olivertiller/KERS-bil/Konseptutvikling_D3.tex

% Delinnlevering D3: Konseptutvikling for lekebilen
% Henter innholdet direkte fra Sections/Concept_development.tex, slik at teksten holdes lik rapporten
\documentclass{article}

% Samme dokumentinnstillinger som rapporten
\usepackage{packages}

\begin{document}

% Enkel tittel i stedet for full tittelside
\begin{center}
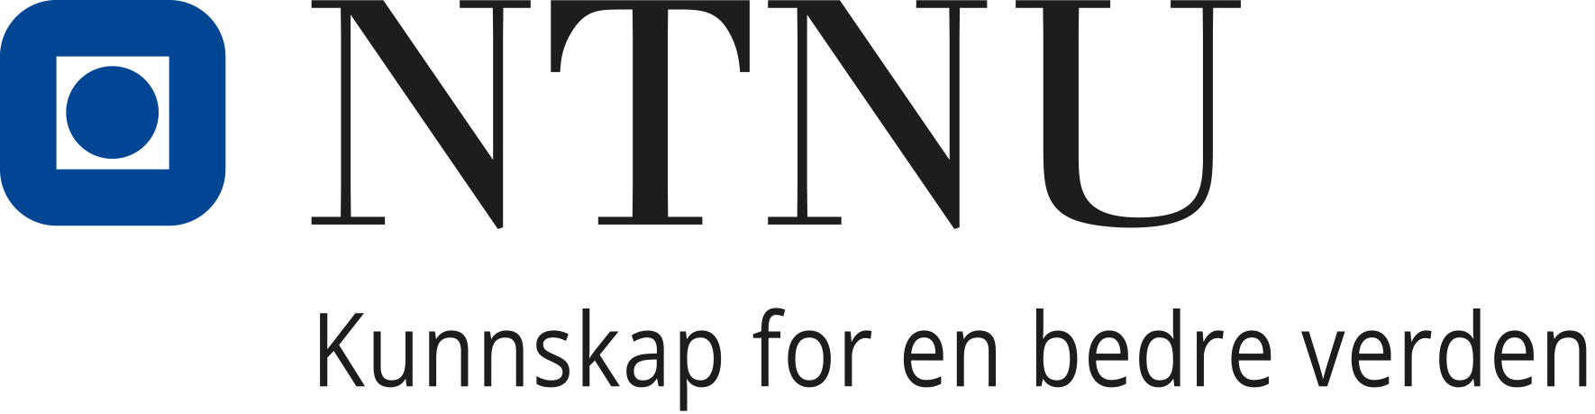
[picture p1: Images/NTNU_logo.png]
\\[0.5cm]
\textsc{\large Semesteroppgave MAST1101 -- høsten 2026}\\[0.3cm]
\HRule \\[0.3cm]
{\LARGE \bfseries Svinghjulsdrevet lekebil}\\[0.2cm]
{\Large D3: Konseptutvikling}\\[0.1cm]
\HRule \\[0.5cm]
{\large Oliver Kvaløy Tiller}\\[0.2cm]
{\large \today}
\end{center}
\vspace{0.3cm}

\import{./Sections/}{Concept_development}

\end{document}
