olivertiller/KERS-bil/Rapport/main.tex

% Author - Jon Arnt Kårstad, NTNU IMT
\documentclass{article}

% Importing document settings from our file "packages.sty"
\usepackage{packages}

% Beginning of document
\begin{document}

% Inserting title page
\hypersetup{pageanchor=false}
\import{./}{title}

% Defining front matter settings (Norsk: innstillinger for forord m.m.)
\frontmatter
\hypersetup{pageanchor=true}

% Forord og sammendrag
\import{./Sections/}{Preface}
\newpage
\import{./Sections/}{Summary}
\newpage

% Inserting table of contents
\tableofcontents

% Inserting list of figures & list of tables
\listoffigures
\listoftables

% Defining main matter settings (Norsk: innstillinger for hoveddelen av teksten)
\mainmatter

% Rapportens hoveddeler, etter IMRaD
% Introduksjon
\import{./Sections/}{Introduction}
\import{./Sections/}{Theory}

% Metode: produktutvikling, konsepter, utvikling av valgt konsept og testmetode
\import{./Sections/}{Product_requirements}
\import{./Sections/}{Product_development}
\import{./Sections/}{Project_planning}
\import{./Sections/}{Concept_development}
\import{./Sections/}{Concept_evaluation}
\import{./Sections/}{Detailed_design}
\import{./Sections/}{Prototyping}
\import{./Sections/}{Experimental_method}

% Resultater
\import{./Sections/}{Results}

% Diskusjon og konklusjon
\import{./Sections/}{Discussion}
\import{./Sections/}{Future_work}
\import{./Sections/}{Conclusion}
\import{./Sections/}{AI_use}

% Printing bibliography
\newpage
\printbibliography[heading = bibintoc, title = Referanser]    % 'bibintoc' inserts our bibliography into the table of contents

% Inserting appendix with separate settings
\addappendix
\import{./Appendices/}{Project_appendices}

% End of document
\end{document}
