olivertiller/KERS-bil/Rapport/title.tex

% Inspired by title template from ShareLaTeX Learn; Gubert Farnsworth & John Doe
% Edited by Jon Arnt Kårstad, NTNU IMT

\begin{titlepage}
\vbox{ }
\vbox{ }
\begin{center}
% Upper part of the page
\\[1cm]
\textsc{\LARGE Norges teknisk-naturvitenskapelige universitet}\\[1.5cm]
\textsc{\Large Semesteroppgave MAST1101 -- høsten 2026}\\[0.5cm]
\vbox{ }

% Title
\HRule \\[0.4cm]
{ \huge \bfseries Svinghjulsdrevet lekebil}\\[0.4cm]
\HRule \\[1.5cm]

% Author
\large
\emph{Forfatter:}\\
Oliver Kvaløy Tiller
\vfill

% Bottom of the page
{\large Høsten 2026}
\end{center}
\end{titlepage}
