olivertiller/KERS-bil/Rapport/Sections/AI_use.tex

\newpage
\section{Bruk av kunstig intelligens}
\label{sec:ki}
Claude (Anthropic) er brukt som programmeringsassistent i Claude Code. Verktøyet er brukt til:
\begin{itemize}
    \item Det enkle simuleringsskriptet for kjøringen og behandlingen av måledataene fra utsnurringen.
    \item Programmet for ESP32-en som logger Hall-sensoren, og skriptene som leser dataene over USB.
    \item Hjelp med oppsettet for generativ design og drivverket i Fusion.
    \item Generering av figurer, blant annet plottene av måledataene, prosessfiguren og kraftskissen.
    \item Finne skrivefeil, lage forbedrede tekstformuleringer og omstrukturering av rapportens disposisjon.
\end{itemize}
