olivertiller/KERS-bil/Rapport/Sections/Summary.tex

\section*{Sammendrag}
\addcontentsline{toc}{section}{Sammendrag}
Rapporten beskriver utviklingen av en lekebil som drives av et utdelt stålsvinghjul på Ø60 × 6 mm, og som skal kjøre lengst mulig etter ett opptrekk med 20 cm snor. Problemstillingen er om bilen, utviklet gjennom iterative prototyper innenfor rammene i oppgaven, kan kjøre minst \SI{5}{m} i snitt over ti kjøringer, med under \SI{15}{\percent} spredning og et sideavvik under \SI{10}{\percent} av lengden.

Tre konsepter ble vurdert i en vektet matrise: direkte drift, en trinnløs reim på kjegler og ett fast tannhjulstrinn. Tannhjulstrinnet ble valgt, med 17 : 73 ($i = 4{,}29$), Ø68-hjul og tre Ø6-aksler i 626-lagre. Den ferdige bilen veier \SI{270}{g}. Rammen er laget med generativ design i Fusion og 3D-printet i ett stykke. Lagersetet, festet av nav på aksel, snortrommelen og hjulene ble utviklet i små iterasjoner med prøvebiter. En enkel simulering ble brukt til å sammenligne alternativer, og en ESP32 med Hall-sensor ble brukt som hjelpeverktøy for å måle turtallet til svinghjulet.

Opptrekk med snor ga rundt \SI{2700}{o/min}, uavhengig av trommeldiameteren, og lagrene på svinghjulsakselen ga en åttendedel av det opprinnelige tapet etter at tetningene og fettet var fjernet og lagrene var kjørt inn.

I den første kjøretesten kjørte bilen \SI[separate-uncertainty=true]{5,5 \pm 1,4}{m} i fem forsøk og dro til venstre i fire av dem. En papirtest viste at den printede rammen er vridd, slik at høyre drivhjul bærer mesteparten av lasten og tar mest av drivkraften. Etter at lagersetet for høyre drivhjul ble filt for å jevne ut lasten, kjørte bilen \SI[separate-uncertainty=true]{8,8 \pm 1,8}{m} i ti forsøk, med \SI{21}{\percent} spredning, og alle ti var vellykkede. Målene for distanse og pålitelighet er dermed nådd. Bilen dro fortsatt til venstre, med et sideavvik på \SI{24}{\percent} av lengden, og verken spredningen eller sideavviket oppfyller målene. De neste tiltakene er en foraksel som kan vippe, eller tre hjul, og et jevnere opptrekk.

\begin{center}
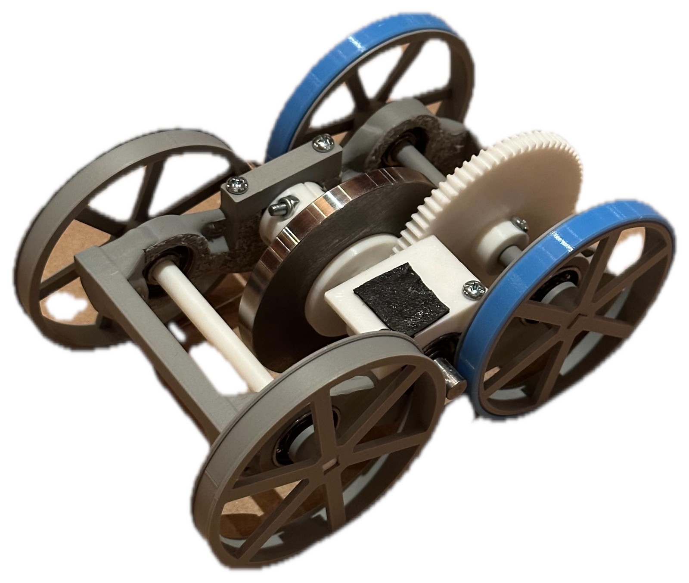
[picture p2: Rapport/Images/Foto/Ferdig/bil_sammendrag.jpg]
    
    \captionof*{figure}{Den ferdige bilen.}
\end{center}
