olivertiller/KERS-bil/Rapport/Sections/Prototyping.tex

\subsection{Prototyping og produksjon}
\label{sec:prototyping}
De fysiske delene er lagersetet, festet mellom nav og aksel, snortrommelen og drivhjulene. De er utviklet etter metoden i seksjon~\ref{sec:iterativ-prototyping}, og alle bygger på drivverket fra seksjon~\ref{sec:dv-serien}. Figur~\ref{fig:prototype} viser prototypen slik den er brukt i utsnurringstestene, med den generative rammen fra seksjon~\ref{sec:gd-ramme}, svinghjul, tannhjulspar og måleoppsett.

\begin{figure}[H]
    \centering
    \begin{subfigure}[b]{0.56\textwidth}
        \centering
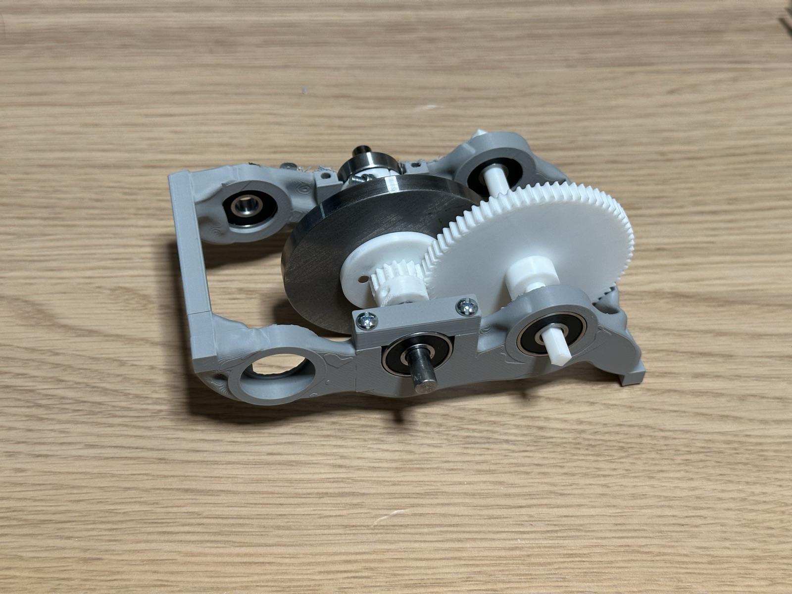
[picture p3: Rapport/Images/Foto/prototype_skraatt.jpg]
        
        \caption{Skrått forfra}
    \end{subfigure}
    \hspace{1.5em}
    \begin{subfigure}[b]{0.315\textwidth}
        \centering
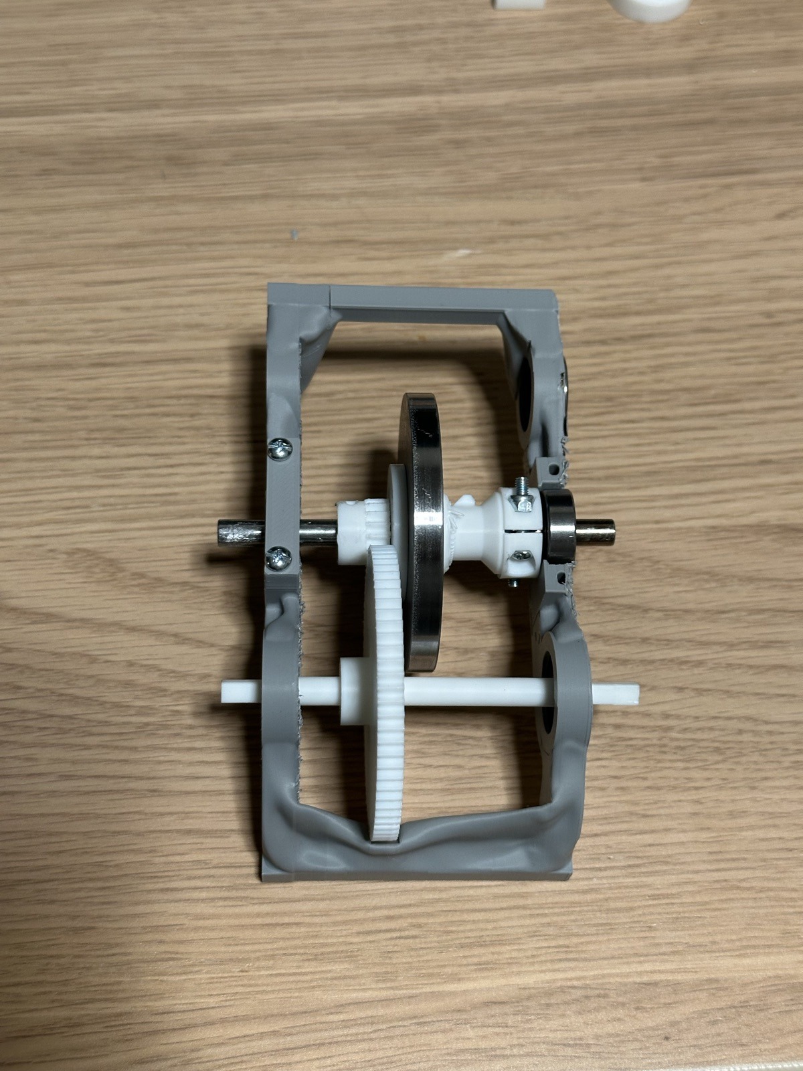
[picture p4: Rapport/Images/Foto/prototype_ovenfra.jpg]
        
        \caption{Ovenfra}
    \end{subfigure}
    \caption[Prototypen i den 3D-printede rammen]{Prototypen med svinghjul, pinjong og tannhjul i den 3D-printede rammen.}
    \label{fig:prototype}
\end{figure}

\subsubsection{Lagersete}
\label{sec:ls-serien}
De seks 626-lagrene har ytterdiameter \SI{19}{mm} og sitter i rammen. Setet må holde lageret fast uten å klemme det så hardt at det går tungt. Siden 3D-printede hull krymper litt, kan ikke nominelle mål fra CAD brukes direkte. Det ble derfor printet fem prøveringer fra Ø18,9 til Ø19,3 mm i trinn på \SI{0,1}{mm}, merket med ett til fem hakk og printet i samme retning som rammen (figur~\ref{fig:lager-proevering}).

% TODO: Bilde av alle prøvebitene
Ø19,0 gikk stramt inn, mens Ø19,1 var passe romslig og ble valgt i rammen (seksjon~\ref{sec:gd-ramme}).

\begin{figure}[H]
    \centering
    
    \caption[Prøvering for lagersetet]{626-lager i en av prøveringene for lagersetet.}
    \label{fig:lager-proevering}
\end{figure}

\begin{comment}
\begin{table}[H]
    \centering
    \caption{Målt diameter på lagerseter i prøvebiten}
    \label{tab:ls0-toleranse}
    \small
    \renewcommand{\arraystretch}{1.3}
    \begin{tabular}{|c|c|c|l|}
        \hline
        \textbf{Tegnet [mm]} & \textbf{Målt [mm]} & \textbf{Avvik [mm]} & \textbf{Pasning med lager} \\
        \hline
        18,8 & & & \\
        \hline
        18,9 & & & \\
        \hline
        19,0 & & & \\
        \hline
        19,1 & & & \\
        \hline
        19,2 & & & \\
        \hline
        19,3 & & & \\
        \hline
        19,4 & & & \\
        \hline
    \end{tabular}
\end{table}

\begin{versjonstabell}{lagersetet}{tab:ls1}
    \hovedtest
    Lageret sitter fast og går lett (R8) & \\
    \tilleggstester
    Lageret kan tas ut og settes inn igjen (R7) & \\
    Akslene er parallelle etter montering & \\
\end{versjonstabell}
\end{comment}

\subsubsection{Feste av nav på aksel}
\label{sec:nv-serien}
Pinjongen, tannhjulet, trommelen og hjulene festes til Ø6-akslene. Delene kan ikke ha D-hull, fordi de må tres forbi de runde lagersetene på akselen.

\begin{description}
    \item[Klemnav.] Brukes på trommelen og pinjongen (figur~\ref{fig:klemnav}). Navet er Ø20 med Ø6,2-hull og to slisser på \SI{1}{mm}. To M3 × 12-skruer går på tvers av slissene og strammes mot muttere i sekskantlommer. Skruene er plassert 180° fra hverandre for å holde navet i balanse. Navet kan løsnes og skyves langs akselen, noe som gjør det mulig å justere delene sideveis (R7).
    \item[Firkantnav.] Brukes på hjulene. Hjulakslene er 3D-printet med Ø6 og har en firkant på 4 × 4 × \SI{10}{mm} i hver ende. Diagonalen er \SI{5,66}{mm}, mindre enn Ø6. Hjulet tres på firkanten og kan ikke slure.
\end{description}

Firkanthullet ble bestemt med en prøvebit på samme måte som lagersetet, med fire hull fra \SI{4,0}{mm} til \SI{4,3}{mm} i trinn på \SI{0,1}{mm}, merket med én til fire streker. Hullet på \SI{4,3}{mm} ga best pasning på den printede akselenden og er brukt i hjulene. Hullene har små fristikk i hjørnene for at firkanten på akselen skal gå helt inn.

\begin{figure}[H]
    \centering
    \begin{subfigure}[b]{0.42\textwidth}
        \centering
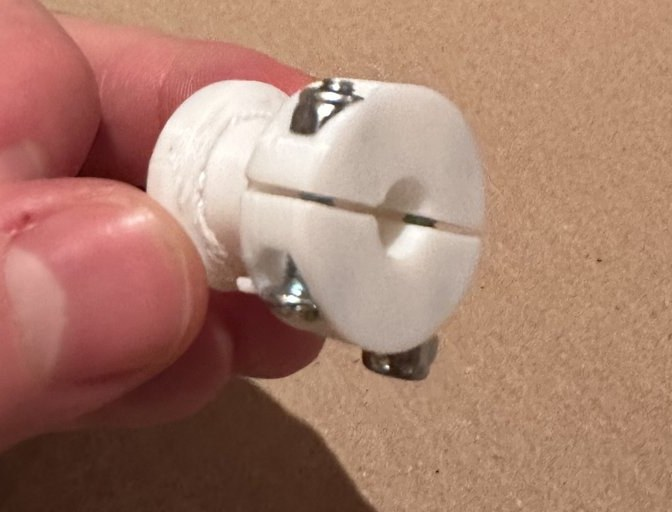
[picture p5: Rapport/Images/Foto/Ferdig/klemnav.jpg]
        
        \caption{Klemnav på snortrommelen}
        \label{fig:klemnav}
    \end{subfigure}
    \hspace{1.5em}
    \begin{subfigure}[b]{0.3\textwidth}
        \centering
        
        \caption{Prøvebit for firkanthullet}
        \label{fig:firkanttest}
    \end{subfigure}
    \caption[Klemnav og prøvebiten for firkanthullet]{(a) Klemnavet med to slisser og to M3-skruer på tvers. (b) Prøvebiten for firkanthullet. Strekene viser størrelsen, fra én strek for \SI{4,0}{mm} til fire for \SI{4,3}{mm}.}
    \label{fig:nav}
\end{figure}

\begin{comment}
\begin{versjonstabell}{firkantnavet}{tab:nv2}
    \hovedtest
    Hjulet slurer ikke på akselen (R6) & \\
    \tilleggstester
    Kan demonteres og monteres flere ganger (R7) & \\
\end{versjonstabell}
\end{comment}

\subsubsection{Snortrommel}
\label{sec:tr-serien}
Svinghjulet spinnes opp med \SI{20}{cm} snor rundt en trommel på svinghjulsakselen. Ved \SI{4000}{o/min} har svinghjulet energien $E = \frac{1}{2} I \omega^2 \approx \SI{5,3}{J}$. Over \SI{20}{cm} snor tilsvarer det en snittkraft på $E/L \approx \SI{26}{N}$, uavhengig av trommelens diameter. Trommelradien $r_t$ bestemmer derimot hvor fort snora må trekkes, siden $v = \omega r_t$. En mindre trommel gir høyere turtall ved samme trekkhastighet, men kraften som trengs underveis øker. Hypotesen er at én trommeldiameter gir høyest turtall for et opptrekk for hånd.

Det er tegnet tre tromler med kjerne Ø12, Ø14 og Ø18, ellers like. Maskintegningen av Ø12-trommelen står i vedlegg~\ref{app:tegninger} (figur~\ref{fig:snortrommel}). Snora festes med en løkke på en liten krok midt i kjernen som peker mot rotasjonsretningen under opptrekket (detalj E), slik at kroken holder løkka på plass så lenge snora strammes. Både undersiden av kroken og innsiden av den ytre flensen har 45° helning for at trommelen skal kunne printes uten support. Den indre flensen har en utsparing som gir plass til sveisekransen mellom svinghjulet og akselen. Trommelen festes med klemnavet fra seksjon~\ref{sec:nv-serien} og veier \SI{3,7}{g}.

For å se om en mindre trommel gir høyere turtall, ble det også laget en trommel med Ø8-kjerne, den minste boringen tillater. Den har et V-formet spor, siden snora legger seg i flere lag, og en skrå tapp i stedet for kroken. Med samme trekkhastighet skulle Ø8 gitt 1,5 ganger turtallet med Ø12.

Hovedtesten er turtallet etter opptrekk, målt med måleoppsettet i seksjon~\ref{sec:ml-serien}, med minst fem opptrekk per trommel. Snitt og standardavvik viser både turtall (R3) og repeterbarhet (R4). Tilleggstester er at snora løsner av seg selv fra trommelen ved enden av opptrekket, og at den ikke sklir av trommelen. Resultatene står i seksjon~\ref{sec:res-opptrekk}.

\begin{figure}[H]
    \centering
    \begin{subfigure}[b]{0.32\textwidth}
        \centering
        
        \caption{Klemnavet med de to M3-skruene}
    \end{subfigure}
    \hfill
    \begin{subfigure}[b]{0.32\textwidth}
        \centering
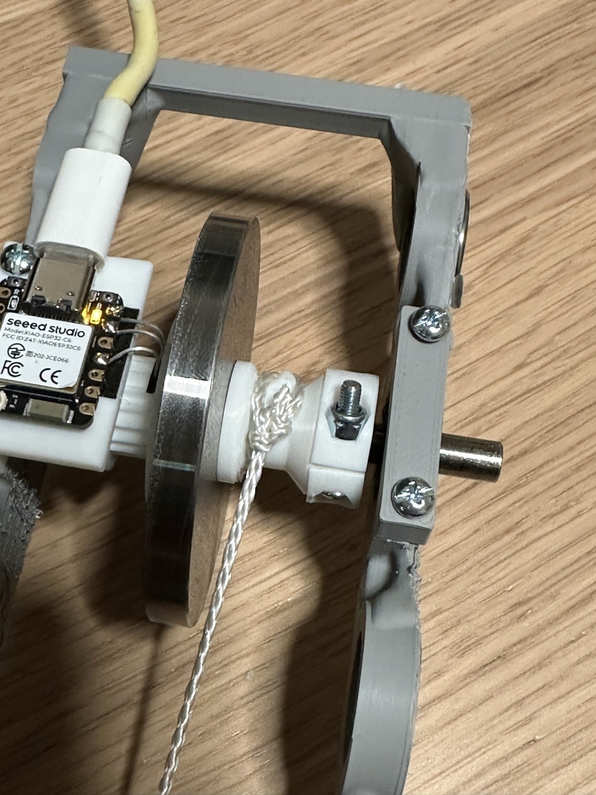
[picture p6: Rapport/Images/Foto/trommel_snor.jpg]
        
        \caption{Snora viklet på trommelen}
    \end{subfigure}
    \hfill
    \begin{subfigure}[b]{0.32\textwidth}
        \centering
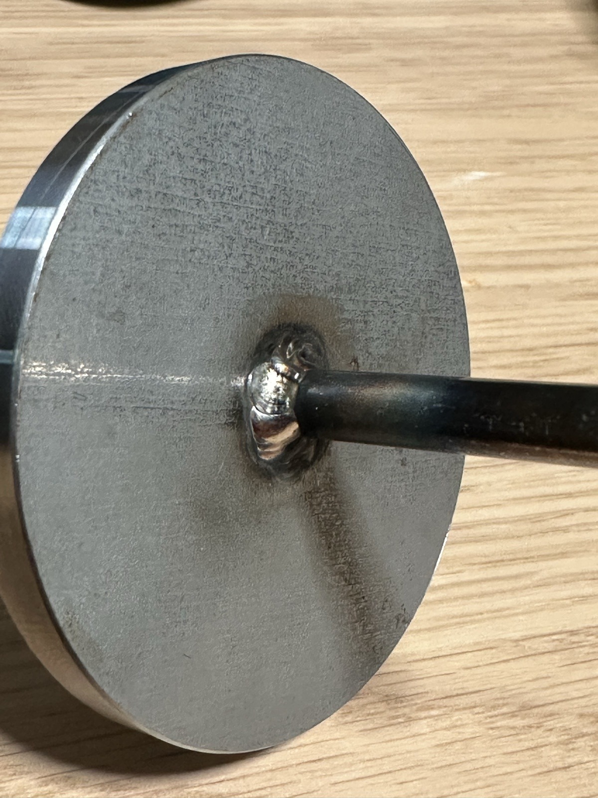
[picture p7: Rapport/Images/Foto/svinghjul_sveis.jpg]
        
        \caption{Sveisekransen mellom svinghjul og aksel}
    \end{subfigure}
    \caption[Ø12-trommelen på svinghjulsakselen]{Ø12-trommelen montert på svinghjulsakselen. Senkningen i den indre flensen gir plass til sveisekransen.}
    \label{fig:tr1-foto}
\end{figure}

\subsubsection{Drivhjul og dekk}
\label{sec:dh-serien}
Drivhjulene har ytre diameter \SI{68}{mm}, fastlagt i drivverket. Når bilen settes ned med svinghjulet i gang, slurer hjulene til farten passer med svinghjulet. Dekket bør derfor ha nok grep til at hjulene får tak raskt og bilen går rett, og samtidig lav rullemotstand.

Alle hjulene har samme nav. Maskintegningen av hjulet med TPU-dekk står i vedlegg~\ref{app:tegninger} (figur~\ref{fig:hjul}). Navet har firkanthullet fra seksjon~\ref{sec:nv-serien} og en krage med diameter \SI{7,8}{mm} på innsiden. Kragen ligger an mot innerringen i lageret, aldri mot ytterringen, og holder akselen på plass sideveis. Seks eiker i en \SI{2}{mm} skive på utsiden holder massen og treghetsmomentet nede, og hjulet printes liggende med utsiden ned.
\begin{description}
    \item[PLA-hjul uten dekk.] Hjul printet i ett stykke i PLA, med ytre diameter \SI{68}{mm}. Veier \SI{9,4}{g}.
    \item[TPU-dekk.] En PLA-felg med sete på Ø65 og skuldre på begge sider, og et \SI{1,5}{mm} tykt dekk printet i TPU. Dekket har \SI{0,6}{mm} mindre indre diameter enn setet og strekkes over felgen. Ferdig diameter er \SI{68}{mm}, og felg og dekk veier til sammen \SI{8,8}{g} (figur~\ref{fig:felg-foto}c).
\end{description}
PLA-hjulet uten dekk ble prøvd først, men hadde for lite grep mot gulvet. Ved nedsettingen spant drivhjulene lenge, og det meste av energien i svinghjulet gikk tapt til sluring før bilen fikk fart. Derfor brukes TPU-dekket på alle hjulene.

Treghetsmomentet for fire hjul er $\SI{2,9e-5}{kg.m^2}$ med Ø68-dekk og $\SI{2,6e-5}{kg.m^2}$ med Ø66-dekk, regnet fra CAD-geometrien. Det tilsvarer omtrent halvparten av svinghjulets treghetsmoment, men siden hjulene roterer $i$ ganger saktere, utgjør de en liten del av bilens effektive masse.

\begin{figure}[H]
    \centering
    \begin{subfigure}[b]{0.27\textwidth}
        \centering
        
        \caption{Felgen, utsiden}
    \end{subfigure}
    \hfill
    \begin{subfigure}[b]{0.27\textwidth}
        \centering
        
        \caption{Felgen, innsiden med navet og kragen}
    \end{subfigure}
    \hfill
    \begin{subfigure}[b]{0.38\textwidth}
        \centering
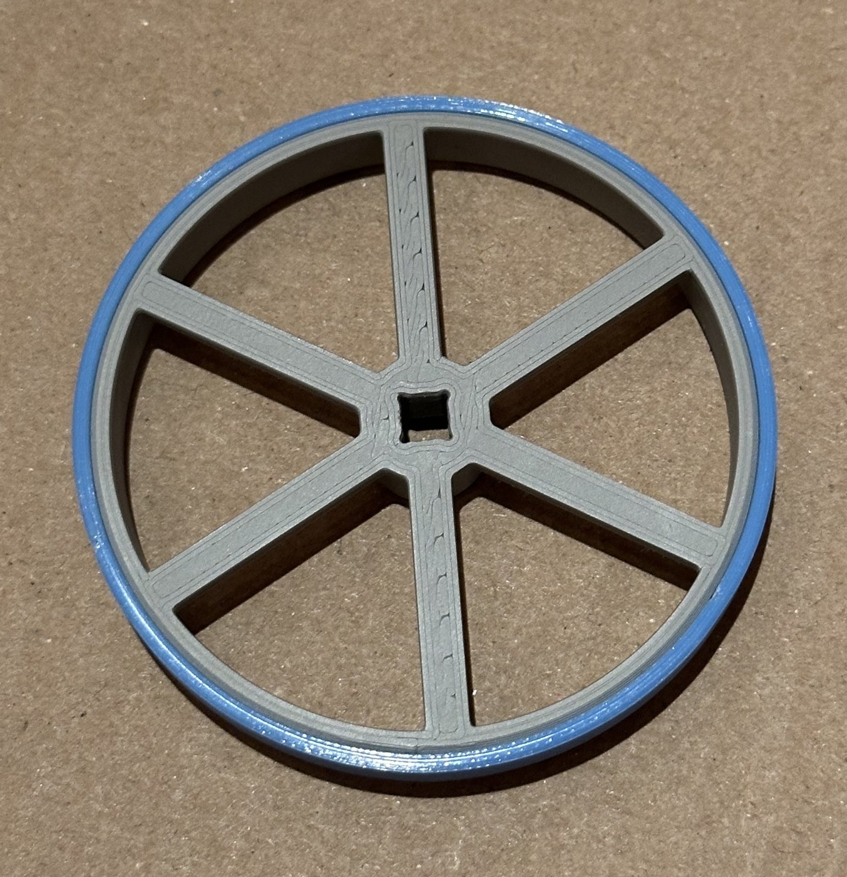
[picture p8: Rapport/Images/Foto/Ferdig/hjul_tpu.jpg]
        
        \caption{Med TPU-dekk}
    \end{subfigure}
    \caption[Printet hjul]{Printet hjul. (a) og (b) felgen uten dekk, (c) ferdig hjul med TPU-dekket strukket over felgen.}
    \label{fig:felg-foto}
\end{figure}

\begin{comment}
\begin{versjonstabell}{det bare hjulet}{tab:dh1}
    \hovedtest
    Kjøredistanse, snitt og standardavvik av 10 kjøringer (R3, R4) & \\
    \tilleggstester
    Sideavvik (R5) & \\
    Dekket sitter gjennom testserien & \\
    Slur ved nedsetting & \\
\end{versjonstabell}

% Samlet evaluering som tabell~\ref{tab:dv-samlet}, én tabell per serie når testene er gjort
\end{comment}

\subsubsection{Ferdig bil}
\label{sec:ferdig-bil}
Figur~\ref{fig:ferdig-bil} viser bilen slik den ble kjøretestet. Rammen er printet i PLA i ett stykke, og hjulene, tannhjulene, trommelen og hjulakslene er printet. Svinghjulet og akselen er de utdelte delene. Den ferdige bilen veier \SI{270}{g}.

\begin{figure}[H]
    \centering
    \begin{subfigure}[b]{0.52\textwidth}
        \centering
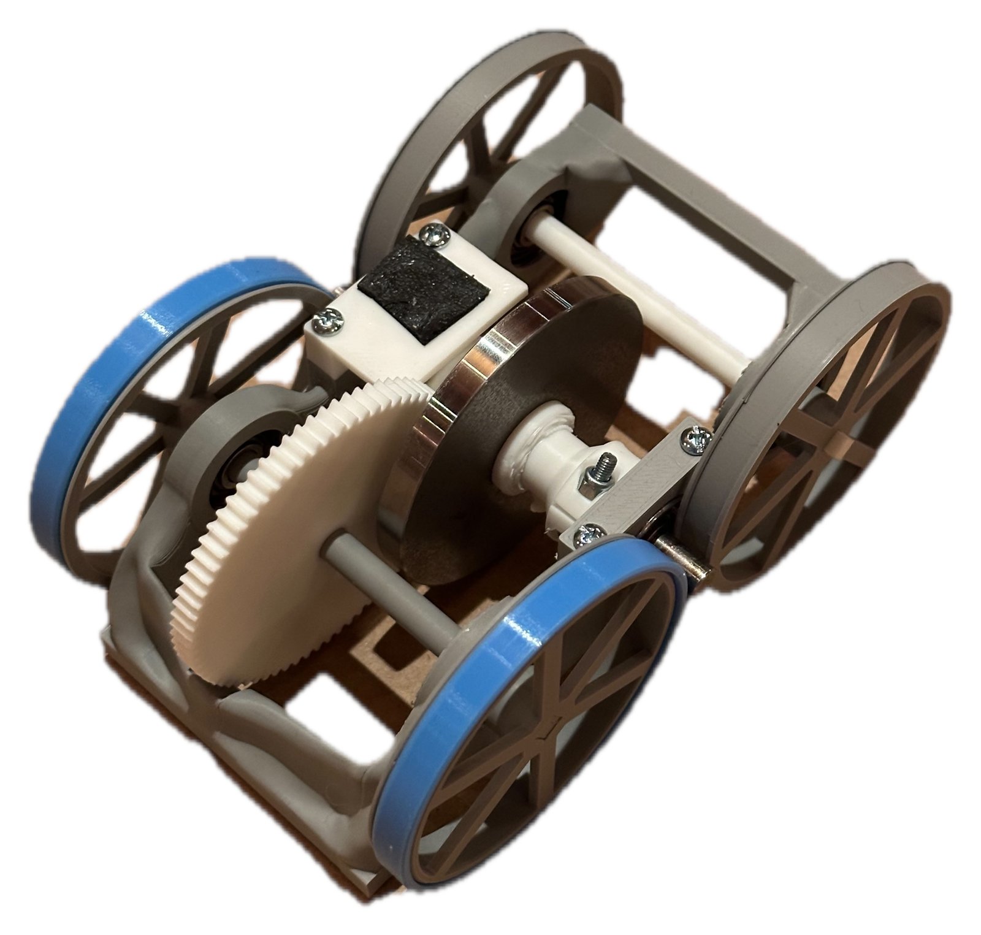
[picture p9: Rapport/Images/Foto/Ferdig/bil_skraatt.jpg]
        
        \caption{Skrått bakfra.}
    \end{subfigure}
    \hfill
    \begin{subfigure}[b]{0.4\textwidth}
        \centering
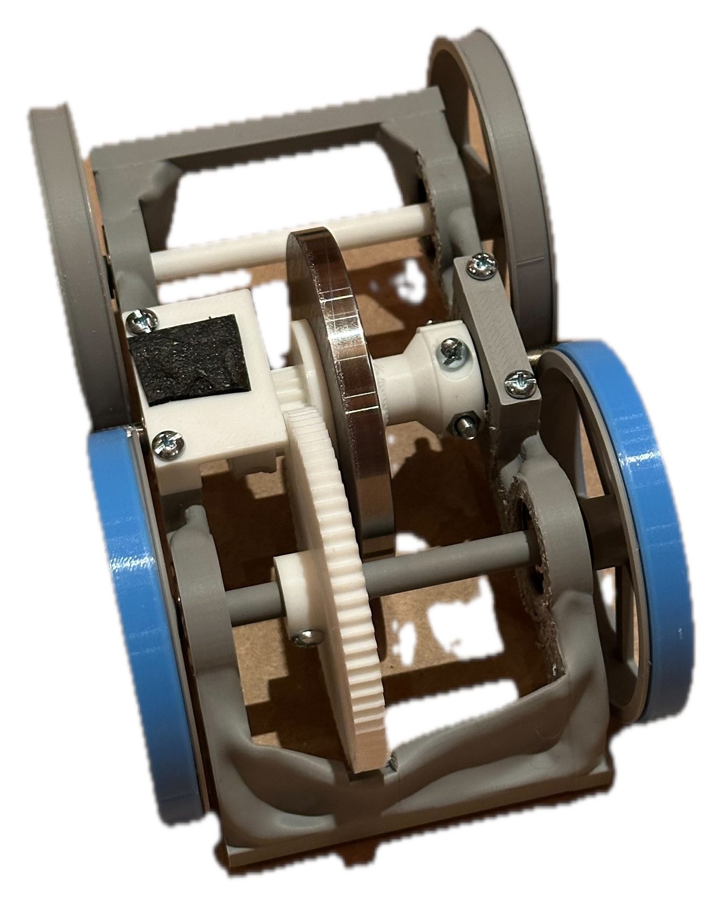
[picture p10: Rapport/Images/Foto/Ferdig/bil_ovenfra.jpg]
        
        \caption{Ovenfra}
    \end{subfigure}
    \caption[Den ferdige bilen]{Den ferdige bilen med generativ ramme, tannhjulspar 17\,:\,73 og Ø68-hjul med TPU-dekk.}
    \label{fig:ferdig-bil}
\end{figure}

Siden svinghjulet er sveiset fast på akselen, tres alle delene på svinghjulsakselen inn fra endene og monteres som én enhet (figur~\ref{fig:svinghjulsaksel}). Enheten senkes ned i U-setene i rammen, og lagerlokkene skrus over.

\begin{figure}[H]
    \centering
    \begin{subfigure}[b]{0.45\textwidth}
        \centering
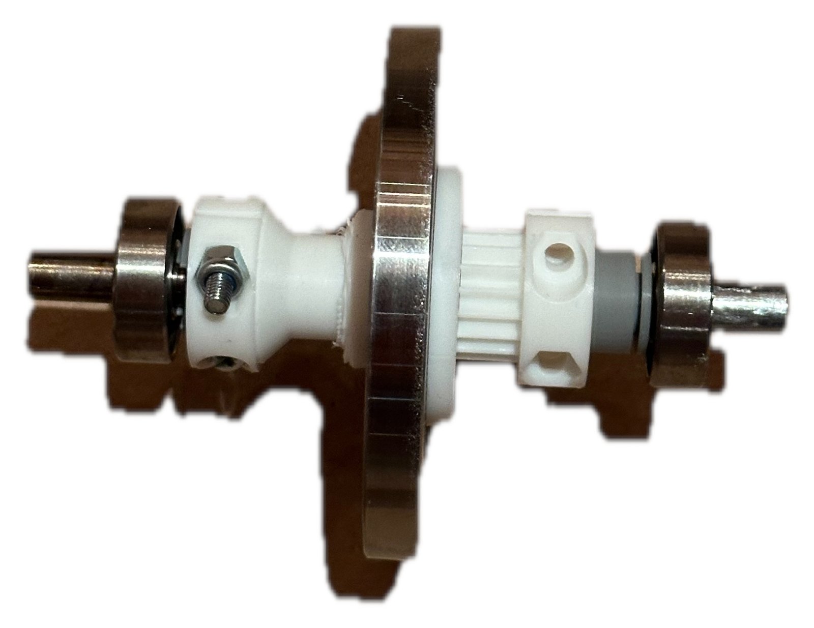
[picture p11: Rapport/Images/Foto/Ferdig/svinghjulsaksel.jpg]
        
        \caption{Montert}
    \end{subfigure}
    \hfill
    \begin{subfigure}[b]{0.45\textwidth}
        \centering
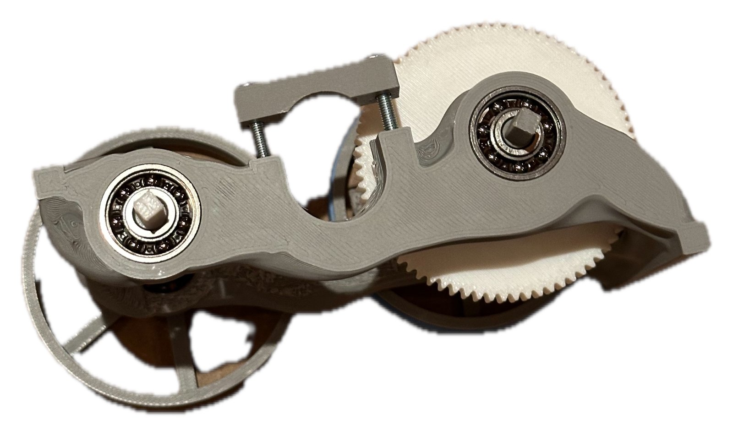
[picture p12: Rapport/Images/Foto/Ferdig/u_sete.jpg]
        
        \caption{Rammen fra siden, med lagrene i lagerhuset og U-setet}
    \end{subfigure}

    \vspace{0.6em}
    \begin{subfigure}[b]{\textwidth}
        \centering
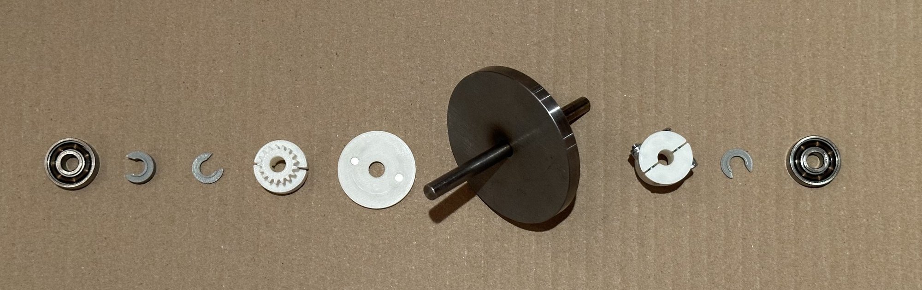
[picture p13: Rapport/Images/Foto/Ferdig/svinghjulsaksel_demontert.jpg]
        
        \caption{Demontert. Fra venstre: lager, avstandshylser, pinjong, magnetskive, svinghjulet med akselen, snortrommel, avstandshylse og lager.}
    \end{subfigure}
    \caption[Svinghjulsakselen]{Svinghjulsakselen.}
    \label{fig:svinghjulsaksel}
\end{figure}

\subsection{Problemløsning}
\label{sec:problemlosning}
Under testingen av den første prototypen dukket det opp tre problemer som krevde endringer:

\paragraph{Trommelen løsnet.} Klemnavet på trommelen sklei på akselen under den første serien. Det ble løst ved å kontrollere mutterne og stramme skruene jevnt (seksjon~\ref{sec:nv-serien}).

\paragraph{Svinghjulsakselen glir sideveis.} Med tannhjulet frakoblet varierte tapet mye fra opptrekk til opptrekk, og hvert opptrekk holdt et jevnt nivå hele veien ned. Det tydet på at noe gnisset med ulik kraft fra gang til gang. Akselen hadde for mye klaring sideveis, og avhengig av hvilken vei snora trakk, kom trommelen eller pinjongen borti noe. Tiltaket er to C-formede avstandshylser som klikkes på akselen uten at den tas ut av lagrene (figur~\ref{fig:svinghjulsaksel}c). En krage ligger an mot innerringen i lageret, som følger akselen rundt og dermed ikke gir ekstra friksjon. Lengden velges i trinn på \SI{0,5}{mm}, slik at akselen får 0,1 til \SI{0,3}{mm} klaring.

\paragraph{Tap i lagrene.} Utsnurringen viste at lagrene på svinghjulsakselen bremset svinghjulet merkbart. De opprinnelige 626 2RS-lagrene har kontakttetninger og fett. Derfor ble tre varianter til prøvd: de samme lagrene med tetningene tatt ut, fettet vasket ut og en tynn olje, de samme lagrene uten olje, og åpne SKF Explorer 626. Målingene står i seksjon~\ref{sec:res-tapsledd}.
