olivertiller/KERS-bil/Appendices/Project_appendices.tex

\subsection{Kravgrunnlag og prosjektlogg}
% Sett inn gjeldende oppgavegrunnlag og relevante avklaringer.
\subsection{Arbeidstegninger og deleliste}
\subsection{Testprotokoll og rådata}
\subsection{Bilder og dokumentasjon av prototypeversjoner}
