olivertiller/KERS-bil/Rapport/Images/Drivverk/drivverk_versjoner.pdf

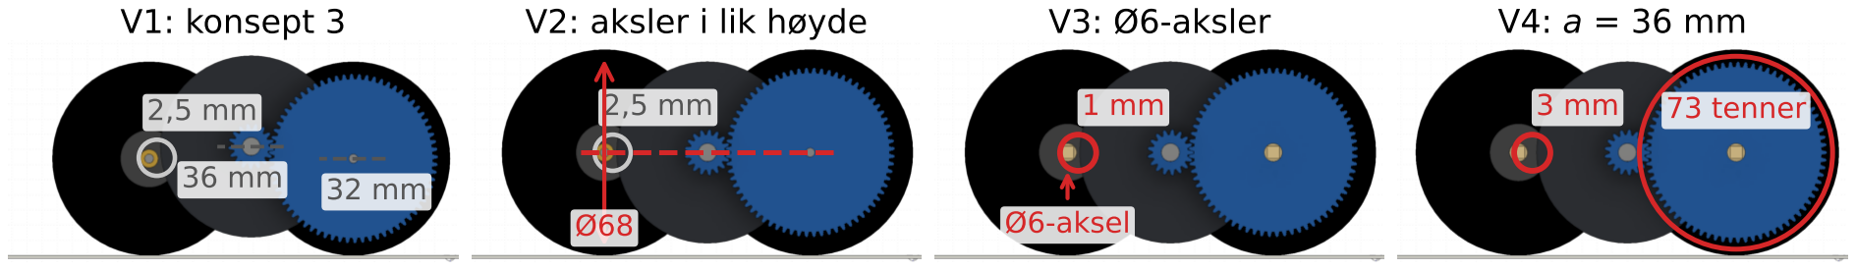
[picture p14: page 1]

2,5 mm
36 mm 32 mm

V1: konsept 3

2,5 mm

Ø68

V2: aksler i lik høyde

1 mm

Ø6-aksel

V3: Ø6-aksler

3 mm 73 tenner

V4: a = 36 mm
