olivertiller/KERS-bil/Rapport/Sections/Conclusion.tex

\section{Konklusjon}
\label{sec:konklusjon}
Problemstillingen var om bilen kan kjøre minst \SI{5}{m} i snitt over ti kjøringer, med under \SI{15}{\percent} spredning og et sideavvik under \SI{10}{\percent} av lengden. Etter den andre kjøretesten, med ti kjøringer, er målene for distanse og pålitelighet nådd, men ikke målene for spredning og sideavvik. Resultatmålene vurderes slik (tabell~\ref{tab:kravstatus}):
\begin{enumerate}
    \item \textbf{Funksjon og pålitelighet (R2, R6).} Bilen kjørte av seg selv og stoppet uten å treffe noe i alle ti forsøkene i den andre kjøretesten. Målet er nådd.
    \item \textbf{Kjøredistanse (R3).} Bilen kjørte \SI{8,8}{m} i snitt over ti kjøringer, og alle var over \SI{5}{m}. Målet er nådd.
    \item \textbf{Repeterbarhet (R4).} Spredningen var \SI{21}{\percent}, over grensen på \SI{15}{\percent}. Målet er ikke nådd.
    \item \textbf{Retningsstabilitet (R5).} Bilen dro til venstre i alle ti forsøkene, og sideavviket var i snitt \SI{24}{\percent} av lengden. Målet er ikke nådd.
    \item \textbf{Rammer og produksjon (R1, R7, R8).} Bilen bruker det utdelte svinghjulet og akselen, trekkes opp med 20 cm snor og holder seg innenfor $140 \times 85 \times 70$ mm. Alle delene er laget med 3D-printer og utstyret på verkstedet, og navene kan løsnes slik at drivverket kan demonteres og justeres. Målet er nådd.
\end{enumerate}

Sideavviket skyldes trolig at den printede rammen er litt vridd, slik at høyre drivhjul tar mest av drivkraften. Da lagersetet for høyre drivhjul ble filt for å jevne ut lasten, ble buene omtrent dobbelt så slake, men bilen dro fortsatt til venstre. For å nå R5 trengs trolig en foraksel som kan vippe, eller tre hjul. Spredningen kan forklares av at turtallet etter opptrekk for hånd varierer, og kan bare reduseres med et jevnere opptrekk.

For distansen betyr opptrekket og tapene mest. Opptrekk med snor ga rundt \SI{2700}{o/min} uavhengig av trommeldiameteren, omtrent en firedel av energien går tapt til sluring ved nedsetting, og lagrene på svinghjulsakselen ga en åttendedel av det opprinnelige tapet etter at tetningene og fettet var fjernet og lagrene var kjørt inn.

Iterasjonene med prøvebiter fungerte godt for delene som må passe sammen, men den vridde rammen ble først oppdaget da hele bilen ble kjørt. Bilen bør derfor prøves som helhet så tidlig som mulig.
