olivertiller/KERS-bil/Rapport/Sections/Discussion.tex

\section{Diskusjon og videre arbeid}
\label{sec:diskusjon}
\subsection{Diskusjon}
Diskusjonen følger problemstillingen: først kjøredistansen, deretter spredningen og sideavviket. Til slutt vurderes feilkildene og arbeidsprosessen.

\subsubsection{Kjøredistanse}
\label{sec:disk-lager}
\label{sec:disk-tapsledd}
\label{sec:disk-trommel}
Bilen kjørte \SI{8,8}{m} i snitt i den andre kjøretesten, og R3 er oppfylt. Opptrekket ga rundt \SI{2700}{o/min} mot antatt \SI{4000}{o/min}, altså under halvparten av den antatte energien. Ø8-trommelen ga omtrent samme turtall som Ø12 (seksjon~\ref{sec:res-opptrekk}), så det er kraften hånda gir over de \SI{20}{cm}, som begrenser opptrekket. Hypotesen i seksjon~\ref{sec:tr-serien} får dermed ikke støtte.

Av energien går \SI{24}{\percent} tapt til sluring ved nedsetting (likning~\eqref{eq:sluretap}), og mer hvis hjulene har for lite grep. Høyere utveksling gir mindre sluretap, men lengre kjøretid og mer tap i lagrene. Lagrene på svinghjulsakselen ga en åttendedel av det opprinnelige tapet etter at tetningene og fettet var fjernet og lagrene var kjørt inn, like lite som åpne SKF-lagre (seksjon~\ref{sec:res-tapsledd}).

At distansen økte med \SI{61}{\percent} fra den første til den andre kjøretesten, har trolig to årsaker. Lasten på drivhjulene ble jevnere, og i den første kjøretesten spant høyre drivhjul ved nedsettingen. I tillegg ble lagrene på svinghjulsakselen kjørt inn i de samme dagene, fra rundt 0,7 til \SI{0,2}{mN.m}.

\subsubsection{Spredning}
\label{sec:disk-spredning}
Spredningen var \SI{25}{\percent} og \SI{21}{\percent} i de to kjøretestene. Turtallet etter opptrekk varierte med omtrent \SI{11}{\percent}, som alene gir rundt \SI{20}{\percent} spredning i energi. Spredningen kan derfor forklares av opptrekket, og R4 kan trolig ikke nås uten et jevnere opptrekk.

\subsubsection{Sideavvik}
\label{sec:disk-kjoretest}
\label{sec:disk-kjoretest2}
R5 er ikke oppfylt, og sideavviket er det største problemet bilen har nå. Bilen svinger bare når svinghjulet driver den, så årsaken må ha med drivkraften å gjøre. Papirtesten viser at den printede rammen er litt vridd, slik at høyre drivhjul bærer mer last enn venstre. Drivhjulene sitter fast på samme aksel, og da tar hjulet med mest last mest av drivkraften og svinger bilen mot venstre (figur~\ref{fig:kraftskisse}).

\begin{figure}[H]
    \centering
    \begin{tikzpicture}[
        hjul/.style = {draw, rounded corners = 1.5pt, minimum width = 0.36cm, minimum height = 1.15cm, inner sep = 0pt},
        tung/.style = {hjul, fill = black!65},
        lett/.style = {hjul, fill = black!10},
        kraft/.style = {-latex', line width = 1.2pt, BrickRed},
    ]
        % ramme og aksler
        \draw[thick] (-1.27, -1.1) -- (1.27, -1.1);
        \draw[thick] (-1.27, 1.1) -- (1.27, 1.1);
        \draw[rounded corners = 3pt, fill = NavyBlue!8] (-0.95, -1.55) rectangle (0.95, 1.55);
        \node[font = \footnotesize, align = center] at (0, 0.95) {foran};
        \node[font = \footnotesize, align = center] at (0, -0.95) {drivaksel};
        % hjul
        \node[lett] (vb) at (-1.45, -1.1) {};
        \node[tung] (hb) at (1.45, -1.1) {};
        \node[tung] (vf) at (-1.45, 1.1) {};
        \node[lett] (hf) at (1.45, 1.1) {};
        % drivkrefter
        \draw[kraft] (2.0, -1.65) -- (2.0, 0.15) node[right, black] {$F_h$};
        \draw[kraft] (-2.0, -1.65) -- (-2.0, -1.0) node[left, black] {$F_v$};
        % moment og bane
        \draw[-latex', thick] (-50:0.5) arc (-50:230:0.5);
        \node at (0, 0) {$M$};
        \draw[dashed, -latex', thick] (0, 1.75) .. controls (0, 2.6) and (-0.3, 3.0) .. (-1.0, 3.4);
        % tegnforklaring
        \node[tung, minimum height = 0.3cm, minimum width = 0.3cm] at (3.4, 1.3) {};
        \node[right, font = \footnotesize] at (3.6, 1.3) {mest last};
        \node[lett, minimum height = 0.3cm, minimum width = 0.3cm] at (3.4, 0.8) {};
        \node[right, font = \footnotesize] at (3.6, 0.8) {minst last};
    \end{tikzpicture}
    \caption[Skjev hjullast og sideavvik]{Bilen sett ovenfra. Diagonalen høyre bak og venstre foran bærer det meste av vekten. Høyre drivhjul tar da mest av drivkraften, og forskjellen mellom $F_h$ og $F_v$ gir et moment $M$ som svinger bilen mot venstre.}
    \label{fig:kraftskisse}
\end{figure}

Filingen av lagersetet gjorde buene omtrent dobbelt så slake, men bilen dro fortsatt til venstre i alle ti forsøkene. For å nå R5 ved \SI{8,8}{m} må svingradiusen være over \SI{44}{m}, og det klarte bare forsøk 6. Den sikreste løsningen er en foraksel som kan vippe om midten, eller en trehjuling (seksjon~\ref{sec:videre-trehjul}), slik at alle hjulene får last uansett hvor vridd rammen er.

\subsubsection{Feilkilder}
\label{sec:disk-feilkilder}
\begin{description}
    \item[Opptrekket.] Svinghjulet trekkes opp for hånd, og turtallet ble ikke målt under kjøretestene. Energien bilen startet med, er derfor ukjent.
    \item[Antall forsøk.] Den første kjøretesten hadde fem forsøk, mens R3 krever ti, og i forsøk 2 traff bilen et bord.
    \item[To endringer samtidig.] Mellom kjøretestene ble både lagersetet filt og trommelen byttet, og lagrene ble kjørt inn. Bidragene kan ikke skilles fra hverandre.
    \item[Måling.] Lengden er målt som rett linje, som er kortere enn veien bilen kjørte i krappe buer. Bilen settes ned for hånd, og en liten feil i startretningen går rett inn i sideavviket.
    \item[Papirtesten.] Testen sammenligner lasten på hjulene, men tallfester den ikke.
\end{description}

\subsubsection{Arbeidsprosessen}
\label{sec:disk-prosess}
Iterasjonene med prøvebiter fungerte godt for delene som må passe sammen, men den vridde rammen kunne ikke oppdages i delprøvene. Svinghjulet ble først mottatt 2.~november 2026, og bilen kunne ikke kjøres før det var på plass. Den første kjøretesten kom derfor bare ni dager før innlevering. Erfaringen er at bilen må prøves som helhet så tidlig som mulig.

\begin{comment}
\subsubsection{Vurdering opp mot problemstilling og produktkrav}
\subsubsection{Betydningen av konsept- og designvalg}
\subsubsection{Testenes pålitelighet og begrensninger}
\subsubsection{Produktutviklingsprosess og forbedringsmuligheter}
% Skill mellom observasjoner, tolkninger og hypoteser som krever videre undersøkelser.
\end{comment}
