olivertiller/KERS-bil/Rapport/Sections/Introduction.tex

\section{Introduksjon}
\label{sec:introduksjon}
\subsection{Bakgrunn}
I semesteroppgaven i MAST1101 skal det utvikles og bygges en mekanisk lekebil med svinghjul som energilager. Målet er at bilen skal kjøre lengst mulig etter ett opptrekk med snor, og arbeidet omfatter produktutvikling, 3D-modellering, produksjon og testing av en fysisk prototype.

\subsection{Problemstilling}
\begin{quote}
Kan en svinghjulsdrevet lekebil, utviklet gjennom iterative prototyper innenfor rammene i oppgaven, kjøre minst \SI{5}{m} i snitt over ti kjøringer, med under \SI{15}{\percent} spredning og et sideavvik under \SI{10}{\percent} av kjørt lengde?
\end{quote}

\subsection{Målsetninger}
Problemstillingen er delt i fem resultatmål. Kravene i parentes er de samme som i kravspesifikasjonen (seksjon~\ref{sec:produktkrav}), og konklusjonen svarer på målene i samme rekkefølge. Den første kjøretesten ble brukt som referansemåling, og grensene for distanse, spredning og sideavvik ble satt etter den. Den andre kjøretesten avgjør om målene er nådd.
\begin{enumerate}
    \item \textbf{Funksjon og pålitelighet (R2, R6).} Bilen kjører av seg selv etter opptrekk i minst 9 av 10 forsøk.
    \item \textbf{Kjøredistanse (R3).} Gjennomsnittlig lengde er minst \SI{5}{m} over ti kjøringer.
    \item \textbf{Repeterbarhet (R4).} Standardavviket er under \SI{15}{\percent} av snittet.
    \item \textbf{Retningsstabilitet (R5).} Sideavviket er under \SI{10}{\percent} av lengden i snitt.
    \item \textbf{Rammer og produksjon (R1, R7, R8).} Bilen holder seg innenfor rammene i oppgaven, kan lages med utstyret som er tilgjengelig, og kan demonteres og justeres.
\end{enumerate}

\begin{comment}
\subsection{Effektmål}
% Beskriv hva prosjektet skal oppnå utover selve prototypen, for eksempel læringsutbytte innen produktutvikling og et grunnlag for det videre arbeidet våren 2027.
\end{comment}

\subsection{Begrensninger}
Dette semesteret omfatter utvikling av bilen, herunder konseptutvikling og konseptvalg, CAD-modellering, produksjon, montering og grunnleggende eksperimentell testing.

Detaljert dynamisk og kinematisk modellering, validering av modellen og modellbasert optimalisering av drivverket avgrenses til MAST2007 våren 2027, der den samme bilen brukes videre. En enkel numerisk simulering brukes likevel i høst, men bare som et verktøy for å sammenligne alternativer i iterasjonene (seksjon~\ref{sec:simulering-verktoy}). Høstens tester skal evaluere funksjon og ytelse og gi et sammenligningsgrunnlag for videre arbeid.
