olivertiller/KERS-bil/Rapport/Sections/Product_requirements.tex

\section{Produktutviklingsprosessen}
\label{sec:pu-prosess}
Figur~\ref{fig:pu-prosess} viser gangen i prosjektet, fra krav og konsepter til prototype og to kjøretester. Dette kapittelet tar for seg kravene til bilen, metoden for iterativ prototyping og prosjektplanen.

\begin{figure}[H]
    \centering
    \begin{tikzpicture}[
        steg/.style = {draw = NavyBlue, fill = NavyBlue!10, rounded corners = 2pt, align = center,
                       text width = 2.3cm, minimum height = 1.35cm, font = \footnotesize},
        test/.style = {steg, draw = BrickRed, fill = BrickRed!10},
        pil/.style  = {-latex', thick},
    ]
        \node[steg] (krav)  at (0, 0)     {Produktkrav\\(\ref{sec:produktkrav})};
        \node[steg] (kons)  at (3.05, 0)  {Tre konsepter og konseptvalg\\(\ref{sec:konseptutvikling})};
        \node[steg] (dv)    at (6.1, 0)   {Drivverk i CAD\\(\ref{sec:dv-serien})};
        \node[steg] (ramme) at (9.15, 0)  {Ramme med generativ design\\(\ref{sec:gd-ramme})};
        \node[steg] (deler) at (12.2, 0)  {Deler og prøvebiter\\(\ref{sec:prototyping})};
        \node[test] (maal)  at (0, -2.3)    {Opptrekk og tap\\(\ref{sec:res-opptrekk}, \ref{sec:res-tapsledd})};
        \node[test] (kt1)   at (3.05, -2.3) {Første kjøretest\\(\ref{sec:res-kjoretest})};
        \node[test] (tiltak) at (6.1, -2.3) {Papirtest og filing av lagersete\\(\ref{sec:res-kjoretest}, \ref{sec:res-kjoretest2})};
        \node[test] (kt2)   at (9.15, -2.3) {Andre kjøretest\\(\ref{sec:res-kjoretest2})};
        \node[test] (status) at (12.2, -2.3) {Status for kravene\\(\ref{sec:res-kravstatus})};
        \draw[pil] (krav) -- (kons);
        \draw[pil] (kons) -- (dv);
        \draw[pil] (dv) -- (ramme);
        \draw[pil] (ramme) -- (deler);
        \draw[pil] (deler.south) -- ++(0, -0.45) -| (maal.north);
        \draw[pil] (maal) -- (kt1);
        \draw[pil] (kt1) -- (tiltak);
        \draw[pil] (tiltak) -- (kt2);
        \draw[pil] (kt2) -- (status);
    \end{tikzpicture}
    \caption[Gangen i prosjektet]{Gangen i prosjektet, med seksjonen der hvert steg er beskrevet. Utviklingen er blå og testingen rød.}
    \label{fig:pu-prosess}
\end{figure}

\subsection{Produktkrav}
\label{sec:produktkrav}
Kravspesifikasjonen skiller mellom rammene i oppgavebeskrivelsen (R1), som er obligatoriske, og egne mål for ytelse og konstruksjon (R2--R8). Akseptgrensene for R3--R6 ble satt etter den første kjøretesten, som ble brukt som referansemåling (seksjon~\ref{sec:res-kjoretest}).

\begin{description}
    \item[R1: Oppgitte rammer.] Ytre mål skal ikke overstige $140 \times 85 \times 70$ mm. Det utdelte stålsvinghjulet (Ø60 × 6 mm) og den utdelte akselen (Ø6 × 65 mm) skal brukes, og bilen trekkes opp med 20 cm tråd. Kontrolleres ved måling.
    \item[R2: Funksjon.] Bilen skal kjøre selvstendig etter opptrekk.
    \item[R3: Hovedmål.] Størst mulig gjennomsnittlig kjøredistanse ved standardisert opptrekk, og minst \SI{5}{m}. Vurderes med minst 10 kjøringer.
    \item[R4: Repeterbarhet.] Standardavviket for kjøredistansen er under \SI{15}{\percent} av snittet.
    \item[R5: Retningsstabilitet.] Sideavviket er i snitt under \SI{10}{\percent} av lengden, målt etter prosedyren i seksjon~\ref{sec:metode-kjoretest}.
    \item[R6: Pålitelighet.] Minst 9 av 10 opptrekk gir en vellykket kjøring, det vil si at bilen kjører av seg selv etter nedsettingen og stopper uten å treffe noe.
    \item[R7: Justerbarhet.] Drivverket bør kunne demonteres og justeres, og utveksling og hjul bør kunne endres uten fullstendig redesign.
    \item[R8: Produksjon.] Bilen skal kunne fremstilles med tilgjengelige produksjonsmetoder.
\end{description}
