olivertiller/KERS-bil/Rapport/Sections/Detailed_design.tex

\section{Utvikling av valgt konsept}
\label{sec:utvikling}
Konsept 3 er utviklet videre i tre steg. Først ble drivverket lagt opp i CAD. Deretter ble rammen laget rundt drivverket med generativ design, og til slutt ble de fysiske delene tilpasset med prøvebiter og satt sammen til en ferdig bil.

\begin{comment}
\subsection{Generelt om designet}
% Beskriv systemoppsettet og vis sammenstillingsmodellen fra CAD.

\subsection{3D-modelleringsprosessen}
% Beskriv modelleringsarbeidet, dimensjoneringskriteriene og kontrollene som brukes.

\subsection{Komponentene}
\subsubsection{Chassis, hjul, akslinger og lager}
\subsubsection{Svinghjul, transmisjon og opptrekksmekanisme}
\subsubsection{Materialvalg, toleranser og klaringer}
% Produksjonstegninger og deleliste legges i vedlegg. Henvis til dem her og vurder monterbarheten.
\end{comment}

\subsection{Iterasjoner av drivverket}
\label{sec:dv-serien}
Før noe ble produsert, ble drivverket justert i CAD i fire versjoner. I hver versjon ble det kontrollert at svinghjulet går klar av akslene med minst \SI{3}{mm} og av underlaget, og at bilen holder seg innenfor \SI{140}{mm} (R1). Den enkle simuleringen fra seksjon~\ref{sec:simulering-verktoy} ble brukt for å se at endringene ikke kostet kjøredistanse. Versjonene er vist i figur~\ref{fig:dv-versjoner} og oppsummert i tabell~\ref{tab:dv-samlet}.

\begin{figure}[H]
    \centering
    
    \caption[Versjonene av drivverket i CAD]{Versjonene av drivverket i CAD, sett fra tannhjulssiden med de nærmeste hjulene og lagrene skjult. Sirkelen viser klaringen mellom svinghjulet og forakselen. Rødt markerer det som er endret fra forrige versjon.}
    \label{fig:dv-versjoner}
\end{figure}

Utgangspunktet i versjon 1 var konsept 3, med en pinjong med 17 tenner og et tannhjul med 68 tenner (modul 0,8), som gir akseavstanden $a = 0{,}8 \cdot (17 + 68)/2 = \SI{34}{mm}$. Drivhjulene var Ø64, og hjulakslene var Ø3 sveisetråd. Svinghjulsakselen lå \SI{36}{mm} over underlaget og hjulakslene \SI{32}{mm}, slik at de tre akslene ikke lå på linje.

I versjon 2 ble alle akslene lagt \SI{34}{mm} over underlaget. Da ligger alle lagersetene på én linje i rammen, og drivhjulene ble Ø68. % Sjekk: var dette grunnen til at akslene ble lagt i samme høyde?
Større hjul med samme utveksling gjør bilen litt raskere ved samme turtall på svinghjulet, men den simulerte distansen ble nesten den samme, \SI{9,2}{m} mot \SI{9,3}{m}. Klaringen mellom svinghjulet og hjulakselen var \SI{2,5}{mm}, litt under målet. Et større problem var at Ø3-akslene trengte en hylse for å passe i 626-lagrene, som har \SI{6}{mm} innvendig diameter.

Derfor ble alle hjulakslene byttet til 3D-printet Ø6 i versjon 3, slik at lagrene kan sitte rett på akselen. Med den tykkere akselen og uendret akseavstand ble klaringen til svinghjulet bare $34 - 30 - 3 = \SI{1}{mm}$, og versjonen ble forkastet.

For å få \SI{3}{mm} klaring med Ø6-aksler må akseavstanden være $30 + 3 + 3 = \SI{36}{mm}$. Versjon 4 har derfor 73 tenner på tannhjulet med samme pinjong, siden $0{,}8 \cdot (17 + 73)/2 = \SI{36}{mm}$, og utvekslingen blir $i = 73/17 \approx 4{,}29$. Forholdet $r_h/i$, som bestemmer hvor fort bilen kjører ved et gitt turtall, blir \SI{7,9}{mm}, nesten som \SI{8,0}{mm} i utgangspunktet, og den simulerte distansen ble \SI{9,4}{m}, litt lengre enn i versjon 1 og 2. Akslene ligger 34, 70 og \SI{106}{mm} fra bakkant, og med Ø68-hjul blir bilen nøyaktig \SI{140}{mm} lang. Resten av bilen er bygd rundt denne versjonen.

\begin{table}[H]
    \centering
    \caption[Versjonene av drivverket]{Versjonene av drivverket. Vurderingen gjelder klaringen mellom svinghjul og aksel, som var hovedkravet.}
    \label{tab:dv-samlet}
    \small
    \renewcommand{\arraystretch}{1.2}
    \begin{tabular}{|l|c|c|c|c|}
        \hline
        & \textbf{Versjon 1} & \textbf{Versjon 2} & \textbf{Versjon 3} & \textbf{Versjon 4} \\
        \hline
        Endring & Konsept 3 & Aksler i lik høyde & Ø6-aksler & $a = \SI{36}{mm}$ \\
        Utveksling & 17\,:\,68 & 17\,:\,68 & 17\,:\,68 & 17\,:\,73 \\
        Hjuldiameter [mm] & 64 & 68 & 68 & 68 \\
        Hjulaksler & Ø3 sveisetråd & Ø3 sveisetråd & Ø6 printet & Ø6 printet \\
        Klaring svinghjul--aksel [mm] & 2,5 & 2,5 & 1 & 3 \\
        Bakkeklaring svinghjul [mm] & 6 & 4 & 4 & 4 \\
        Lengde [mm] & 132 & 136 & 136 & 140 \\
        Simulert distanse [m] & 9,3 & 9,2 & -- & 9,4 \\
        \hline
        Vurdering & Delvis vellykket & Delvis vellykket & Mislykket & Vellykket \\
        \hline
    \end{tabular}
\end{table}

\subsection{Generativ design av rammen}
\label{sec:gd-ramme}
Rammen bærer de seks lagrene, må holde de tre akslene parallelle og skal tåle at bilen holdes i hånda mens snora trekkes. I stedet for sideplatene fra konseptene, eller en laserkuttet MDF-kropp der hver vegg måtte limes av to lag, er rammen laget med generativ design i Fusion og 3D-printet i PLA i ett stykke. Ved generativ design angir man geometri som må være med, områder uten materiale, laster og mål, og programmet genererer former som oppfyller dette \parencite{autodesk_gd}.

\subsubsection{Oppsett av studien}
Oppsettet er styrt av målene fra drivverket og oppdateres dersom drivverket endres (figur~\ref{fig:fusion-oppsett}). Geometri som skal bevares, er fire lukkede lagerhus for bak- og forakselen, to U-seter for svinghjulslagrene og en tverrbjelke foran og bak. Som hindringer er det lagt inn frirom for alle roterende deler, snorbanen og tilkomst for montering og skrutrekker, innenfor yttergrensen på $140 \times 85 \times 70$ mm (R1). Svinghjulet er sveiset fast på akselen og kan ikke tres inn i lukkede lagerhus. Det senkes derfor ned ovenfra, og to lagerlokk skrus over U-setene.

\begin{figure}[H]
    \centering
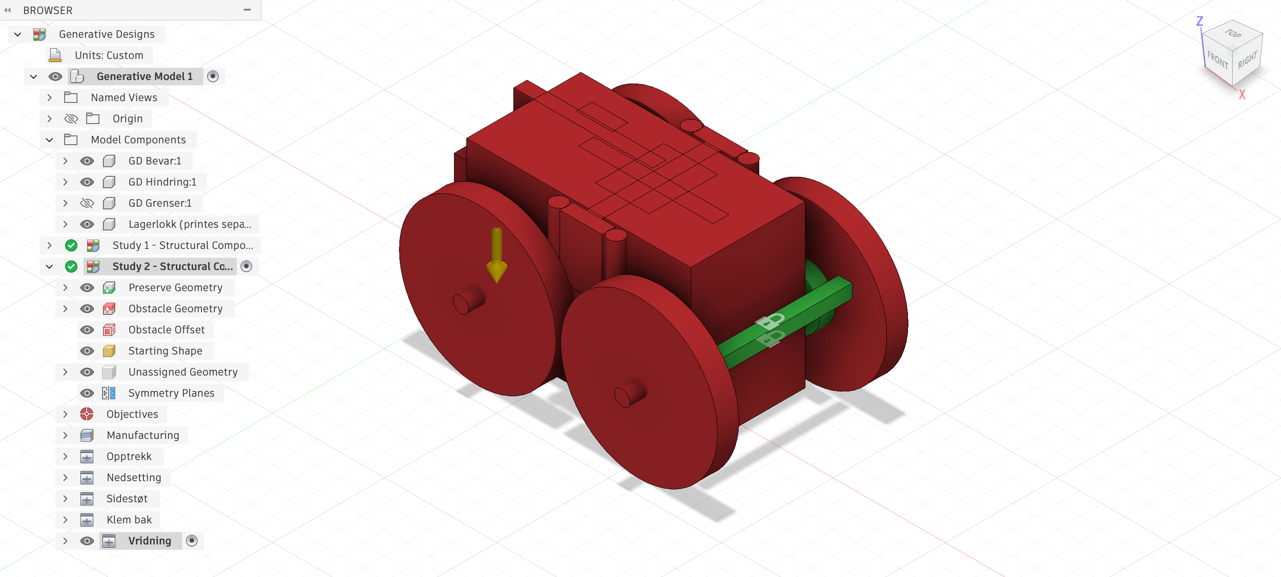
[picture p15: Rapport/Images/Ramme/fusion_oppsett.png]
    
    \caption[Oppsettet for generativ design i Fusion]{Oppsettet i Fusion, med hindringer i rødt og bevart geometri i grønt. Til venstre står de fem lasttilfellene i den andre studien. Den gule pila er en av lastene i lasttilfellet for vridning.}
    \label{fig:fusion-oppsett}
\end{figure}

Lasttilfellene står i tabell~\ref{tab:gd-lasttilfeller}. Snorkraften er satt til \SI{50}{N}, nesten dobbelt så mye som snittkraften på \SI{26}{N} i et opptrekk til \SI{4000}{o/min} (seksjon~\ref{sec:tr-serien}). De andre kreftene er anslått. Målet er størst mulig stivhet med massemål \SI{40}{g} og sikkerhetsfaktor 2. Studien regner med ABS, fordi Fusion ikke har PLA for generativ design, og kjøres for additiv produksjon med rammen liggende på siden, største overheng 45° og minste godstykkelse \SI{2}{mm}.

\begin{table}[H]
    \centering
    \caption[Lasttilfellene i studien]{Lasttilfellene i studien. Den første studien har bare tilfelle 1--3.}
    \label{tab:gd-lasttilfeller}
    \small
    \renewcommand{\arraystretch}{1.2}
    \begin{tabular}{|l|p{4.6cm}|p{5.4cm}|}
        \hline
        \textbf{Lasttilfelle} & \textbf{Innspenning} & \textbf{Last} \\
        \hline
        1. Opptrekk & Fremre tverrbjelke fast & \SI{25}{N} bakover i hvert U-sete \\
        2. Nedsetting & Lagerhusene låst, fremre fri sideveis & \SI{10}{N} nedover i hvert U-sete \\
        3. Sidestøt & Som tilfelle 2 & \SI{10}{N} sideveis på fremre tverrbjelke \\
        4. Klem bak & Fremre tverrbjelke fast & \SI{20}{N} innover på hvert bakre lagerhus \\
        5. Vridning & Fremre tverrbjelke fast & \SI{10}{N} opp og \SI{10}{N} ned på de bakre lagerhusene \\
        \hline
    \end{tabular}
\end{table}

\subsubsection{To studier}
Den første studien hadde bare lasttilfelle 1--3 og ga en åpen U-form der den bakre tverrbjelken bare hang i et tynt stag (figur~\ref{fig:gd-utfall}a). Årsaken var at begge de bakre lagerhusene var låst i tilfelle 2 og 3, noe som virker som en uendelig stiv bjelke mellom dem. En åpen U-ramme gir etter når bilen holdes under opptrekk, og lagrene bak kan vris i forhold til hverandre. I den andre studien ble derfor også tilfelle 4 og 5 lagt til, med bare den fremre tverrbjelken låst, slik at rammen selv må ta opp klem og vridning bak. Det ga en lukket ramme (figur~\ref{fig:gd-utfall}b og tabell~\ref{tab:gd}).

\begin{figure}[H]
    \centering
    \begin{subfigure}[b]{0.42\textwidth}
        \centering
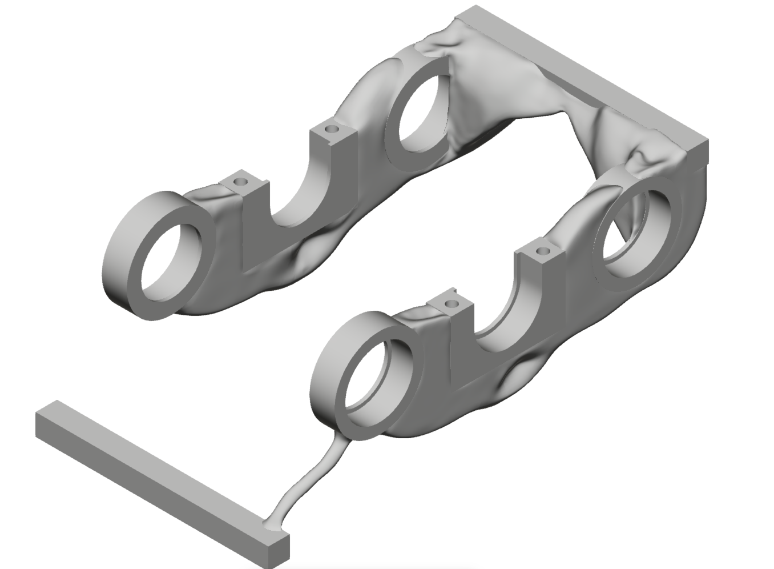
[picture p16: Rapport/Images/Ramme/fusion_gd1.png]
        
        \caption{Første studie: åpen U}
    \end{subfigure}
    \hfill
    \begin{subfigure}[b]{0.48\textwidth}
        \centering
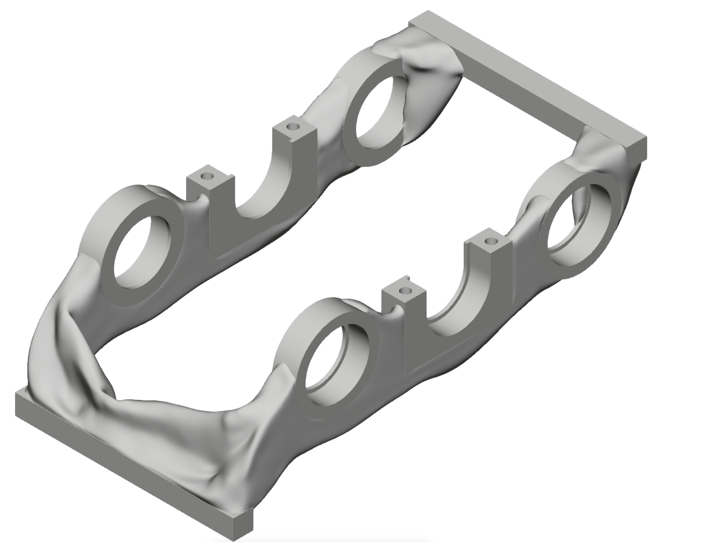
[picture p17: Rapport/Images/Ramme/fusion_gd2_utfall2.png]
        
        \caption{Andre studie: lukket ramme (valgt)}
    \end{subfigure}
    \caption[Resultater fra de to studiene]{Resultater fra de to studiene. Med lasttilfelle 4 og 5 er den bakre tverrbjelken bygd inn i sidene.}
    \label{fig:gd-utfall}
\end{figure}

\begin{table}[H]
    \centering
    \caption[Evaluering av de to studiene]{Evaluering av de to studiene. Masse, spenning og forskyvning er regnet i massiv ABS av Fusion.}
    \label{tab:gd}
    \small
    \renewcommand{\arraystretch}{1.2}
    \begin{tabular}{|l|c|c|}
        \hline
        \textbf{Test} & \textbf{Første studie} & \textbf{Andre studie} \\
        \hline
        Hovedtest: lukket ramme rundt drivverket & Mislykket, åpen U & Vellykket \\
        \hline
        Rammen bærer lastene bak selv & Mislykket & Vellykket \\
        Masse i ABS, massemål \SI{40}{g} & \SI{38,5}{g} & \SI{38,3}{g} \\
        Minste sikkerhetsfaktor, krav 2 & 19,5 & 9,3 \\
        Største forskyvning & \SI{0,44}{mm} & \SI{0,45}{mm} \\
        Innenfor $140 \times 85 \times 70$ mm (R1) & -- & $123{,}7 \times 65{,}5 \times 43{,}2$ mm \\
        Ingen kollisjon med drivverket & -- & Vellykket \\
        Svinghjulet kan tas ut uten å skille rammen (R7) & -- & Vellykket \\
        \hline
    \end{tabular}
\end{table}

Sikkerhetsfaktoren i den andre studien ligger langt over kravet. Formen styres derfor av stivheten og minste godstykkelse, ikke av styrken. Forskyvningene kan ikke sammenlignes direkte, fordi studiene har ulike lasttilfeller.

\subsubsection{Fra resultat til printet ramme}
Lagerboringene er utvidet fra Ø19,0 til Ø19,1 etter prøveringene (seksjon~\ref{sec:ls-serien}), og rammen er kontrollert mot drivverket med en kollisjonstest i Fusion. Den er printet liggende på siden med \SI{20}{\percent} fyll og veier \SI{23}{g}. Den trengte likevel support, trolig fordi overhengsbegrensningen bare gjelder materialet studien legger til, ikke den bevarte geometrien. Lagerlokkene festes med M3-skruer rett i PLA, fordi gjengeinnsatser ikke fikk plass. Figur~\ref{fig:ferdig-bil} viser rammen montert.

\begin{comment}

\subsubsection{Vurdering}
Kreftene er anslått, og studien regner med massiv ABS, mens rammen er printet i PLA med \SI{20}{\percent} fyll og er svakere mellom lagene. Sikkerhetsfaktoren gir god margin for styrken, men stivheten til den printede rammen er ikke målt. Erfaringen fra den første studien er at innspenningene betyr like mye som lastene: en innspenning som er stivere enn virkeligheten, fjerner materiale der det trengs. I en senere versjon bør også den bevarte geometrien formes for printing, så support unngås.
\end{comment}
