olivertiller/KERS-bil/Rapport/Sections/Preface.tex

\section*{Forord}
\addcontentsline{toc}{section}{Forord}
Denne rapporten er semesteroppgaven i MAST1101 Maskinteknikk 1 ved NTNU høsten 2026. Oppgaven var å utvikle en lekebil som drives av et svinghjul, og som skal kjøre lengst mulig etter ett opptrekk med snor. Jeg tok emnet dette semesteret, og har gjort arbeidet alene. Den samme bilen skal danne basis for videreutvikling i MAST2007, og den dynamiske analysen av bilen hører hjemme der.

Jeg vil takke fagansvarlig Anna Olsen, som lot meg ta emnet dette semesteret, og som har sparret med meg på e-post og i møte underveis. Jeg vil også takke Kristian Sandmo for den praktiske innsatsen. Han skar ut svinghjulsskiva, sveiste den på akselen og skaffet lagrene.

\vspace{1cm}
\noindent Oliver Kvaløy Tiller\\
November 2026
