olivertiller/KERS-bil/Rapport/Images/Kjoretest/maalegeometri.pdf

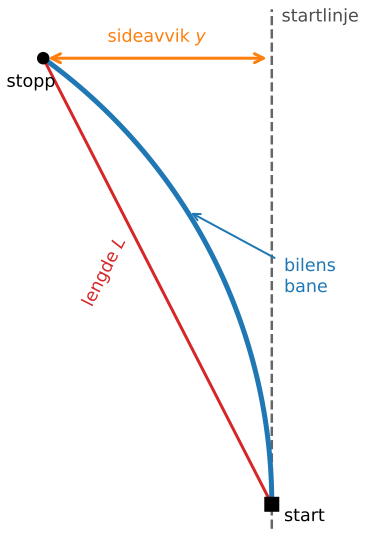
[picture p18: figure]
startlinje; bilens bane; lengde; sideavvik y; start; stopp
