olivertiller/KERS-bil/Rapport/Images/Maling/sim_maalte_tap.pdf

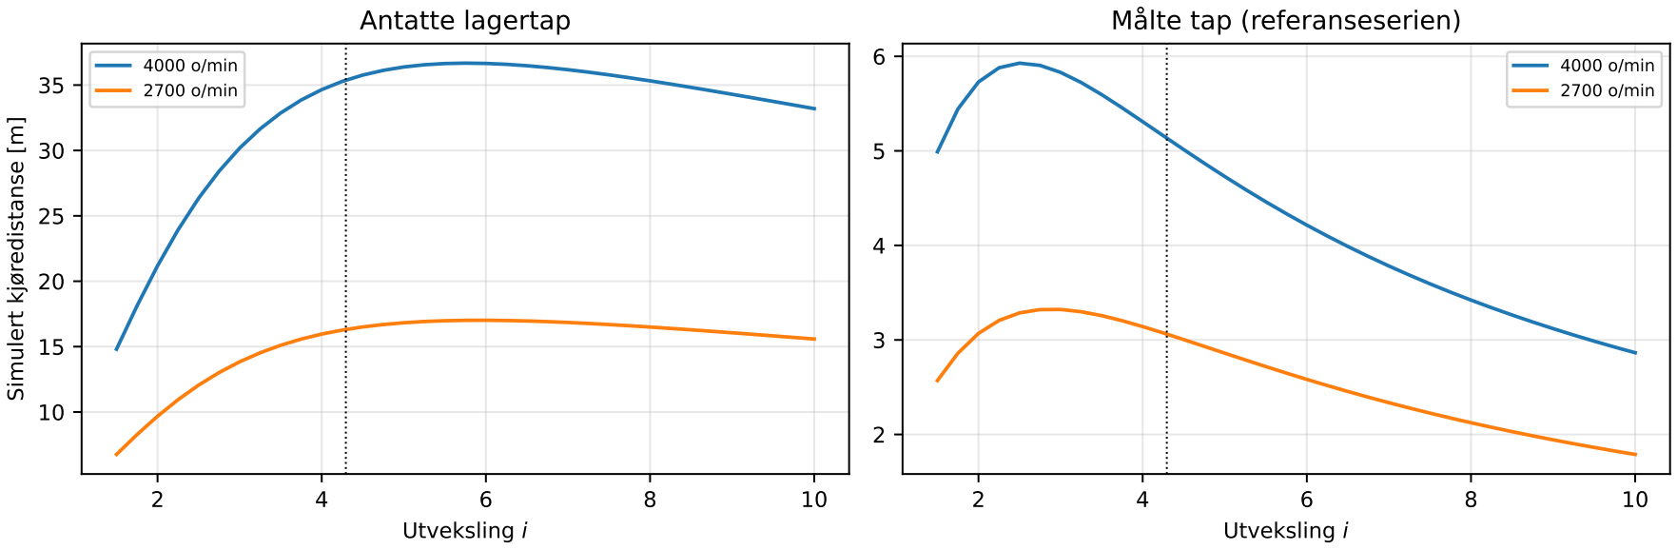
[picture p19: figure]
slin g; Simulert kjøredistanse [m]; Antatte lagertap; 4000 o/min; 2700 o/min; Målte tap (referanseserien); 4000 o/min 2700 o/min
