olivertiller/KERS-bil/Rapport/Gantt-diagram.xlsx

 | Uke 39 | Uke 40 | Uke 41 | Uke 42 | Uke 43 | Uke 44 | Uke 45 | Uke 46 | 16. November - Innlevering
Utrede og forstå teori bak KERS
Planlegge prosjektstyring og risikovurdering for gjennomføring av prosjektet
Konseptutvikling og innledende design
Testing
Iterering på konsept
Løpende rapportskriving
Sluttføring av rapport med konklusjoner fra testing
