olivertiller/KERS-bil/Sections/Future_work.tex

\subsection{Videre arbeid våren 2027}

\begin{comment}
\subsubsection{Foreløpig problemstilling}
\begin{quote}
Hvordan kan kjøredistansen til en svinghjulsdrevet lekebil forbedres gjennom dynamisk modellering, eksperimentell validering og iterative designendringer?
\end{quote}
\subsubsection{Beregningsgrunnlag og modellvalidering}
Vårarbeidet skal bygge på høstens prototype og testdata. Det planlegges dynamiske og kinematiske beregninger, modellering av energioverføring og tap og sammenligning mellom beregnet og målt oppførsel. Omfang og modellforutsetninger avklares ved oppstart av vårsemesteret.
\subsubsection{Iterasjon av prototypen}
Modell og forsøk brukes til å prioritere forbedringer av drivverk, hjul, lager og øvrig konstruksjon. Endringer testes mot høstens referanse med en sammenlignbar prosedyre.
\subsubsection{Grunnlag som overføres fra høsten}
CAD-filer, tegninger, deleliste, prototypeversjoner, rådata, testprosedyre og dokumenterte svakheter samles slik at videre arbeid kan etterprøve og bygge på høstens resultater.
\end{comment}
