olivertiller/KERS-bil/Sections/AI_use.tex

\section{Bruk av kunstig intelligens}
\label{sec:ki}
% Beskriv hvilke KI-verktøy som er brukt, til hva, og hvordan resultatene er kontrollert.
% Claude (Anthropic) er så langt brukt til: simuleringsskriptet Code/kers_sim.py, Arduino-koden
% for utsnurringstesten, konseptskissene (Code/konseptskisser.py), utkast til konseptbeskrivelsene
% og omstrukturering av rapportens disposisjon.
