olivertiller/KERS-bil/Bygg/Laserkutt/forhandsvisning_kropp_v1.png

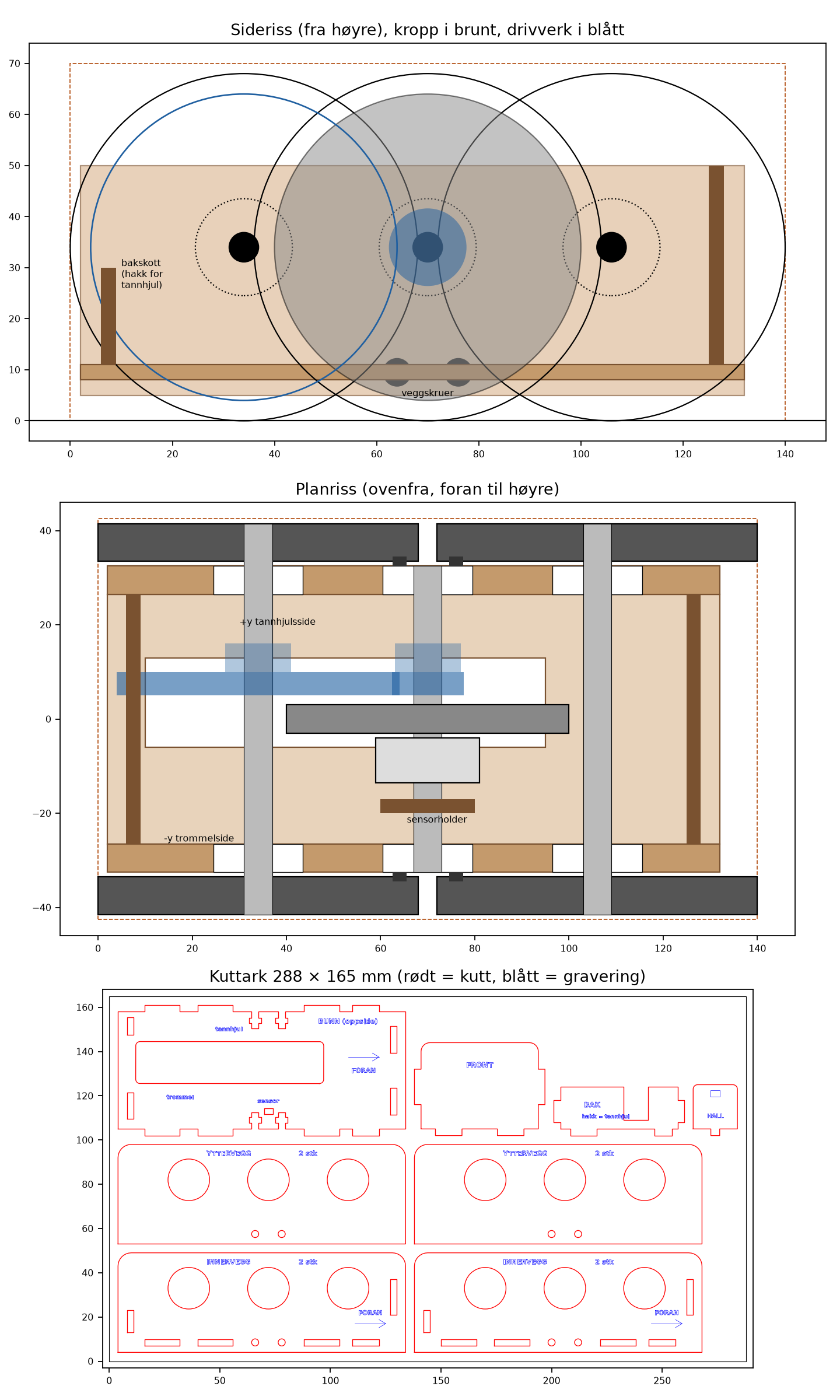
Bygg/Laserkutt/forhandsvisning_kropp_v1.png
