olivertiller/KERS-bil/Images/Foto/felg_innside.jpg

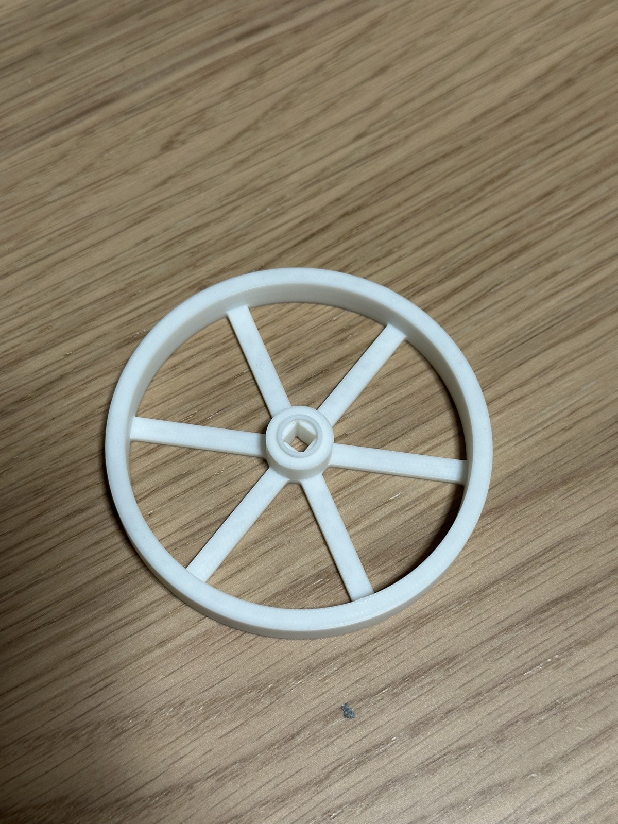
Images/Foto/felg_innside.jpg
