olivertiller/KERS-bil/Images/Foto/felg_utside.jpg

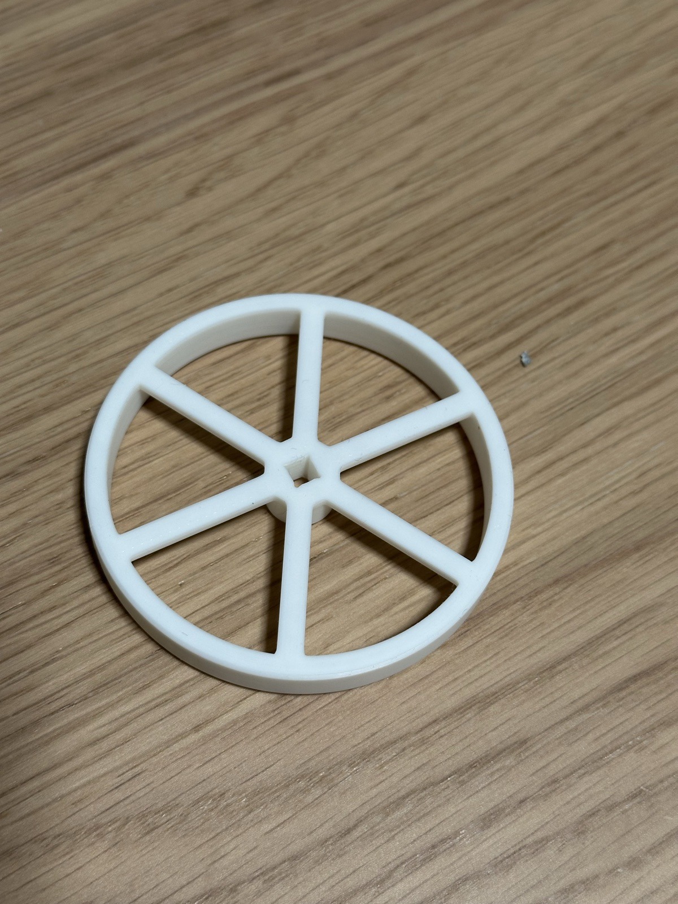
Images/Foto/felg_utside.jpg
