olivertiller/KERS-bil/Images/Foto/firkanttest.jpg

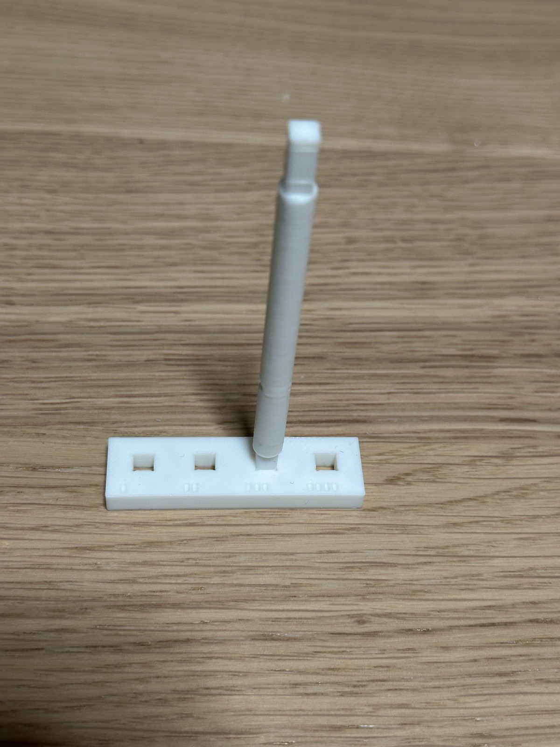
Images/Foto/firkanttest.jpg
