olivertiller/KERS-bil/Images/Foto/lager_proevering.jpg

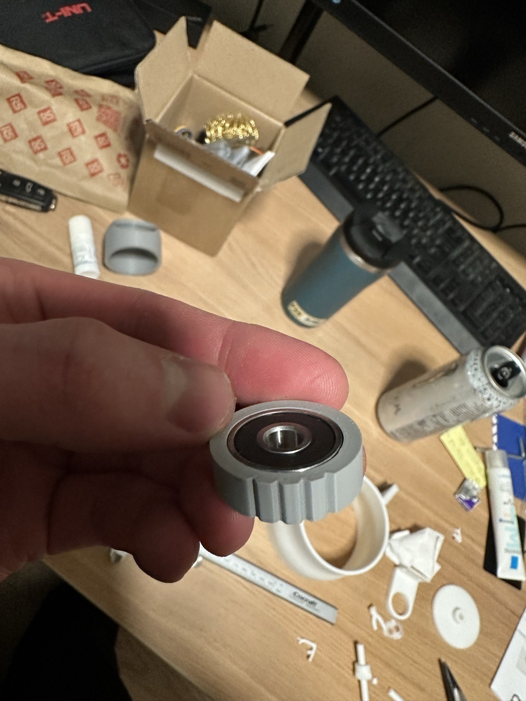
Images/Foto/lager_proevering.jpg
