olivertiller/KERS-bil/Images/Foto/magnetskive.jpg

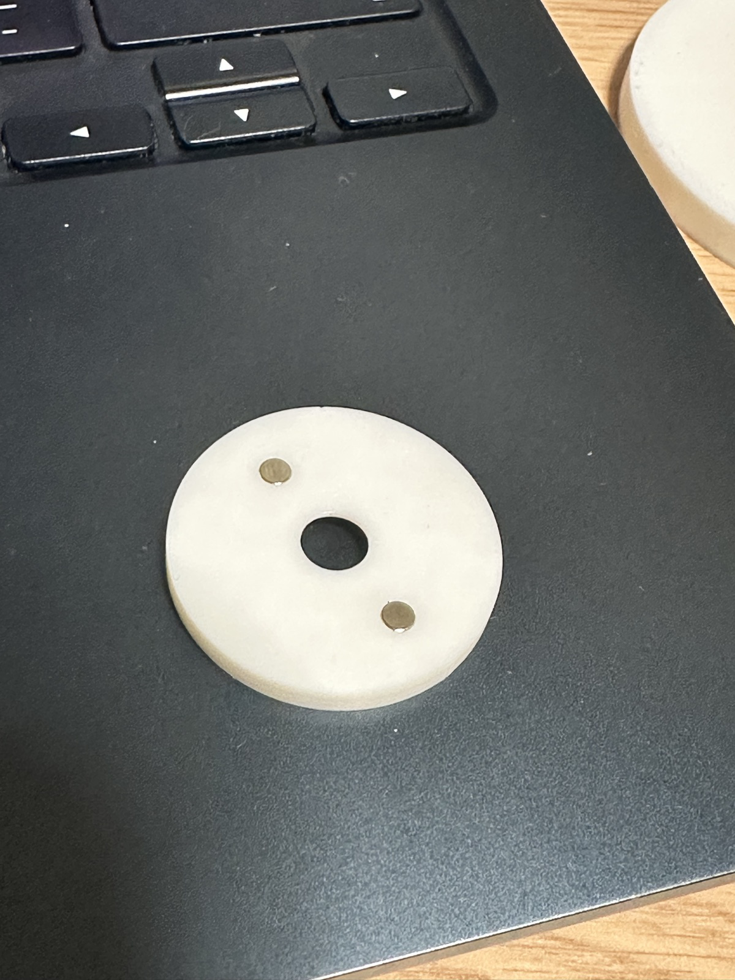
Images/Foto/magnetskive.jpg
