olivertiller/KERS-bil/Images/Foto/ml_oppsett.jpg

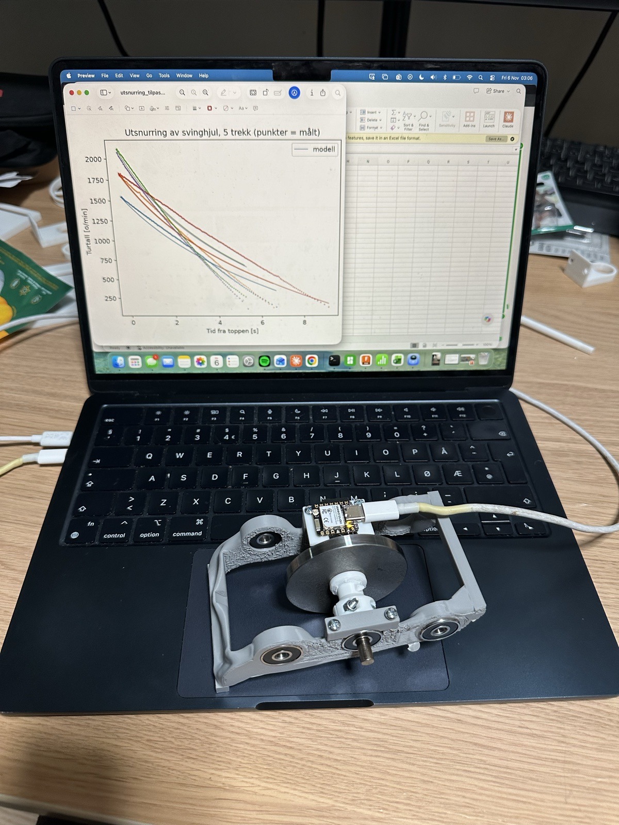
Images/Foto/ml_oppsett.jpg
