olivertiller/KERS-bil/Images/Foto/ml_sensor.jpg

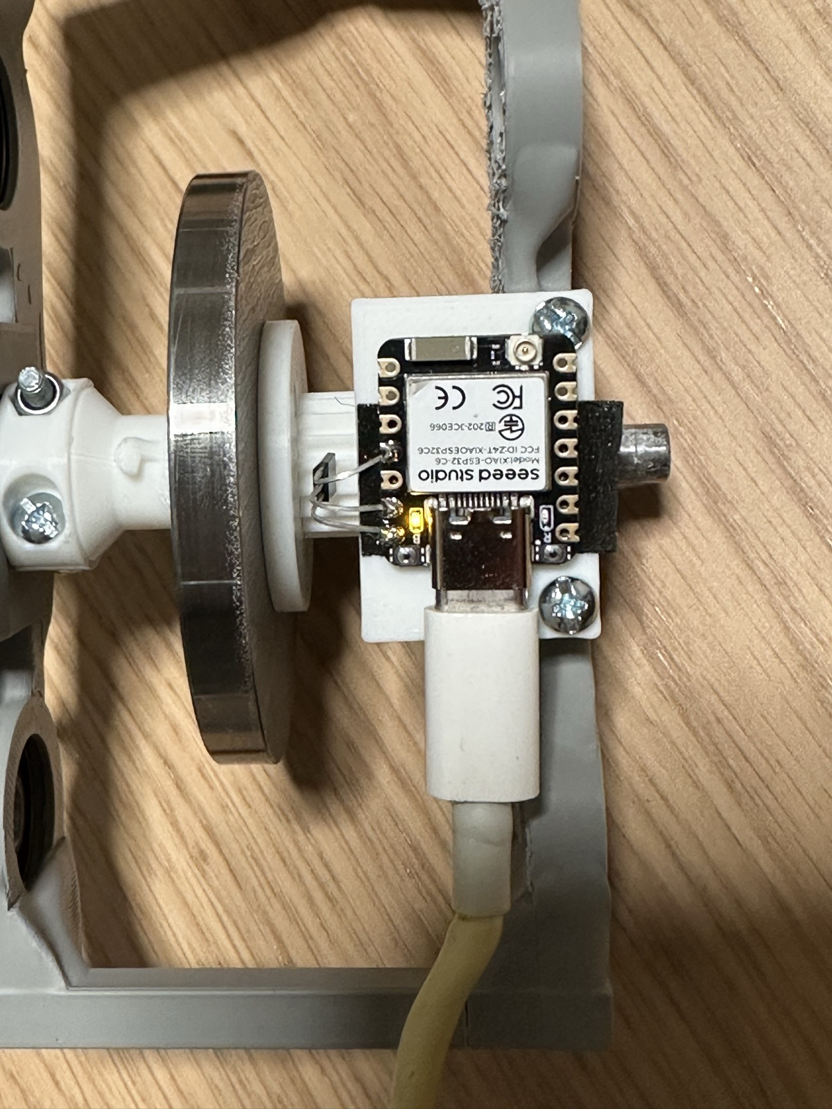
Images/Foto/ml_sensor.jpg
