olivertiller/KERS-bil/Images/Foto/trommel_klemnav.jpg

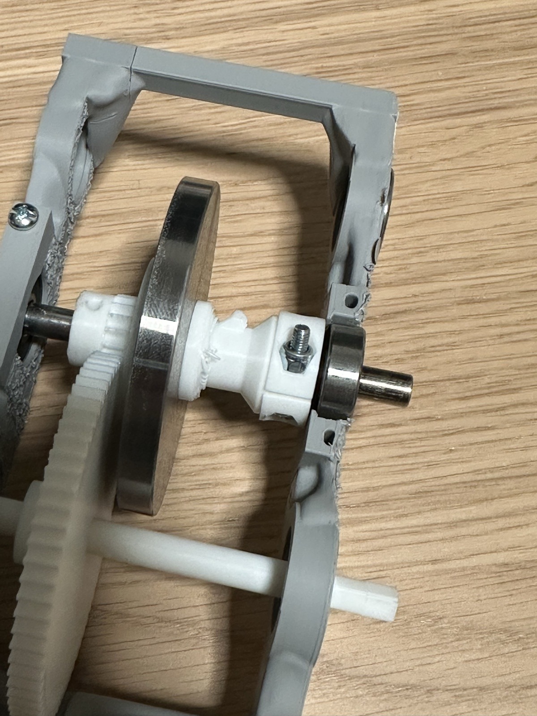
Images/Foto/trommel_klemnav.jpg
