olivertiller/KERS-bil/Images/Prototyper/drillhjul.png

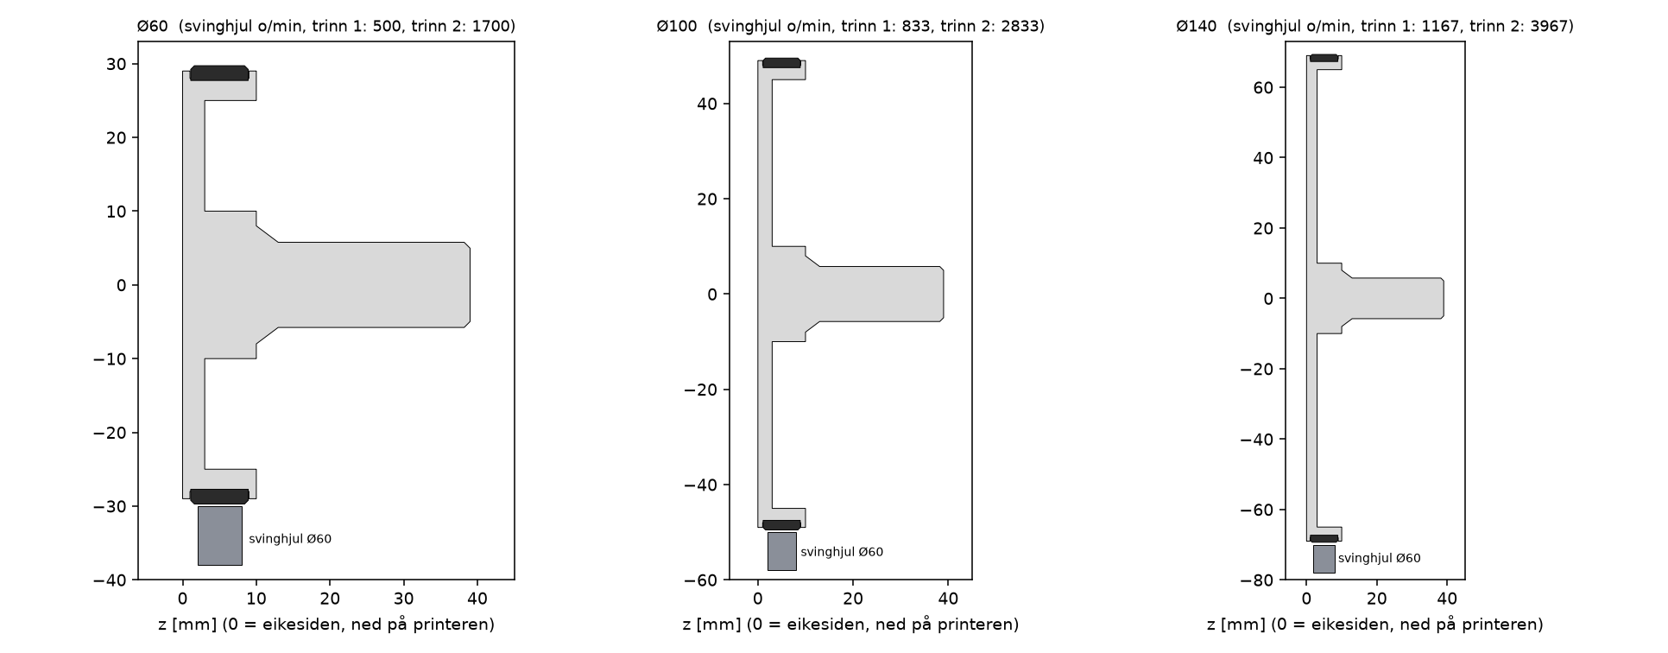
Images/Prototyper/drillhjul.png
