olivertiller/KERS-bil/Images/Prototyper/hjul.png

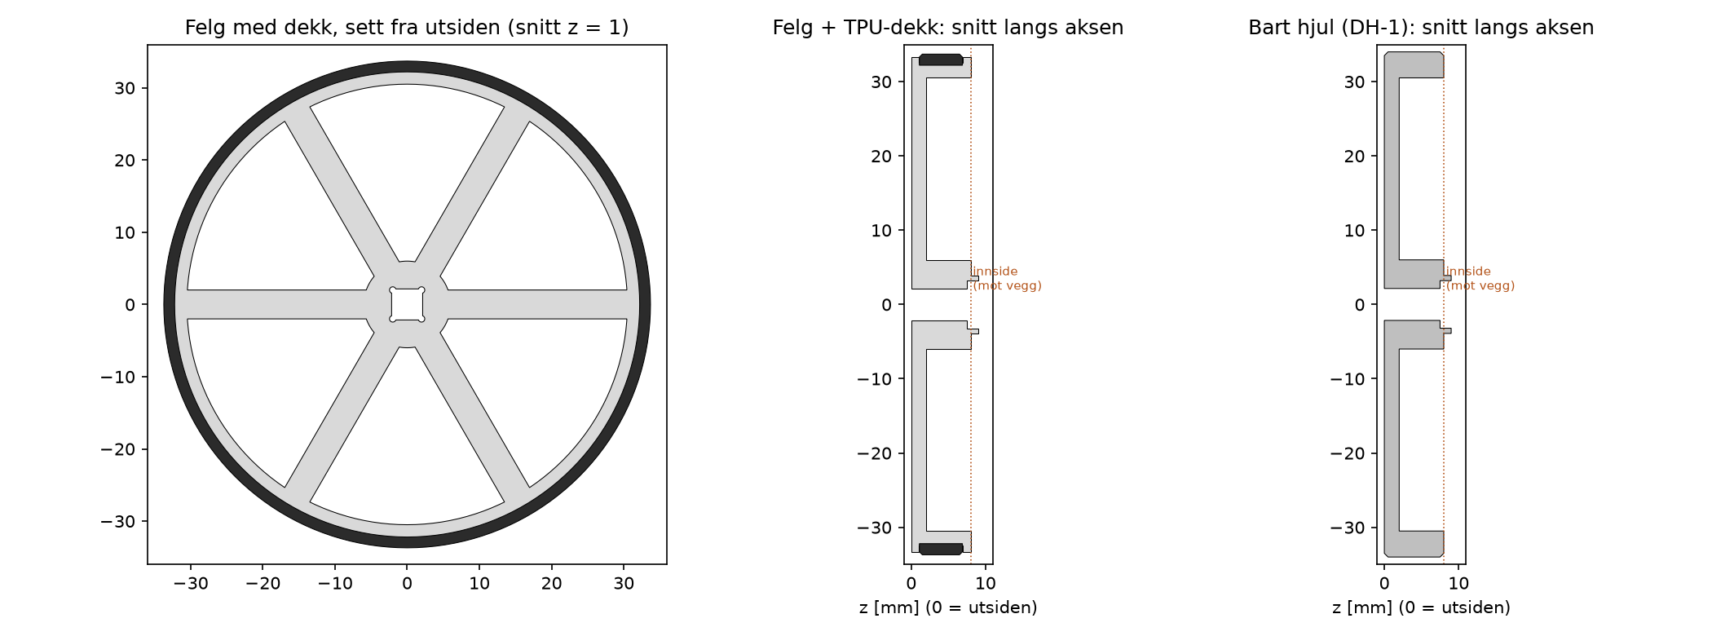
Images/Prototyper/hjul.png
