olivertiller/KERS-bil/Images/Prototyper/snortrommel.png

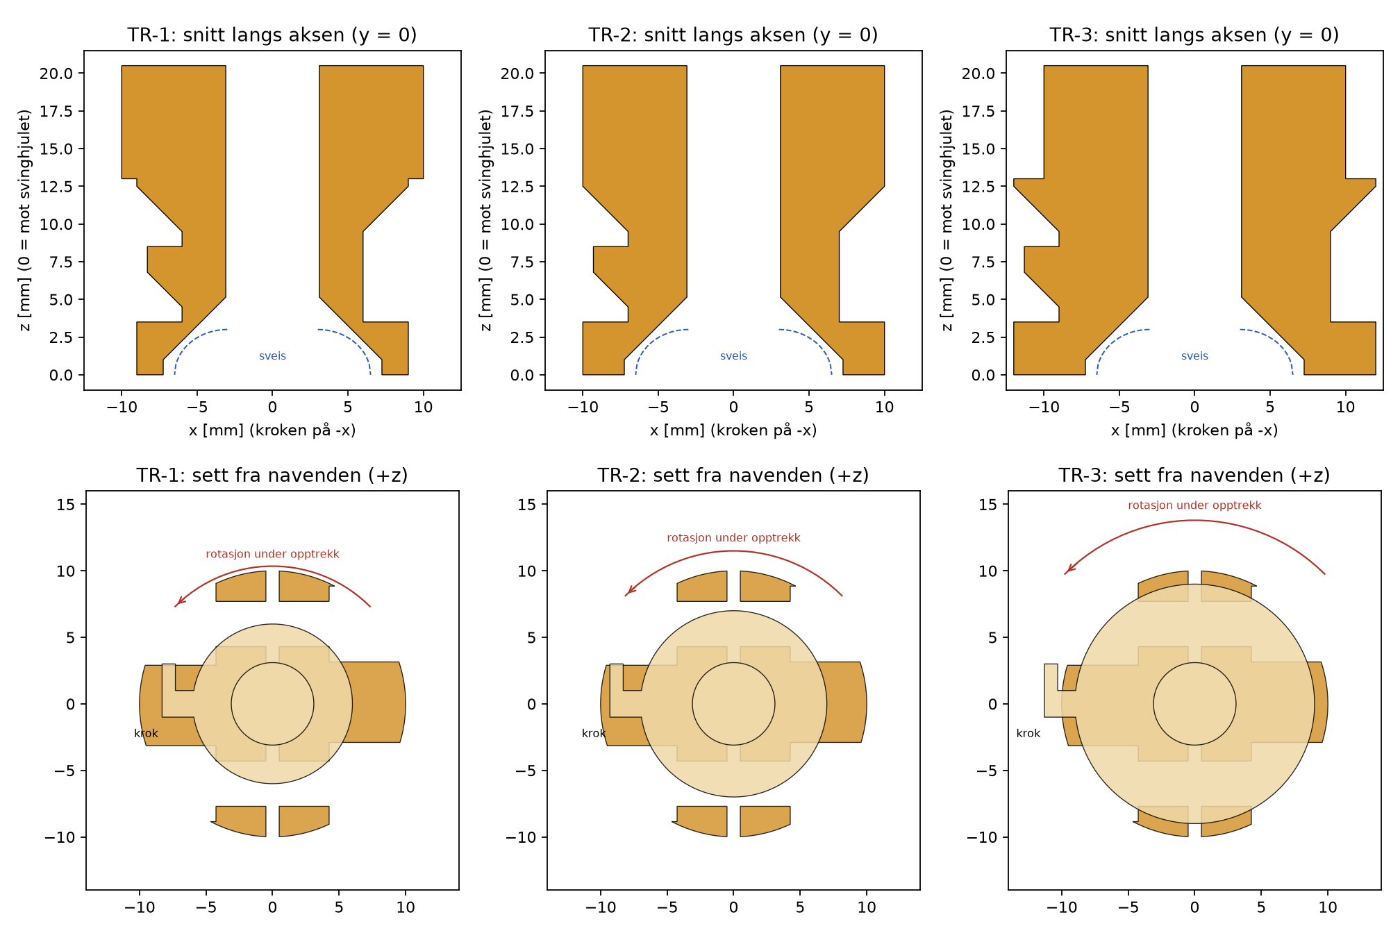
Images/Prototyper/snortrommel.png
