olivertiller/KERS-bil/Images/Ramme/gd_oppsett.png

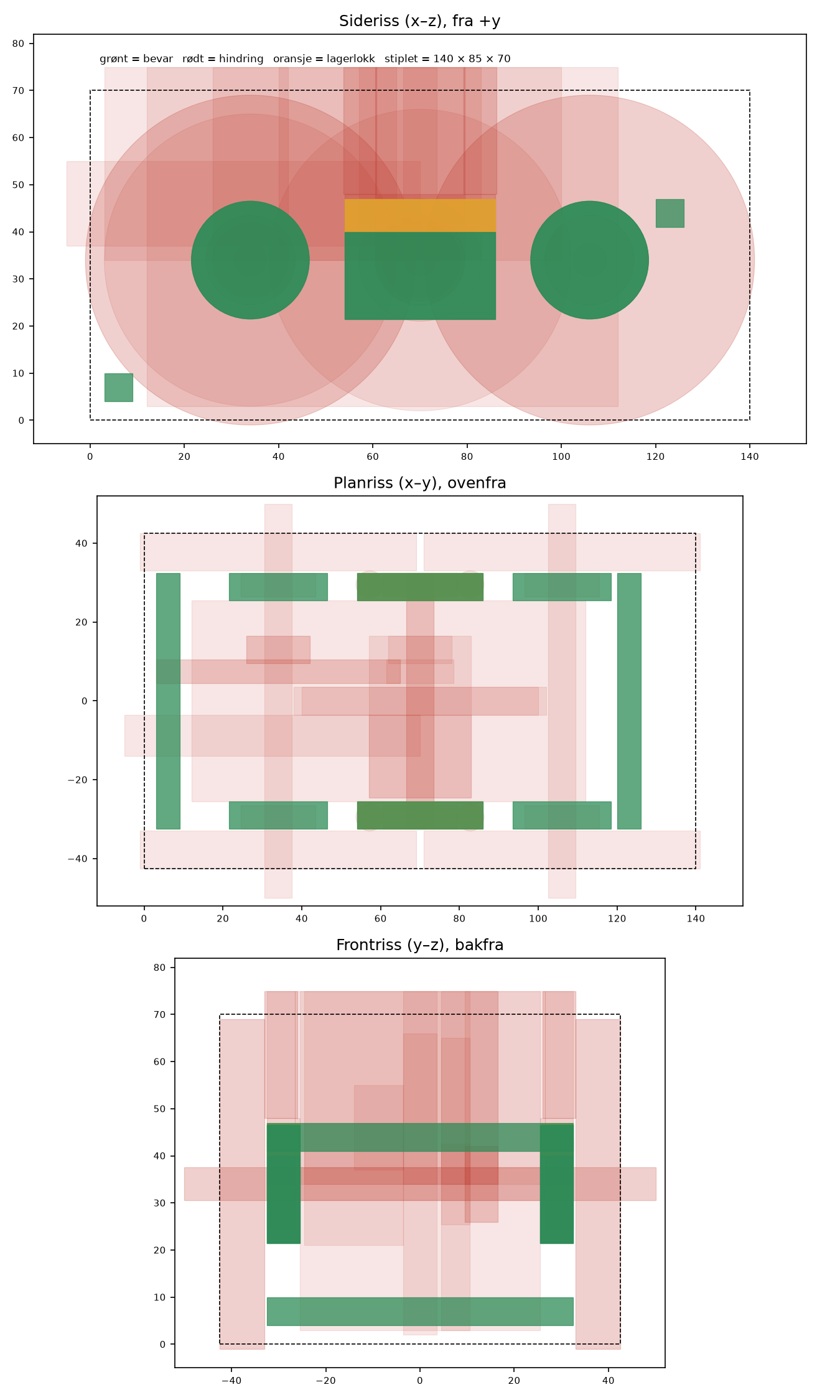
Images/Ramme/gd_oppsett.png
