olivertiller/KERS-bil/Images/Ramme/ramme_side.png

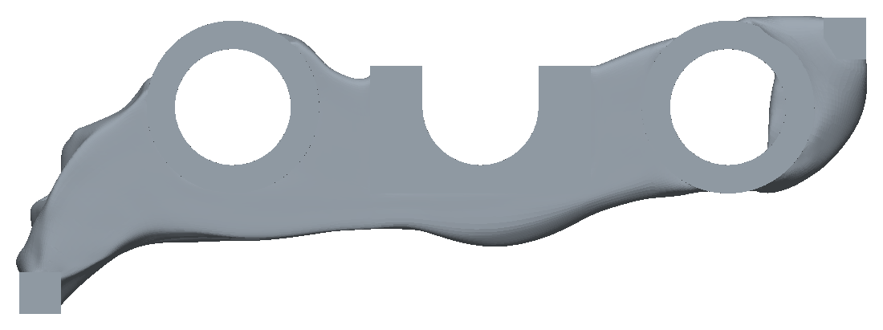
Images/Ramme/ramme_side.png
