olivertiller/KERS-bil/Images/Ramme/ramme_skraatt.png

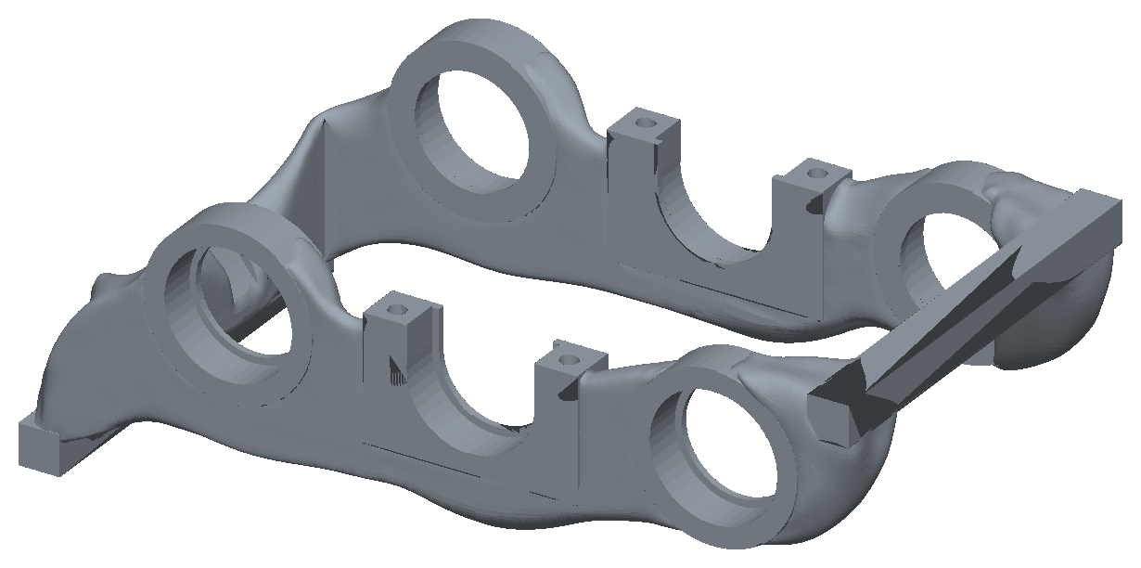
Images/Ramme/ramme_skraatt.png
