olivertiller/KERS-bil/Rapport/Images/Drivverk/drivverk_v1_side.png

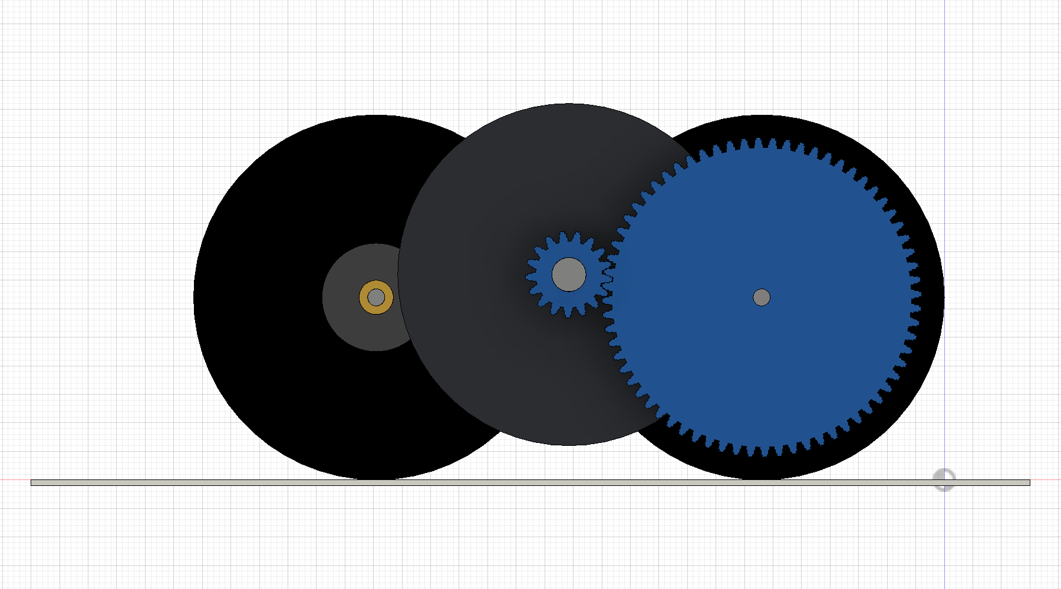
Rapport/Images/Drivverk/drivverk_v1_side.png
