olivertiller/KERS-bil/Rapport/Images/Drivverk/drivverk_v1_skraatt.png

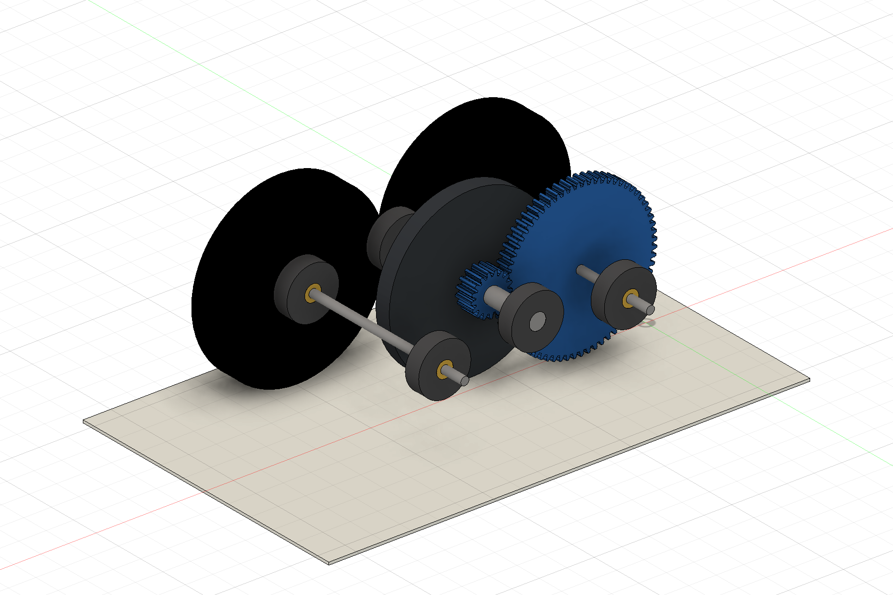
Rapport/Images/Drivverk/drivverk_v1_skraatt.png
