olivertiller/KERS-bil/Rapport/Images/Drivverk/drivverk_v2_side.png

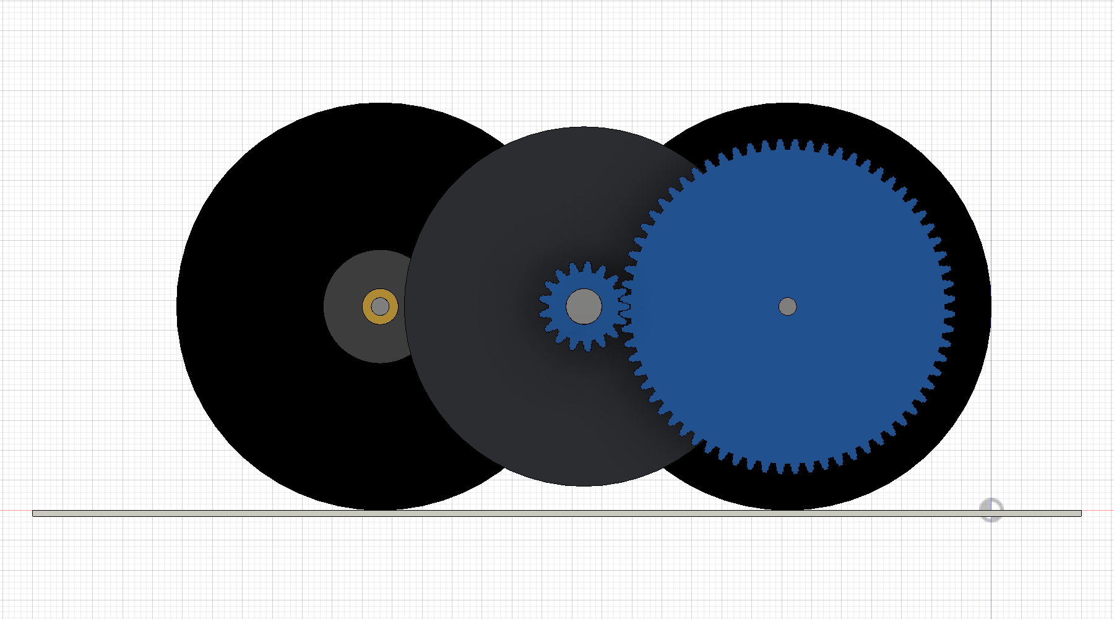
Rapport/Images/Drivverk/drivverk_v2_side.png
