olivertiller/KERS-bil/Rapport/Images/Prototyper/avstandshylse.png

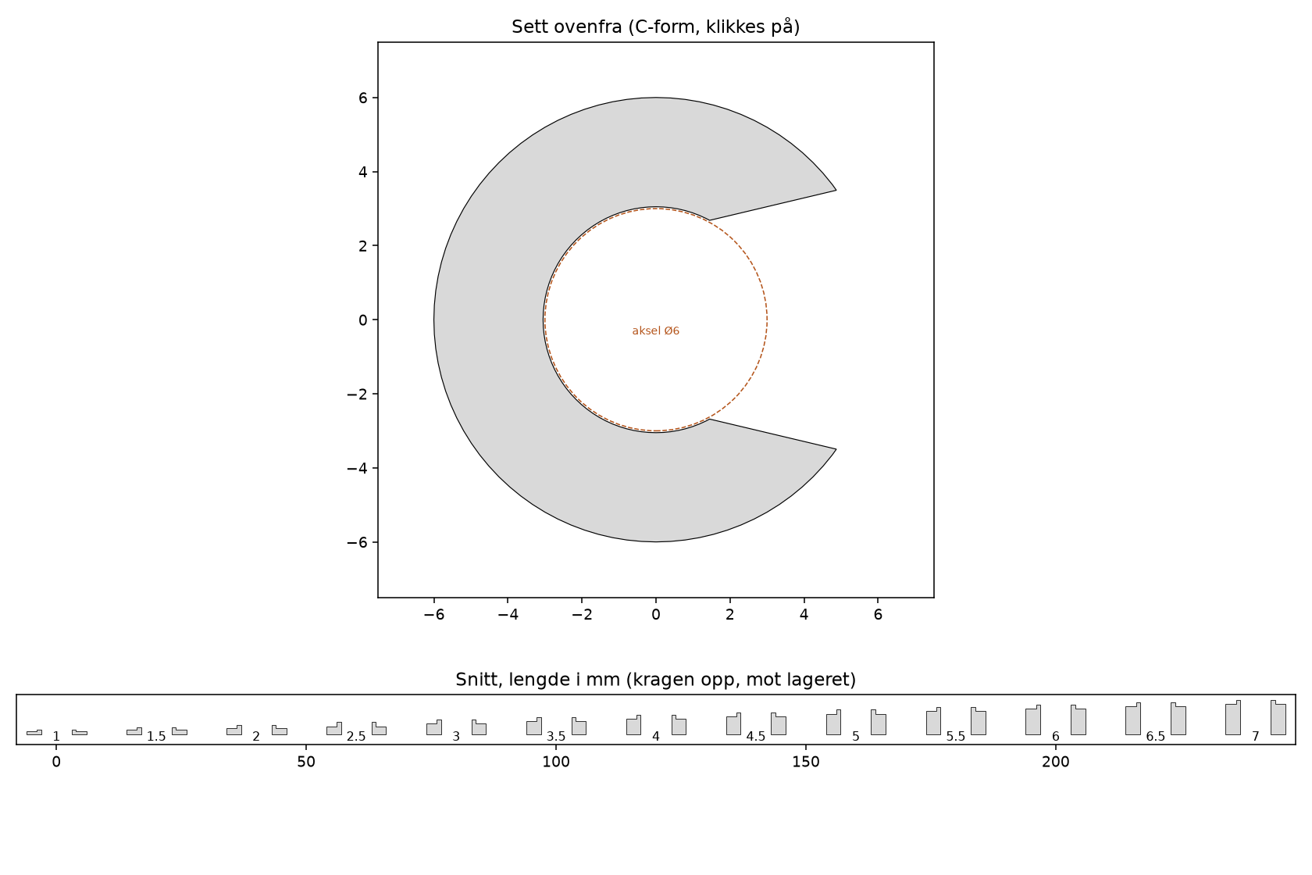
Rapport/Images/Prototyper/avstandshylse.png
