olivertiller/KERS-bil/Bygg/Generativ_ramme/lagerring_D19.10.stl

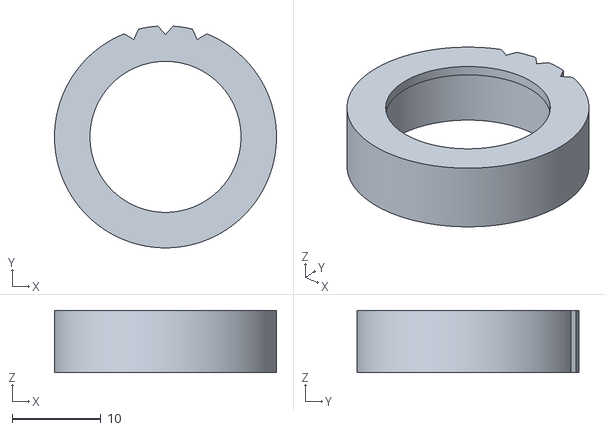
[picture p39: CAD file, 2026-11-06]
Bygg/Generativ_ramme/lagerring_D19.10.stl
25.0 x 25.0 x 7.00
