olivertiller/KERS-bil/Bygg/Laserkutt/kropp_v1.dxf

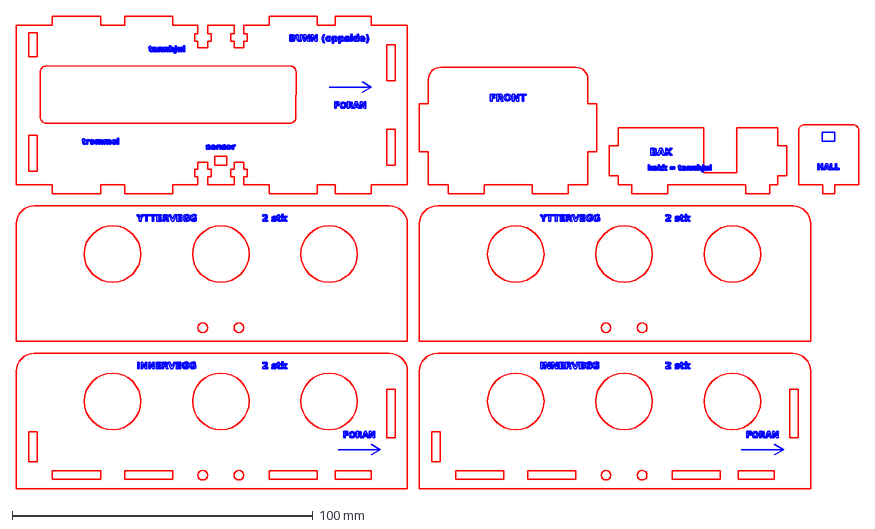
[picture p40: CAD file, 2026-11-06]
Bygg/Laserkutt/kropp_v1.dxf
280.0 x 157.0 mm
