olivertiller/KERS-bil/Bygg/Laserkutt/lagerplate.dxf

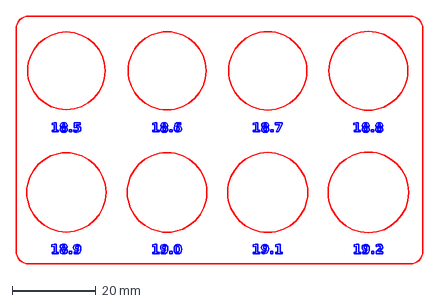
[picture p41: CAD file, 2026-11-06]
Bygg/Laserkutt/lagerplate.dxf
97.0 x 59.0 mm
