olivertiller/KERS-bil/Bygg/Generativ_ramme/lagertestringer.3mf

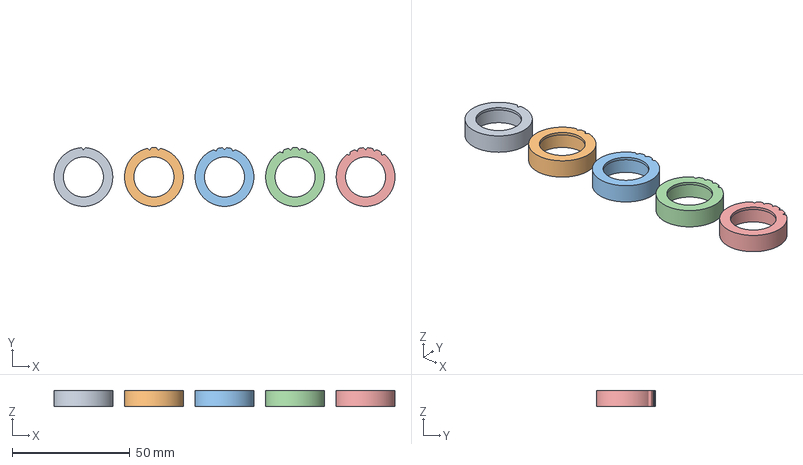
[picture p42: CAD file, 2026-11-06]
Bygg/Generativ_ramme/lagertestringer.3mf
145.0 x 25.0 x 7.00 mm
Lagerring D18.90 (1 hakk)
Lagerring D19.00 (2 hakk)
Lagerring D19.10 (3 hakk)
Lagerring D19.20 (4 hakk)
Lagerring D19.30 (5 hakk)
