olivertiller/KERS-bil/Bygg/Laserkutt/test_v1.dxf

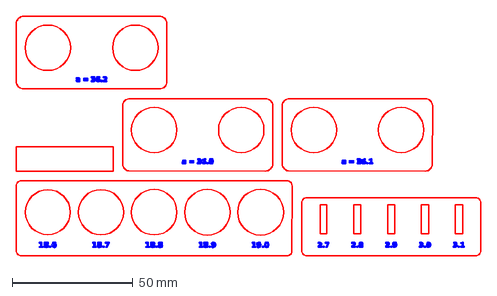
[picture p43: CAD file, 2026-11-06]
Bygg/Laserkutt/test_v1.dxf
192.0 x 99.0 mm
