olivertiller/KERS-bil/(list of files, cad)

Other CAD files:
Kers-bil/Generativ_ramme/lagerring_D18.90.stl
Bygg/Generativ_ramme/lagerring_D19.20.stl
Kers-bil/Generativ_ramme/lagerring_D19.00.stl
Kers-bil/Generativ_ramme/lagerring_D19.30.stl
Bygg/Drivverk_versjoner/drivverk_v1.f3d
Bygg/Drivverk_versjoner/drivverk_v2.f3d
Bygg/Drivverk_versjoner/drivverk_v3.f3d
Bygg/Drivverk_versjoner/drivverk_v4.f3d
