olivertiller/KERS-bil/Rapport/Sections/Results.tex

\section{Resultater og analyser}
\label{sec:resultater}
Først kommer målingene med turtallsmåleren, av opptrekket og av tapene i lagre og drivverk. Deretter følger de to kjøretestene, og til slutt en oppsummering av delene og kravene.

\subsection{Opptrekk}
\label{sec:res-opptrekk}
Turtallet etter opptrekk er målt for de to tromlene med turtallsmåleren fra seksjon~\ref{sec:metode-tap}.

De første opptrekkene er gjort med Ø12-trommelen, $r_t = \SI{6}{mm}$.
Seks godkjente opptrekk ga \SI[separate-uncertainty=true]{2700 \pm 390}{o/min} rett etter at løkka slapp, med variasjonskoeffisient \SI{15}{\percent}. Det tilsvarer omtrent \SI{2,4}{J}, under halvparten av de \SI{5,3}{J} som var antatt. I ett av åtte opptrekk hang løkka seg opp, og svinghjulet stoppet på under ett sekund. Rett etter at løkka slipper, bremses svinghjulet ekstra i omtrent \SI{0,3}{s}, som tyder på at løkka eller snora drar litt i trommelen før den er helt fri.

Tolv opptrekk med Ø8-trommelen 10.~november 2026 ga \SI[separate-uncertainty=true]{2670 \pm 290}{o/min}. Forskjellen fra Ø12 er mye mindre enn spredningen, og energien i svinghjulet er omtrent den samme, \SI{2,3}{J} mot \SI{2,4}{J}. Tappen på Ø8-trommelen slapp løkka av seg selv i alle de tolv opptrekkene.

\subsection{Lagre og drivverk}
\label{sec:res-tapsledd}
\label{sec:res-utsnurring}
\label{sec:res-lager}
\label{sec:res-sim-lager}
Turtallsmåleren fra seksjon~\ref{sec:metode-tap} er brukt til å sammenligne lagrene på svinghjulsakselen og til å måle tapet i drivverket.

\paragraph{Lagrene på svinghjulsakselen.} Fire lagervarianter ble målt med utsnurring 6. og 7.~november 2026 (figur~\ref{fig:lagervarianter}). Snittmomentet fra 1000 til \SI{300}{o/min} var \SI{1,50}{mN.m} for de opprinnelige 626 2RS-lagrene med fett, \SI{4,11}{mN.m} med tetningene tatt ut og tynn olje, \SI{0,71}{mN.m} for de samme lagrene tørre og \SI{0,19}{mN.m} for åpne SKF Explorer 626. De tørre lagrene ble brukt i kjøretestene. De var ikke kjørt inn da de ble målt 7.~november, og momentet falt fra 1,0 til \SI{0,6}{mN.m} gjennom de seks opptrekkene i serien. Da de ble målt på nytt 10.~november, etter begge kjøretestene, var momentet rundt \SI{0,2}{mN.m}, det samme som for SKF-lagrene.

\begin{figure}[H]
    \centering
    
    \caption[Tapsmoment for lagervariantene]{Tapsmoment mot turtall for lagervariantene på svinghjulsakselen, målt ved utsnurring med tannhjulet frakoblet. De tørre lagrene er vist både før og etter at de var kjørt inn. Aksen for tapsmomentet er logaritmisk.}
    \label{fig:lagervarianter}
\end{figure}

\paragraph{Drivverket.}
\label{sec:res-drivverk}
Tapet i drivverket ble målt 10.~november 2026 med Ø8-trommelen og de tørre 626 2RS-lagrene. Tabell~\ref{tab:drivverk} viser resultatet.

\begin{table}[H]
    \centering
    \caption[Tapet i drivverket]{Tapsmoment ved svinghjulsakselen med tannhjulet koblet og frakoblet, 10.~november 2026, snitt og standardavvik mellom opptrekkene. $T_\text{dv}$ er differansen.}
    \label{tab:drivverk}
    \small
    \renewcommand{\arraystretch}{1.25}
    \begin{tabular}{|c|c|c|c|}
        \hline
        \textbf{Turtall [o/min]} & \textbf{Koblet [\si{mN.m}]} & \textbf{Frakoblet [\si{mN.m}]} & \textbf{$T_\text{dv}$ [\si{mN.m}]} \\
        \hline
        500 & 0,31 ± 0,01 & 0,19 ± 0,01 & 0,12 \\
        1000 & 0,29 ± 0,01 & 0,22 ± 0,09 & 0,07 \\
        1500 & 0,28 ± 0,02 & 0,18 ± 0,04 & 0,10 \\
        2000 & 0,30 ± 0,02 & 0,19 ± 0,02 & 0,11 \\
        \hline
    \end{tabular}
\end{table}

Å koble inn drivverket øker tapsmomentet med rundt \SI{0,1}{mN.m}, nesten uavhengig av turtallet, slik at det oppfører seg som en konstant friksjon. Tapet omfatter tannhjulsinngrepet, lagrene på drivakselen og luftmotstanden på hjulene. En tidligere utsnurring 6.~november, med fett i lagrene, ga \SI{1,2}{mN.m} mer med tannhjulet koblet enn frakoblet, altså omtrent ti ganger så mye. Forskjellen kommer trolig mest fra lagrene på drivakselen, som da hadde fett og ikke var kjørt inn.

\subsection{Første kjøretest}
\label{sec:res-kjoretest}
Den første kjøretesten ble gjort 7.~november 2026 med den ferdig monterte bilen (figur~\ref{fig:testoppsett}), bestående av den 3D-printede rammen (seksjon~\ref{sec:gd-ramme}), drivverket med $i = 4{,}29$, Ø68-hjul med TPU-dekk og 626 2RS-lagre uten tetninger og uten olje på alle tre akslene. Bilen veide \SI{270}{g}. Opptrekket ble gjort med Ø12-trommelen, og turtallet etter opptrekk ble ikke målt. Målet var å se om bilen fungerer som helhet, og å få et første tall for lengde og sideavvik. Testen er referansemålingen som grensene i R3--R6 ble satt etter.

Bilen ble kjørt fem ganger etter prosedyren i seksjon~\ref{sec:metode-kjoretest}. Tabell~\ref{tab:kjoretest1} viser alle forsøkene, og ingen er utelatt. Lengden var \SI[separate-uncertainty=true]{5,48 \pm 1,36}{m} (snitt og standardavvik), som tilsvarer en spredning på \SI{25}{\percent}. I forsøk 2 traff bilen et bord, slik at den målte lengden der er en nedre grense.

\begin{table}[H]
    \centering
    \caption[Første kjøretest]{Første kjøretest, 7.~november 2026. Svingradiusen er regnet med likning~\eqref{eq:svingradius}.}
    \label{tab:kjoretest1}
    \small
    \renewcommand{\arraystretch}{1.3}
    \begin{tabular}{|c|c|c|c|l|}
        \hline
        \textbf{Forsøk} & \textbf{Lengde [m]} & \textbf{Sideavvik [m]} & \textbf{Svingradius [m]} & \textbf{Kommentar} \\
        \hline
        1 & 3,29 & $-0{,}50$ & 10,8 & \\
        2 & 6,12 & $-4{,}15$ & 4,5 & Krasjet i et bord \\
        3 & 6,76 & $-1{,}75$ & 13,1 & \\
        4 & 6,14 & $-2{,}80$ & 6,7 & \\
        5 & 5,09 & 0 & -- & Rett fram \\
        \hline
        Snitt & 5,48 ± 1,36 & $-1{,}84$ & & \\
        \hline
    \end{tabular}
\end{table}

Bilen dro til venstre i fire av fem forsøk, med svingradius fra 4,5 til \SI{13}{m}. Bare forsøk 5 gikk rett. Bilen kjørte i en jevn bue og fikk ikke et brått retningsskifte ved starten. Regnet som sirkelbuer hadde bilen snudd omtrent 85° i forsøk 2 og 54° i forsøk 4 da den stoppet. Etter en så krapp bue er veien bilen faktisk kjørte, litt lengre enn den rette linja, \SI{6,7}{m} mot \SI{6,1}{m} i forsøk 2.

Ved nedsettingen slurte ofte høyre drivhjul så mye at det bare spant rundt, og bilen beveget seg nesten ikke fremover før hjulet fikk tak. For å finne årsaken til sideavviket ble tre ting kontrollert etter testen:
\begin{itemize}
    \item Ingen av drivhjulene slurer på akselen.
    \item Bilen går rett når den dyttes uten at svinghjulet driver.
    \item Drivhjulene har samme diameter.
\end{itemize}

Deretter ble hjullasten sjekket med papirtesten (seksjon~\ref{sec:metode-papirtest}). Lappen gled merkbart lettere under venstre drivhjul enn under høyre, noe som viser at venstre drivhjul bærer mindre last. Med et lodd på \SI{34}{g} over venstre drivhjul var lasten fortsatt størst på høyre. Papirtesten på alle fire hjulene viste at diagonalen høyre bakhjul og venstre forhjul bærer det meste av vekten.

\subsection{Andre kjøretest}
\label{sec:res-kjoretest2}
Etter papirtesten ble lagersetet for høyre drivhjul filt, slik at lasten på de to drivhjulene ble mer lik. Samtidig ble Ø12-trommelen byttet med Ø8-trommelen (seksjon~\ref{sec:tr-serien}). Ellers var bilen som i den første kjøretesten. Den andre kjøretesten ble gjort 9.~november 2026 på samme gulv og etter samme prosedyre, med ti forsøk. Turtallet etter opptrekk ble ikke målt. Tabell~\ref{tab:kjoretest2} viser alle forsøkene, og figur~\ref{fig:kjoretester} viser banene i begge kjøretestene.

\begin{table}[H]
    \centering
    \caption[Andre kjøretest]{Andre kjøretest, 9.~november 2026, etter at lagersetet for høyre drivhjul er filt. Svingradiusen er regnet med likning~\eqref{eq:svingradius}.}
    \label{tab:kjoretest2}
    \small
    \renewcommand{\arraystretch}{1.3}
    \begin{tabular}{|c|c|c|c|c|}
        \hline
        \textbf{Forsøk} & \textbf{Lengde [m]} & \textbf{Sideavvik [m]} & \textbf{$|y|/L$ [\%]} & \textbf{Svingradius [m]} \\
        \hline
        1 & 8,47 & $-2{,}47$ & 29 & 14,5 \\
        2 & 8,09 & $-0{,}83$ & 10 & 39,4 \\
        3 & 10,93 & $-3{,}91$ & 36 & 15,3 \\
        4 & 8,34 & $-1{,}56$ & 19 & 22,3 \\
        5 & 11,86 & $-3{,}24$ & 27 & 21,7 \\
        6 & 7,08 & $-0{,}19$ & 3 & 132 \\
        7 & 9,25 & $-2{,}78$ & 30 & 15,4 \\
        8 & 7,63 & $-1{,}12$ & 15 & 26,0 \\
        9 & 10,54 & $-3{,}65$ & 35 & 15,2 \\
        10 & 5,89 & $-2{,}04$ & 35 & 8,5 \\
        \hline
        Snitt & 8,81 ± 1,85 & $-2{,}18$ & 24 & \\
        \hline
    \end{tabular}
\end{table}

Lengden var \SI[separate-uncertainty=true]{8,81 \pm 1,85}{m}, som tilsvarer en spredning på \SI{21}{\percent}. Det er \SI{61}{\percent} lengre enn i den første kjøretesten, og alle ti forsøkene var over \SI{5}{m}. Bilen kjørte av seg selv i alle ti forsøkene og traff ikke noe.

Bilen dro fortsatt til venstre i alle ti forsøkene, men buene var slakere (figur~\ref{fig:kjoretester}). Svingradiusen var 8,5 til \SI{39}{m}, med median \SI{19}{m} mot \SI{9}{m} i den første kjøretesten, og forsøk 6 gikk nesten rett. Sideavviket var i snitt \SI{24}{\percent} av lengden, mot \SI{31}{\percent}. Siden bilen kjørte lenger, ble sideavviket i meter likevel omtrent det samme, i snitt \SI{-2,18}{m} mot \SI{-1,84}{m}.

\begin{figure}[H]
    \centering
    
    \caption[Banene i kjøretestene]{Banene i de to kjøretestene, tegnet som sirkelbuer fra start (firkant) til stopp (punkt) ut fra målt lengde og sideavvik. Bilen starter rett oppover. Stoppunktet må ligge i det grå feltet for at sideavviket skal være under \SI{10}{\percent} av lengden (R5).}
    \label{fig:kjoretester}
\end{figure}

\subsection{Oppsummering av deler og krav}
\label{sec:res-kravstatus}
Tabell~\ref{tab:deler-samlet} oppsummerer versjonene av de fysiske delene og hvilken som er brukt i den ferdige bilen.

\begin{table}[H]
    \centering
    \caption[Versjonene av de fysiske delene]{Versjonene av de fysiske delene, med hovedtesten fra tabell~\ref{tab:iterasjonsserier}.}
    \label{tab:deler-samlet}
    \small
    \renewcommand{\arraystretch}{1.3}
    \begin{tabular}{|p{2.1cm}|p{2.9cm}|p{6.3cm}|p{1.8cm}|}
        \hline
        \textbf{Del} & \textbf{Versjoner} & \textbf{Resultat av hovedtesten} & \textbf{Valgt} \\
        \hline
        Lagersete & Prøveringer Ø18,9--Ø19,3 & Ø19,0 gikk stramt inn, Ø19,1 var passe romslig & Ø19,1 \\
        \hline
        Firkantnav & Hull 4,0--\SI{4,3}{mm} & \SI{4,3}{mm} ga best pasning. Ingen av drivhjulene slurte på akselen ved kontrollen etter den første kjøretesten & \SI{4,3}{mm} \\
        \hline
        Klemnav & Én versjon & Sklei på akselen i den første serien, holdt etter at skruene ble strammet jevnt & Beholdt \\
        \hline
        Snortrommel & Ø12 med krok, Ø8 med tapp & \SI[separate-uncertainty=true]{2700 \pm 390}{o/min} og \SI[separate-uncertainty=true]{2670 \pm 290}{o/min}. Kroken hang seg opp i 1 av 8 opptrekk, tappen slapp i 12 av 12 & Ø8 \\
        \hline
        Drivhjul & PLA uten dekk, PLA-felg med TPU-dekk & Uten dekk spant drivhjulene lenge ved nedsetting. Med TPU-dekk kjørte bilen \SI{8,81}{m} i snitt & TPU-dekk \\
        \hline
    \end{tabular}
\end{table}

Tabell~\ref{tab:kravstatus} viser status for kravene i seksjon~\ref{sec:produktkrav} etter den andre kjøretesten.

\begin{table}[H]
    \centering
    \caption[Status for kravene]{Status for kravene etter den andre kjøretesten, 9.~november 2026. Tallene i parentes er fra den første kjøretesten.}
    \label{tab:kravstatus}
    \small
    \renewcommand{\arraystretch}{1.3}
    \begin{tabular}{|l|p{3.9cm}|p{5.1cm}|l|}
        \hline
        \textbf{Krav} & \textbf{Grense} & \textbf{Resultat} & \textbf{Status} \\
        \hline
        R1 & $140 \times 85 \times 70$ mm, utdelt svinghjul og aksel, 20 cm snor & $140 \times 83$ mm i CAD, høyden under 70. Lengden er målt til under \SI{140}{mm} på bilen. Svinghjul, aksel og snor brukt som utdelt & Oppfylt \\
        \hline
        R2 & Kjører av seg selv & 10 av 10 forsøk (5 av 5) & Oppfylt \\
        \hline
        R3 & Minst \SI{5}{m} i snitt, 10 kjøringer & \SI{8,81}{m} i snitt, 10 kjøringer (\SI{5,48}{m}, 5 kjøringer) & Oppfylt \\
        \hline
        R4 & Standardavvik under \SI{15}{\percent} & \SI{21}{\percent} (\SI{25}{\percent}) & Ikke oppfylt \\
        \hline
        R5 & Sideavvik under \SI{10}{\percent} av lengden & \SI{24}{\percent} i snitt, til venstre i 10 av 10 (\SI{31}{\percent}, 4 av 5) & Ikke oppfylt \\
        \hline
        R6 & Minst 9 av 10 vellykkede & 10 av 10 (4 av 5, forsøk 2 traff et bord) & Oppfylt \\
        \hline
        R7 & Kan demonteres og justeres & Klemnav og firkantnav kan løsnes. Andre utvekslinger med samme akseavstand, som 18\,:\,72, kan printes & Oppfylt ved inspeksjon \\
        \hline
        R8 & Kan lages med tilgjengelig utstyr & 3D-printer og verksted & Oppfylt \\
        \hline
    \end{tabular}
\end{table}

\begin{comment}
% Testresultatene presenteres her. Tolkninger hører hjemme i diskusjonen.
\subsection{Funksjon og pålitelighet}
\subsection{Kjøredistanse og repeterbarhet}
\subsection{Retningsstabilitet og sammenligning av konfigurasjoner}
% Fyll inn faktiske målinger, tabeller og figurer etter testing.
\end{comment}
