olivertiller/KERS-bil/Rapport/Sections/Experimental_method.tex

\section{Testmetode}
\label{sec:metode}
Bilen er testet på tre måter. Turtallet til svinghjulet er målt med en turtallsmåler, hele bilen er kjøretestet på gulv, og lasten på hjulene er sammenlignet med en papirtest.

\subsection{Måling av turtall}
\label{sec:metode-tap}
\label{sec:ml-serien}
\label{sec:utsnurring-behandling}
Som hjelpeverktøy under prototypingen ble det laget en enkel turtallsmåler. En Hall-sensor registrerer to magneter på svinghjulsakselen, og en ESP32 logger tidspunktet for hver halve omdreining (figur~\ref{fig:esp-oppsett}). Måleren er brukt til å måle turtallet etter opptrekk, for å sammenligne trommelene, og til utsnurring, der svinghjulet trekkes opp med bilen løftet og får snurre fritt til det stopper. Hvor fort svinghjulet bremser ned, gir tapsmomentet etter likning~\eqref{eq:snittmoment}, med $I = \SI{6,0e-5}{kg.m^2}$. Lagervariantene på svinghjulsakselen er sammenlignet med snittmomentet fra 1000 til \SI{300}{o/min} med tannhjulet frakoblet, og tapet i drivverket med utsnurring med tannhjulet koblet og frakoblet.

\begin{figure}[H]
    \centering
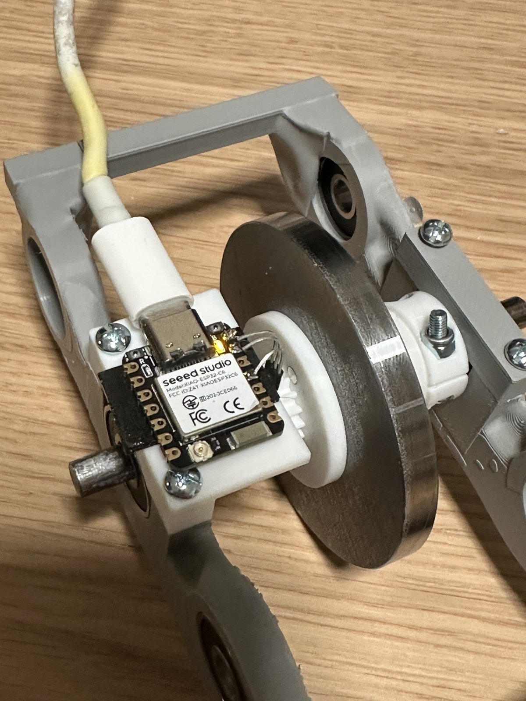
[picture p44: Rapport/Images/Foto/Ferdig/esp_oppsett.jpg]
    
    \caption[Turtallsmåleren]{Turtallsmåleren: ESP32 med Hall-sensor ved magnetskiva på svinghjulsakselen.}
    \label{fig:esp-oppsett}
\end{figure}

\subsection{Kjøretest}
\label{sec:metode-kjoretest}
Kjøretestene gjøres med hele bilen på et parkett- eller laminatgulv (figur~\ref{fig:testoppsett}). Svinghjulet trekkes opp med snor på trommelen mens bilen holdes løftet, og bilen settes ned med svinghjulet i gang, slik konkurransereglene krever. Startlinja er startretningen forlenget. Lengden $L$ måles med målebånd som rett linje fra startpunktet til der bilen stopper, og sideavviket $y$ som den vinkelrette avstanden fra stoppunktet til startlinja, positivt mot høyre og negativt mot venstre (figur~\ref{fig:testoppsett}c). Alle forsøk registreres, også mislykkede.

\begin{figure}[H]
    \centering
    \begin{subfigure}[b]{0.36\textwidth}
        \centering
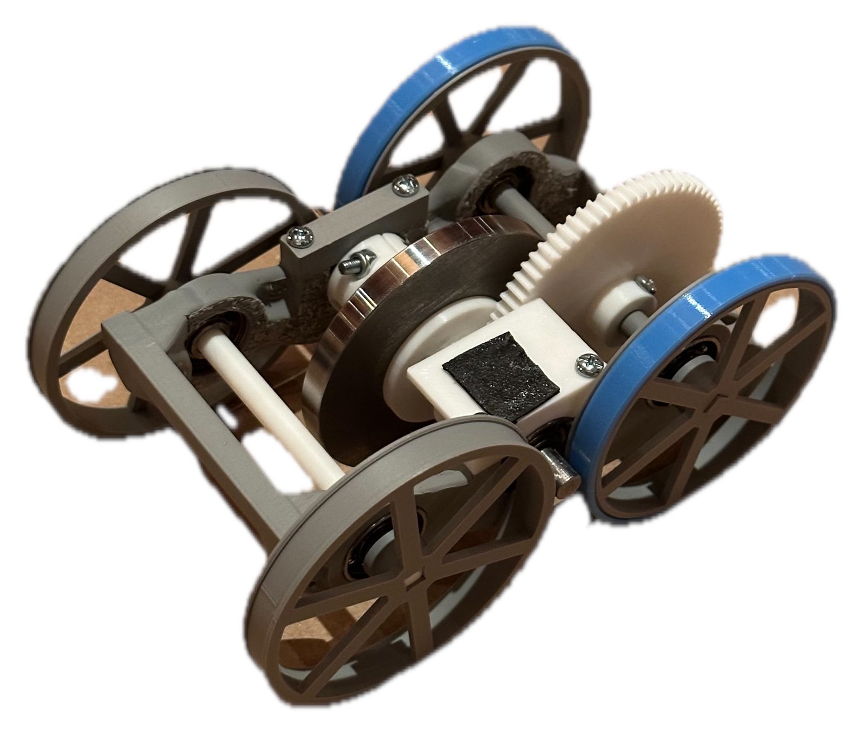
[picture p45: Rapport/Images/Foto/Ferdig/bil_skraatt_bak.jpg]
        
        \caption{Bilen som testet}
    \end{subfigure}
    \hfill
    \begin{subfigure}[b]{0.27\textwidth}
        \centering
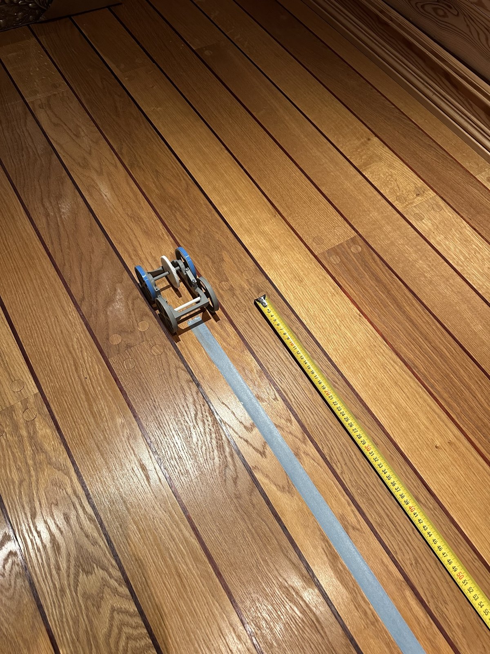
[picture p46: Rapport/Images/Foto/Ferdig/testoppsett.jpg]
        
        \caption{Testoppsett}
    \end{subfigure}
    \hfill
    \begin{subfigure}[b]{0.25\textwidth}
        \centering
        
        \caption{Lengde og sideavvik}
    \end{subfigure}
    \caption[Kjøretesten]{Kjøretesten. (a) Bilen slik den ble kjøretestet, \SI{270}{g}. (b) Gulvet med målebånd. (c) Lengden måles som rett linje fra start til stopp, og sideavviket vinkelrett på startlinja. Banen er forsøk 4 i den første kjøretesten.}
    \label{fig:testoppsett}
\end{figure}

Hvis bilen kjører i en sirkelbue som starter langs startlinja, gir lengden $L$ og sideavviket $y$ svingradiusen
\begin{equation}
    R = \frac{L^2}{2\,|y|}.
    \label{eq:svingradius}
\end{equation}
Repeterbarheten (R4) vurderes med standardavviket av lengden i prosent av snittet, og retningsstabiliteten (R5) med snittet av $|y|/L$.

\subsection{Papirtest av hjullasten}
\label{sec:metode-papirtest}
Lasten på hjulene sammenlignes med en papirtest på plant underlag (figur~\ref{fig:papirtest}). En papirlapp trekkes ut under ett hjul om gangen, og jo tyngre lappen går, jo mer last bærer hjulet.

\begin{figure}[H]
    \centering
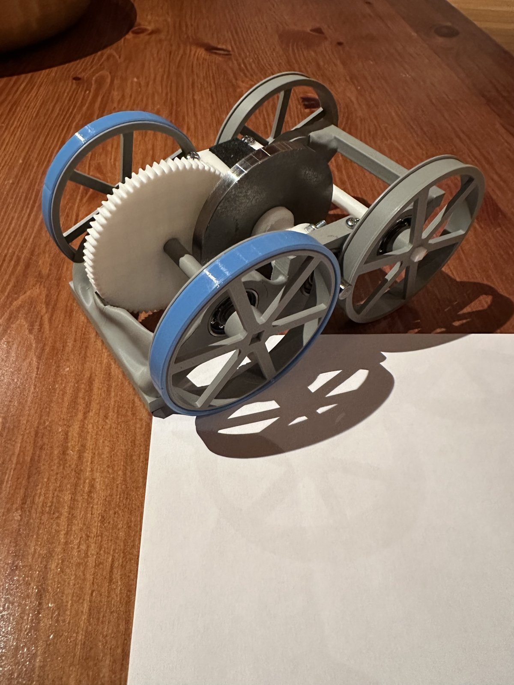
[picture p47: Rapport/Images/Foto/Ferdig/papirtest.jpg]
    
    \caption[Papirtesten]{Papirtesten. Et papirark trekkes ut under ett hjul om gangen, og jo tyngre det går, jo mer last har hjulet.}
    \label{fig:papirtest}
\end{figure}

\begin{comment}
\subsection{Mål for testen}
Testene skal dokumentere funksjon, kjøredistanse, repeterbarhet og retningsstabilitet.

\subsection{Hypotese}
% Formuler hva testene forventes å vise, for eksempel forventet kjøredistanse ut fra overslaget i teorikapittelet.

\subsection{Testoppsett, utstyr og underlag}
Underlag, måleutstyr og måleoppløsning beskrives før gjennomføring.

\subsection{Standardisert opptrekk og startprosedyre}
Bilen holdes løftet under opptrekk og settes ned med svinghjulet i gang, i tråd med konkurransereglene. Trådlengde, opptrekksmåte, startposisjon, retning og frigjøring holdes så like som mulig. Lik trådlengde alene sikrer ikke lik tilført energi; variasjon i opptrekk registreres som en mulig feilkilde.

\subsection{Testdesign}
Planen er å gjennomføre 10--20 referansekjøringer og minst 10 kjøringer per sammenlignet konfigurasjon. Endre én faktor om gangen der dette er praktisk, og registrer prototypeversjon og testrekkefølge. Definer måling av kjøredistanse og sideavvik entydig før testene.

\subsection{Registrering og behandling av data}
Loggen skal inneholde kjøringsnummer, dato, konfigurasjon, opptrekk, distanse, sideavvik, vellykket eller mislykket kjøring og observasjoner. Alle forsøk registreres; eventuelle utelatelser begrunnes. Rapporter gjennomsnitt, standardavvik, antall forsøk og suksessandel med tydelig angivelse av hvilke forsøk som inngår.
% Gi formlene for gjennomsnitt og standardavvik som brukes i analysen.

\subsection{Måleusikkerhet og feilkilder}
% Vurder opptrekk, underlag, startretning, måleavlesning og endringer i prototypen mellom kjøringene.
\end{comment}
