olivertiller/KERS-bil/Bygg/Testing/Testing.xlsx

Test versjon 1
Forsøk | Lengde (cm) | Sideveis bevegelse (+ for høyre, - for venstre) | Kommentar
1 | 329 | -50
2 | 612 | -415 | Krasjet i bord
3 | 676 | -175
4 | 614 | -280
5 | 509 | 0
Test versjon 2
Forsøk | Lengde (cm) | Sideveis bevegelse (+ for høyre, - for venstre) | Kommentar
1 | 847 | -247
2 | 809 | -83
3 | 1093 | -391
4 | 834 | -156
5 | 1186 | -324
6 | 708 | -19
7 | 925 | -278
8 | 763 | -112
9 | 1054 | -365
10 | 589 | -204
