olivertiller/KERS-bil/Rapport/Images/Maling/ml_flanker.pdf

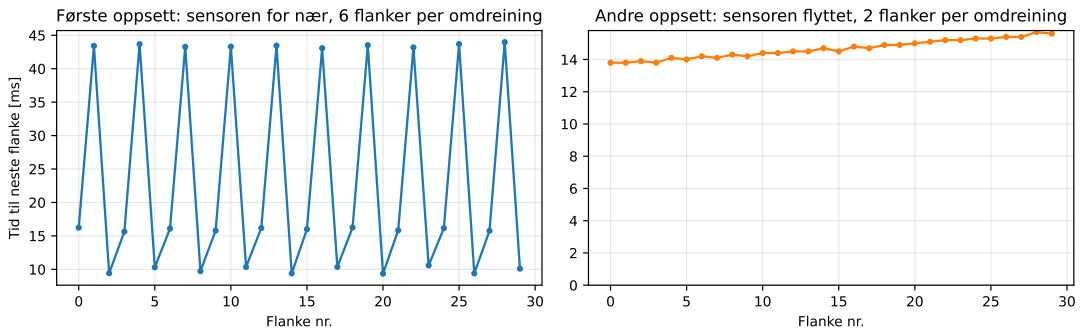
[picture p48: page 1]
Flanke nr.; flanke [ms]

Første oppsett: sensoren for nær, 6 flanker per omdreining

Andre oppsett: sensoren flyttet, 2 flanker per omdreining

Tid til neste
