olivertiller/KERS-bil/Rapport/Images/Tegninger/DH-2.pdf

A

A–A

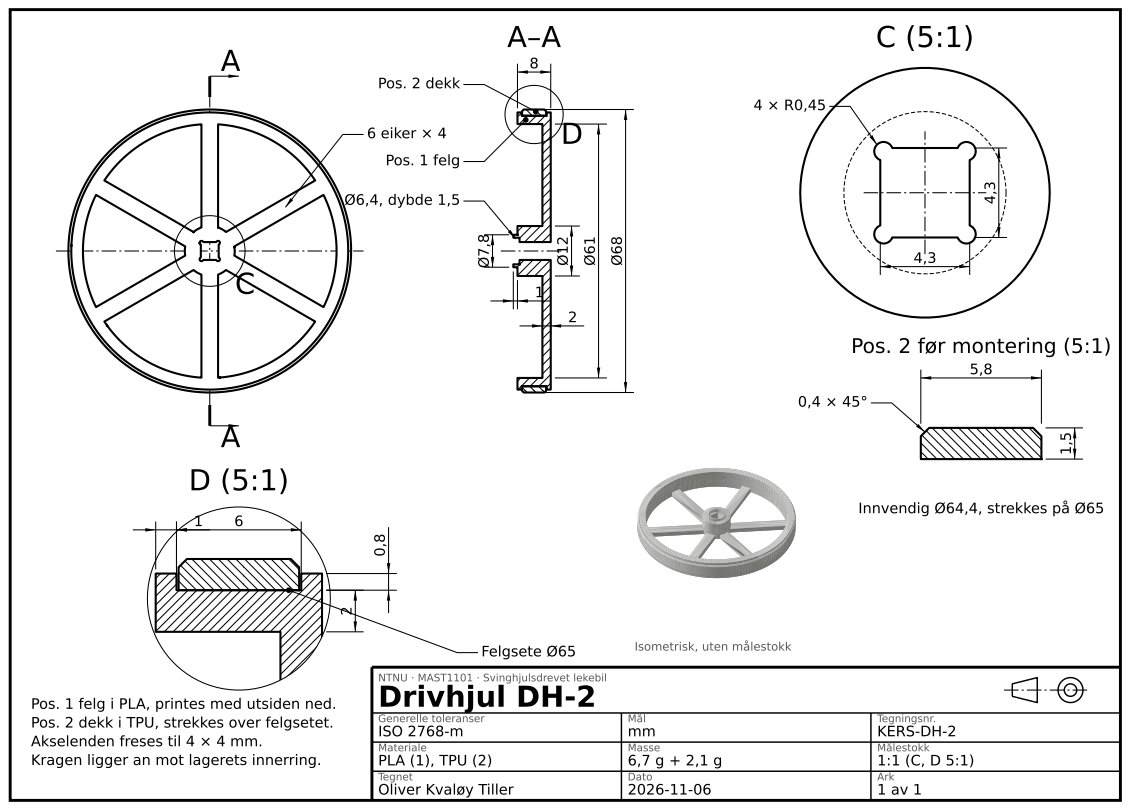
[picture p49: page 1]
6 eiker × 4; Ø6,4, dybde 1,5; Pos. 2 dekk; Pos. 1 felg; Felgsete Ø65; Dato 2026-11-06; Ark 1 av 1; Materiale PLA (1), TPU (2); Masse 6,7 g + 2,1 g; Målestokk 1:1 (C, D 5:1); Generelle toleranser ISO 2768-m; Mål mm; Tegningsnr. KERS-DH-2

Pos. 2 før montering (5:1)

Innvendig Ø64,4, strekkes på Ø65

Drivhjul DH-2
NTNU · MAST1101 · Svinghjulsdrevet lekebil

Isometrisk, uten målestokk

Pos. 1 felg i PLA, printes med utsiden ned.
Pos. 2 dekk i TPU, strekkes over felgsetet.
Akselenden freses til 4 × 4 mm.
Kragen ligger an mot lagerets innerring.

Tegnet
Oliver Kvaløy Tiller
