olivertiller/KERS-bil/Rapport/Images/Tegninger/TR-1.pdf

A–A

B

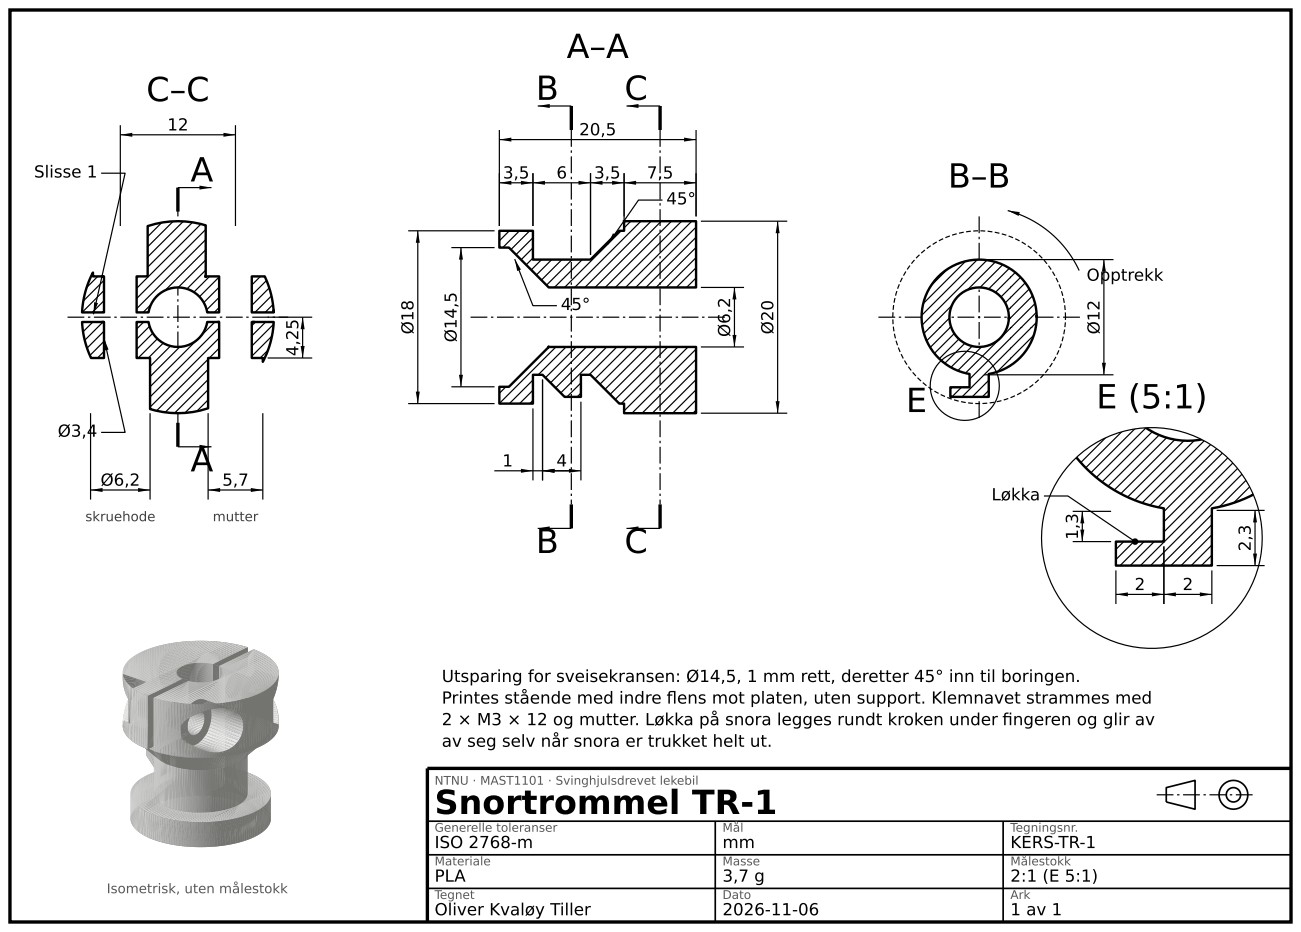
[picture p50: page 1]
Slisse 1; skruehode; mutter; Opptrekk; Løkka; Dato 2026-11-06; Ark 1 av 1; Masse 3,7 g; Målestokk 2:1 (E 5:1); Mål mm; Tegningsnr. KERS-TR-1

Utsparing for sveisekransen: Ø14,5, 1 mm rett, deretter 45° inn til boringen.
Printes stående med indre flens mot platen, uten support. Klemnavet strammes med
2 × M3 × 12 og mutter. Løkka på snora legges rundt kroken under fingeren og glir av
av seg selv når snora er trukket helt ut.
Snortrommel TR-1
NTNU · MAST1101 · Svinghjulsdrevet lekebil

Generelle toleranser
ISO 2768-m
Materiale
PLA
Tegnet
Oliver Kvaløy Tiller

Isometrisk, uten målestokk
