olivertiller/KERS-bil/Bygg/Laserkutt/test_v1.pdf

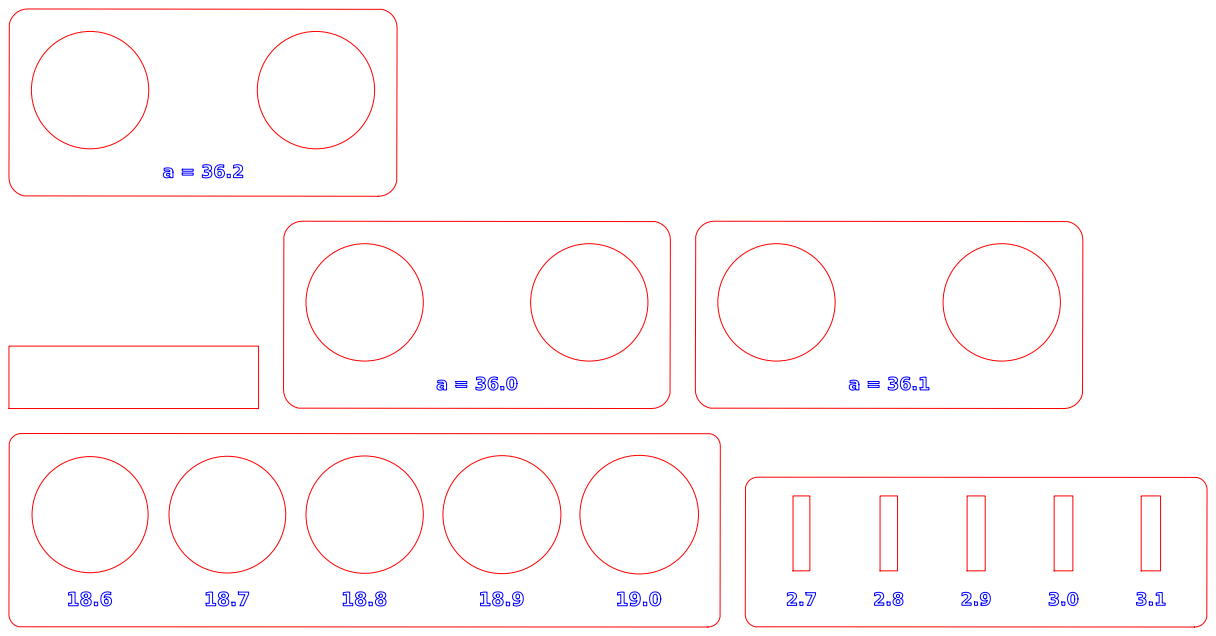
[picture p51: page 1]
