olivertiller/KERS-bil/Rapport/Images/Maling/lagervarianter.pdf

10

## Lagrene på svinghjulsakselen, tannhjulet frakoblet

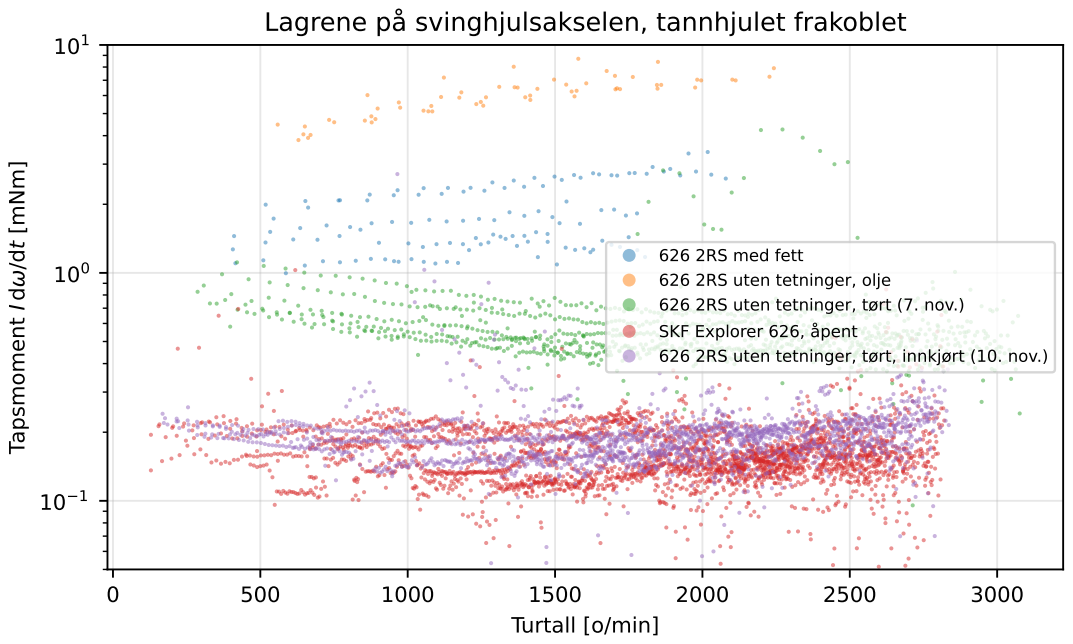
[picture p52: page 1]
Turtall [o/min]; Tapsm

ent I dω/dt [m

626 2RS med fett
626 2RS uten tetninger, olje
626 2RS uten tetninger, tørt (7. nov.)
SKF Explorer 626, åpent
626 2RS uten tetninger, tørt, innkjørt (10. nov.)
