olivertiller/KERS-bil/Rapport/Images/Kjoretest/kjoretester.pdf

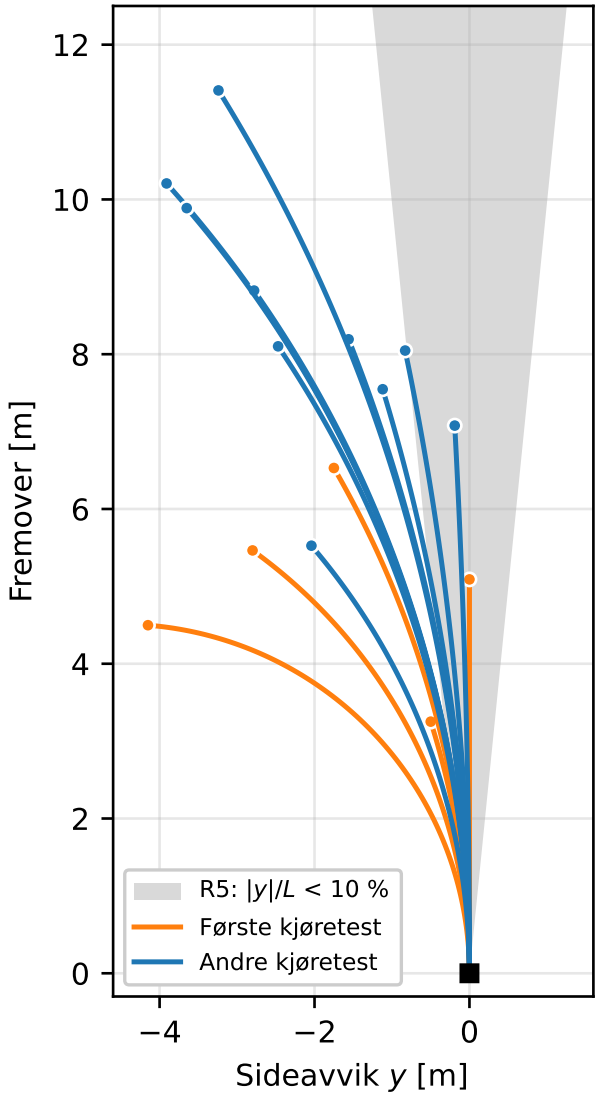
[picture p53: page 1]
Sideavvik y [m]; Fremover [m]; Første kjøretest Andre kjøretest
