olivertiller/KERS-bil/Rapport/Images/Maling/tapsmoment.pdf

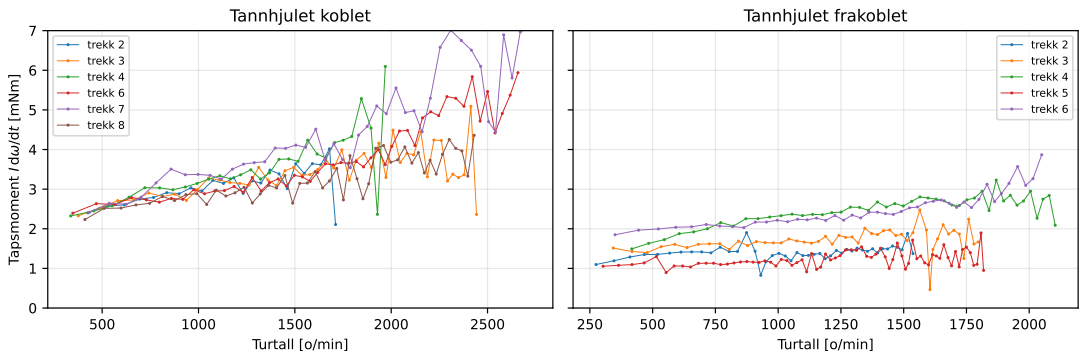
[picture p54: page 1]
Turtall [o/min]; Tannhjulet koblet; trekk 2 trekk 3 trekk 4 trekk 6 trekk 7 trekk 8; Tannhjulet frakoblet; trekk 2 trekk 3 trekk 4 trekk 5 trekk 6

Tapsmoment I dω/dt [mNm]
