olivertiller/KERS-bil/Rapport/Images/Maling/utsnurring_referanse.pdf

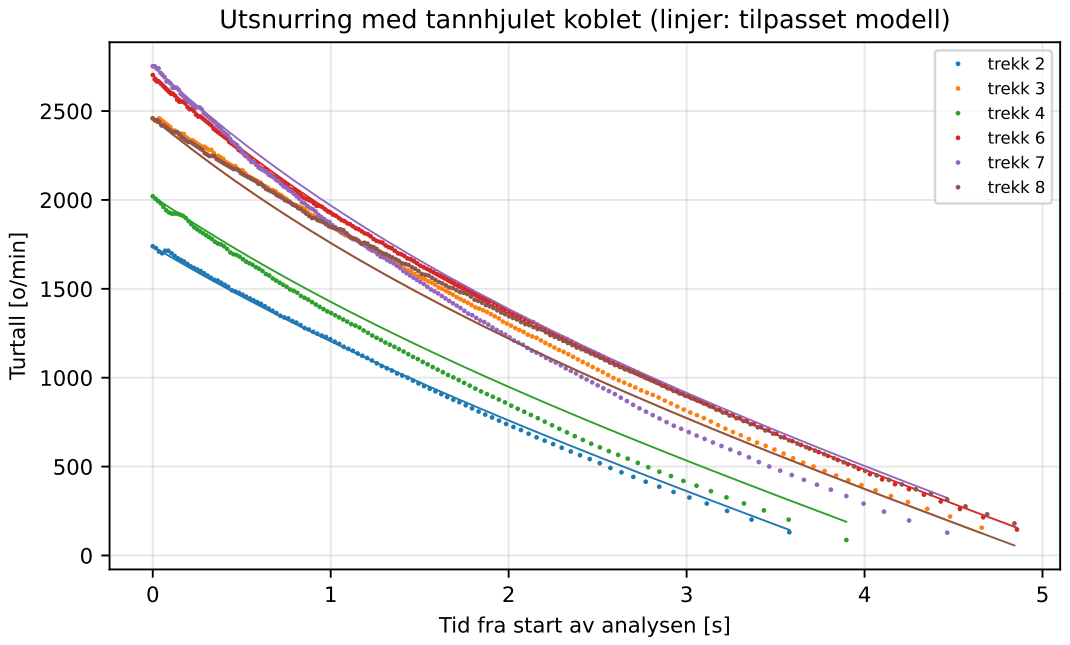
[picture p55: page 1]
Turtall [o/min]

Utsnurring med tannhjulet koblet (linjer: tilpasset modell)

trekk 2 trekk 3 trekk 4

trekk 6 trekk 7 trekk 8

Tid fra start av analysen [s]
