olivertiller/KERS-bil/Rapport/Images/Konsepter/konsept2_cvt.pdf

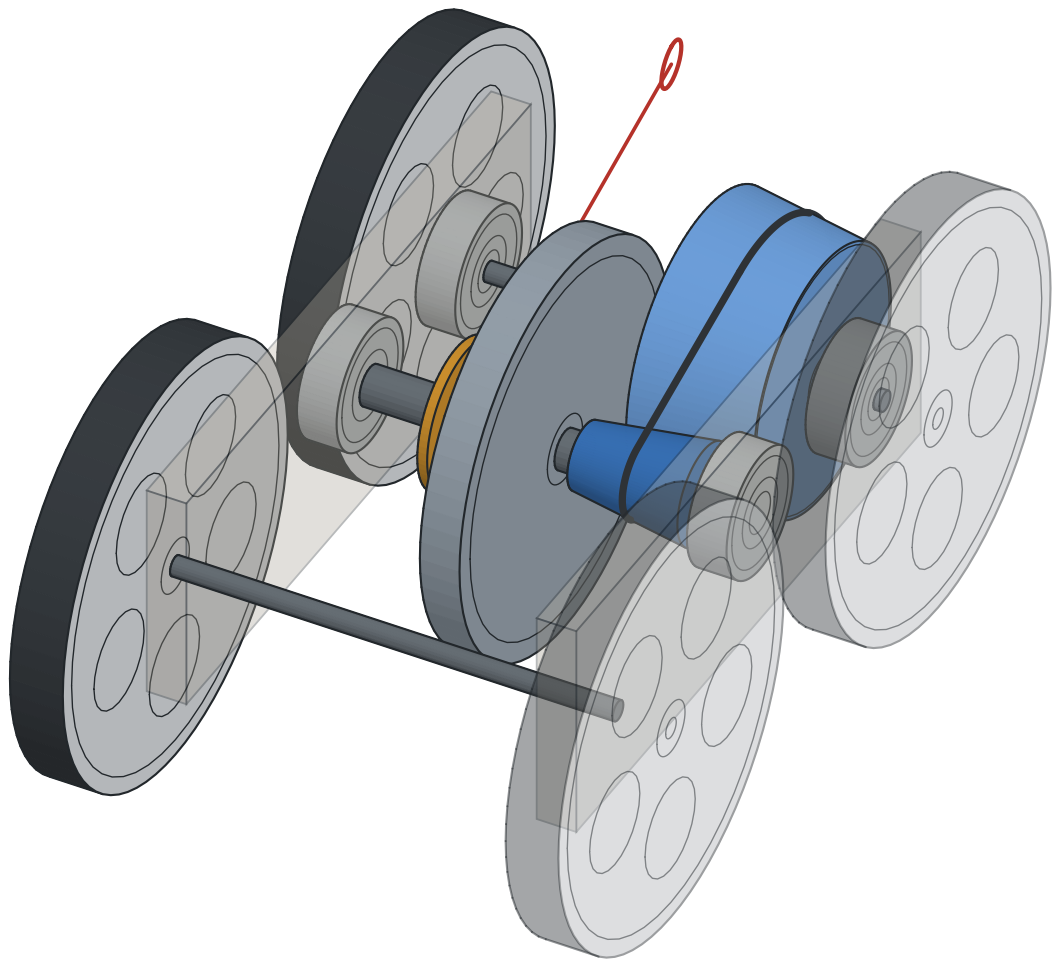
[picture p56: page 1]
