olivertiller/KERS-bil/Bygg/Laserkutt/kropp_v1.pdf

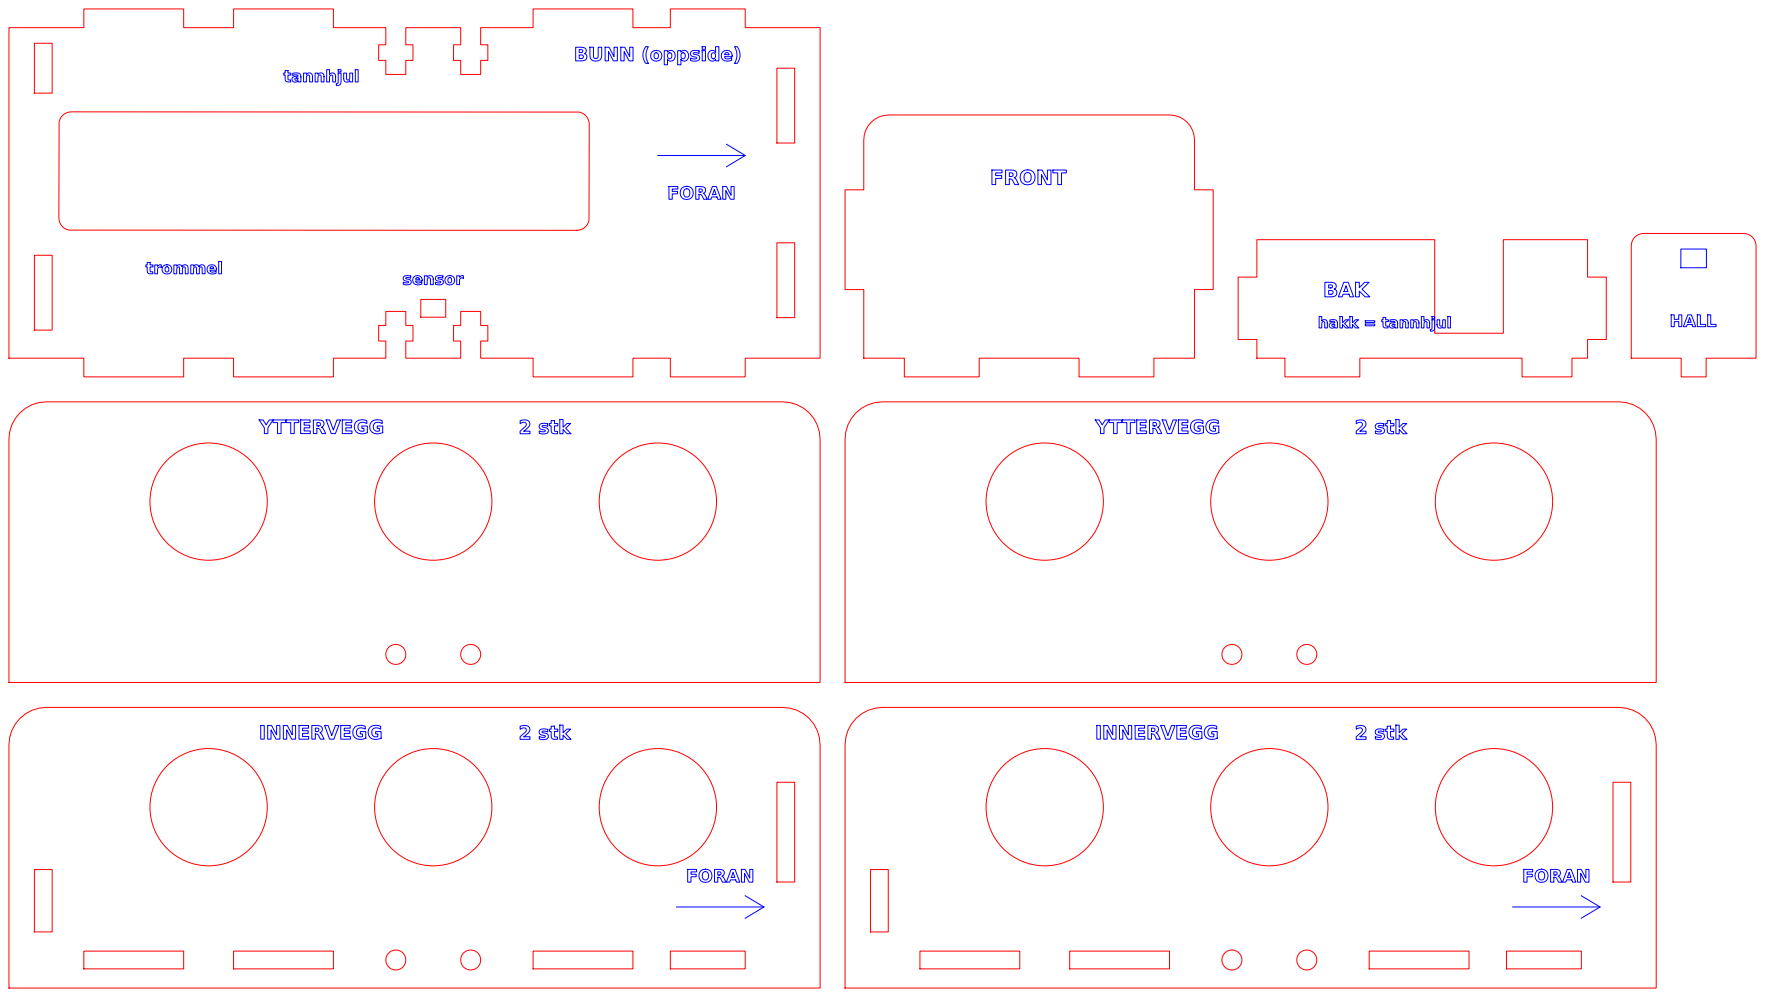
[picture p57: page 1]
