olivertiller/KERS-bil/Kers-bil/Laserkutt/lagerplate.pdf

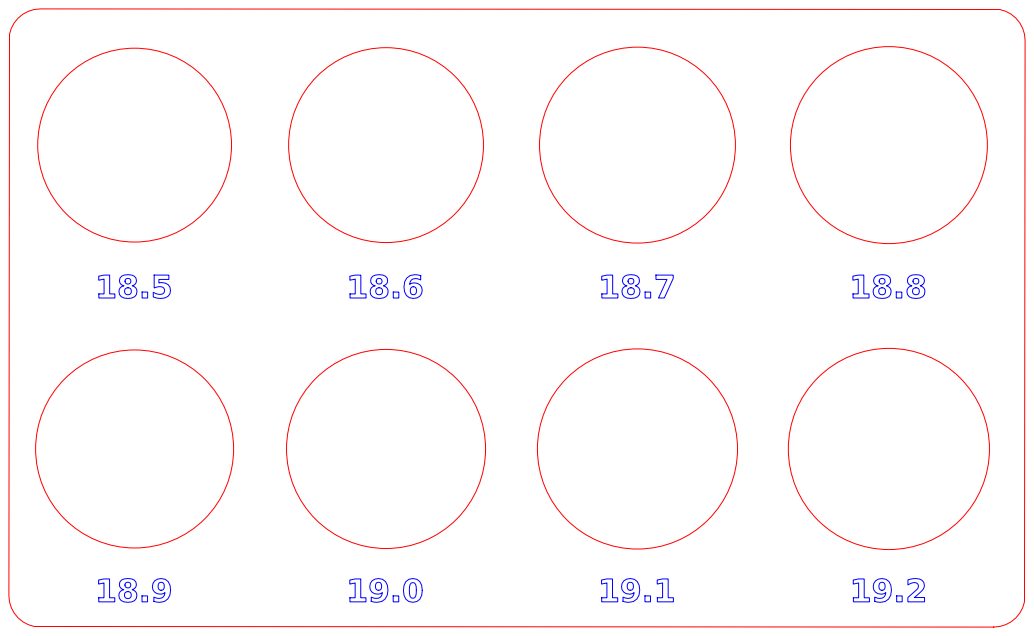
[picture p58: page 1]
