olivertiller/KERS-bil/Images/Konsepter/konsept1_direkte.pdf

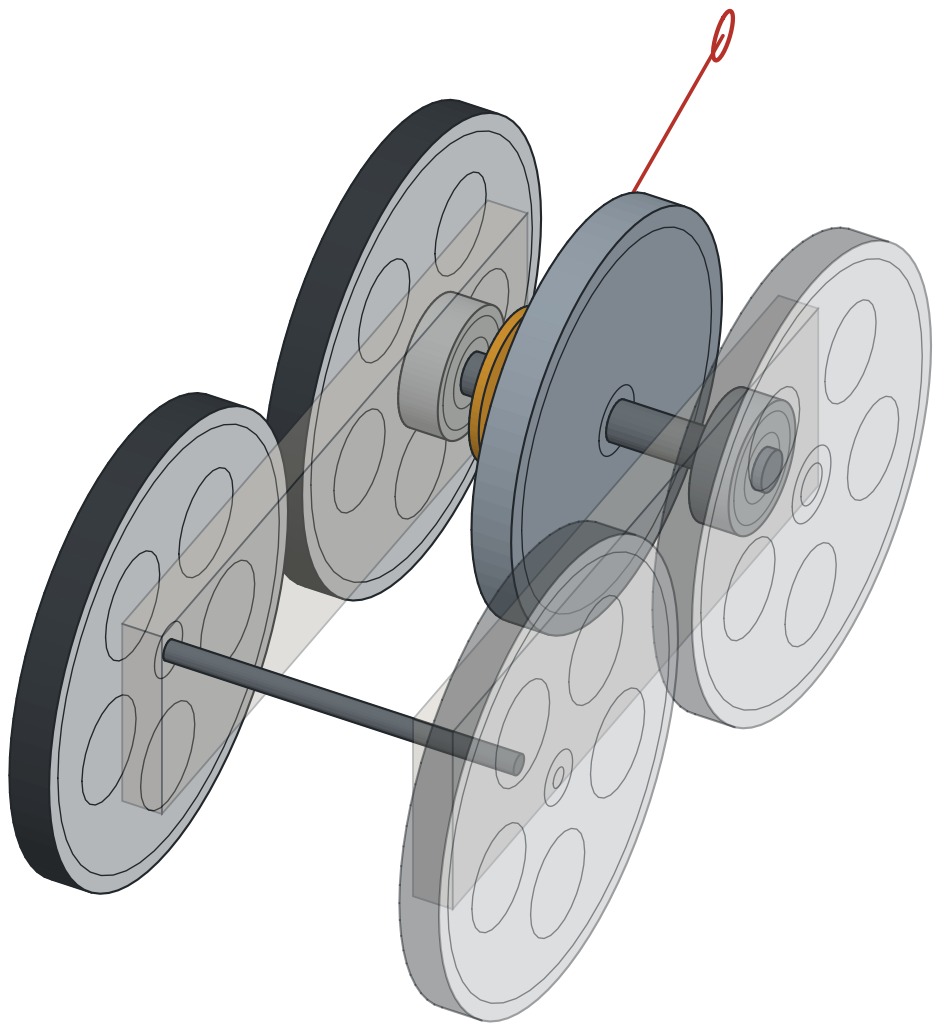
[picture p59: page 1]
