olivertiller/KERS-bil/Images/Konsepter/konsept3_tannhjul.pdf

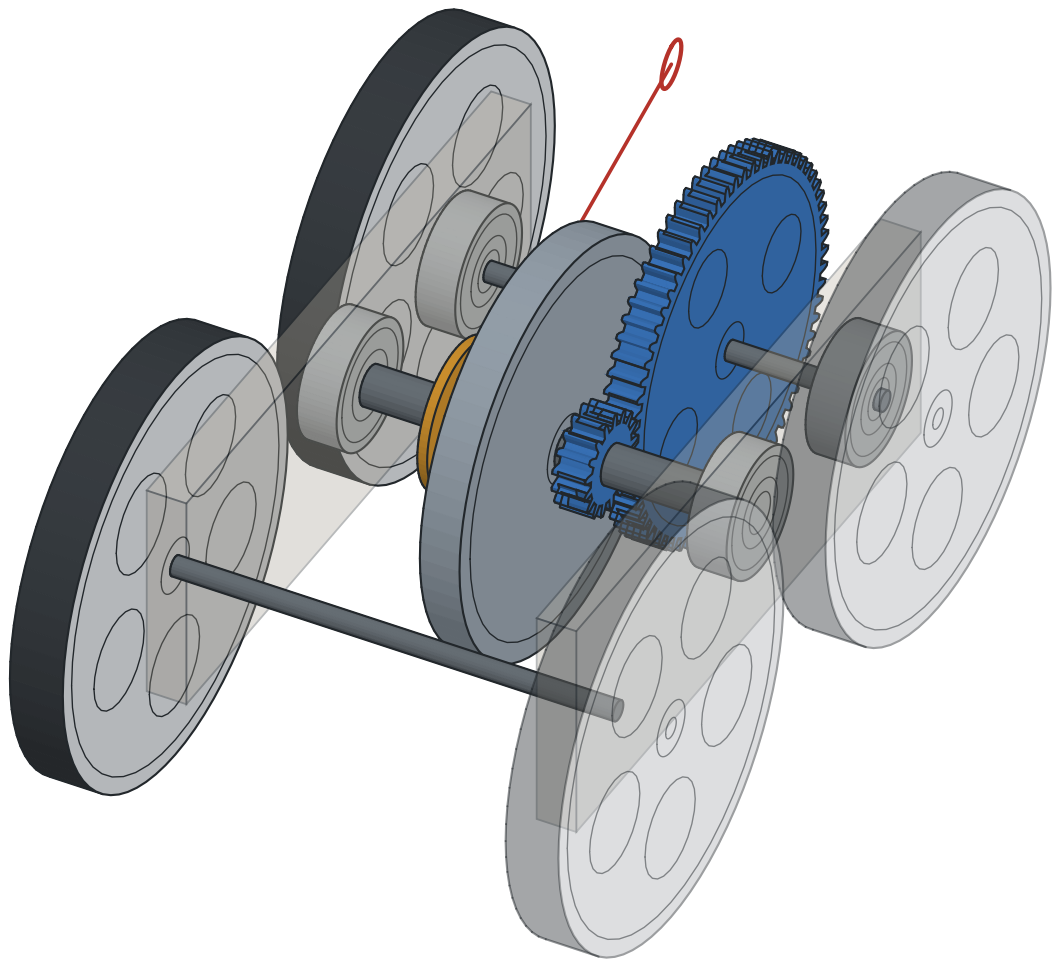
[picture p60: page 1]
