olivertiller/KERS-bil/Images/Maling/ml_flanker.pdf

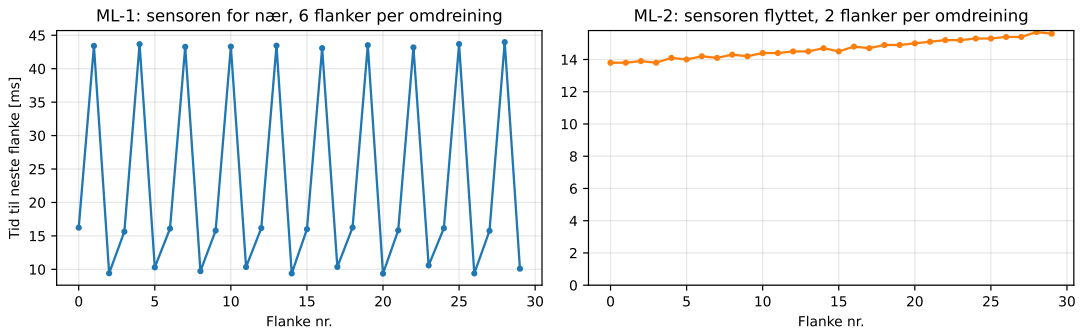
[picture p61: page 1]
Flanke nr.; flanke [ms]

ML-1: sensoren for nær, 6 flanker per omdreining

ML-2: sensoren flyttet, 2 flanker per omdreining

Tid til neste
