olivertiller/KERS-bil/(commit log)

2026-10-22 Legg inn konseptskisser og beskrivelse av de tre konseptene
    Claude-Session: https://claude.ai/code/session_019MxUrWHpSGQfEeCMG2YPVz
2026-10-29 Dokumenter den iterative prosessen med versjonerte prototypeserier
    Legger inn metode for iterativ prototyping etter Espedal (2024), DV-serien
    for drivverket med evalueringstabeller, og seriene LS, NV, TR, DH og ML
    med maler for evaluering. Startprosedyren med løftet bil er tatt inn i
    konseptevalueringen og testmetoden.
    Claude-Session: https://claude.ai/code/session_01MwiS8Go7HuCgBK7gh38qSm
2026-11-03 Legg til laserkuttet MDF-kropp og generativ ramme for 3D-print
    MDF-kropp v1 (Code/laserkutt_kropp.py → Kers-bil/Laserkutt/):
    - To limte lag 3 mm MDF per vegg (6 mm = 626-lagerbredden), seks lagerhull
    - Én vegg skrus på etterpå med M3 i T-spor, slik at svinghjulet kan settes inn
    - Testark for kerf og akseavstand, og egen lagerplate Ø18,5–19,2
    Generativ ramme (Code/Fusion/ → Kers-bil/Generativ_ramme/):
    - Fusion-skript som bygger preserve- og obstacle-geometri for Generative Design
    - U-seter med skrudde lagerlokk for svinghjulet, bevarte tverrbjelker og innerrom
    som gir en lukket, rektangulær ramme
    - Skript som setter inn drivverket for Interference, og overlappskontroll i Python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
2026-11-06 Legg inn utsnurringsmålinger, ML-serien og oppdaterte prototypeserier
    - Prototyping: NV med klemnav og firkantnav, TR uten magneter med
    første resultat for TR-1, DH med TPU-dekk, og problemløsning
    (sensor, løs trommel, sideveis glidning med avstandshylser, lagerfett)
    - Testmetode: ML-1 og ML-2 med versjonstabeller, opptrekk med drill og
    behandling av utsnurringsdata med feilkilder
    - Resultater: utsnurring med tannhjulet koblet og frakoblet, tapsmodell
    og simulering med målte tap
    - Diskusjon om målte tap, tekst om KI-bruk og bilder av prototypen
    Claude-Session: https://claude.ai/code/session_01MwiS8Jpf7TmhNccXypH2zk
2026-11-06 Legg til måledata og skriptene rapporten viser til
    Simulering og tilpasning av tapsmodell (kers_sim.py), rapportfigurene,
    logger- og diagnoseprogrammet for Hall-sensoren med rådata fra
    utsnurringen, og geometriskriptene for snortrommel, pinjong, hjul,
    avstandshylser og drillhjul.
    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
2026-11-06 Utvid rapporten med generativ design av rammen
    Ny seksjon om rammen med oppsett, lasttilfeller, GD-1 (åpen U) og GD-2
    (lukket, valgt resultat 2), sammenligning av resultatene fra Fusion,
    print og vurdering. Legger til GD-serien i tabellen over iterasjoner,
    oppdaterer LS-delen til seks lagre i rammen og tar med figurer fra
    Fusion og et skript som lager riss av rammen fra STL-filen.
    Claude-Session: https://claude.ai/code/session_01MwiS8GnmTV7dtMofSZKwTB
2026-11-07 Flytt dynamikk til V27, kort ned rammen og flytt detaljer til vedlegg
    - Simuleringen brukes nå bare som digital prototype (ny 3.1.1); utledning,
    validering og optimering er flyttet til KERS-bil-dynamikkV27
    - Fjernet fig. 23, drillopptrekk, ML-3, detaljer om tapstilpasningen og
    det meste av tohjulingen; ny 8.2.3 lister det som er utsatt
    - Ny 2.5 om friksjon i lagre (SKF-modellen) og snittmoment
    - Rettet n_trinn i kers_sim.py fra 2 til 1; nye tall i tab:lagerplan
    - Generativ design (5.2) kortet til omtrent halvparten, med én samlet
    evalueringstabell for GD-1 og GD-2
    - Maskintegninger, risikovurdering og tabeller per opptrekk flyttet til vedlegg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
2026-11-07 Kort ned måleoppsett og utsnurring, flytt detaljene til V27
    - Testmetode 6.1 og Resultater 7.1 slått sammen til korte seksjoner med
    tabellen over lagervarianter og en kortere lagerplan
    - Diskusjonen om lagrene, sensorproblemet og rådata-vedlegget forkortet
    eller fjernet; originalteksten ligger i KERS-bil-dynamikkV27
    - Ny rad i lagerplanen: SKF på svinghjulsakselen, tørre lagre på hjulakslene
    Claude-Session: https://claude.ai/code/session_01MwiS8GUf37qzo8gePCfvB9
2026-11-08 Slå sammen kravene til R1–R8 (R1–R4 og R10–R12 samlet)
    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
2026-11-08 Legg til figur av de fire drivverkversjonene og rett hjulakslene til printet Ø6
    Fusion-skriptet KERS_drivverk_versjoner bygger versjon 1–4 med tenner, lagrer f3d og
    sidebilder, og drivverk_versjoner_figur.py setter dem sammen med markeringer.
    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
2026-11-08 Regn de simulerte distansene i 5.1 og 5.3.4 på nytt med dagens modell
    Drivverkversjonene og følsomheten for rullemotstand og friksjon er nå regnet
    for den ferdige bilen (0,27 kg, tørre lagre, 2700 o/min) i stedet for med
    forutsetningene fra konseptfasen.
    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
2026-11-10 Ton ned simuleringen og omtal ESP-måleren som hjelpeverktøy
    Simuleringsavsnittet er kortet ned til ett avsnitt uten likninger,
    parametertabell og figur, og sammenligningene med simuleringen er
    fjernet fra resultater, diskusjon og konklusjon. Testmetoden beskriver
    nå bare turtallsmåleren (ESP32 med Hall-sensor) kort.
    Claude-Session: https://claude.ai/code/session_01MwiS8JRdmShURc6NkN6uqR
2026-11-10 Rett lagertallene: de tørre lagrene var ikke kjørt inn 7. november
    Etter innkjøring ga de tørre 626-lagrene samme tap som SKF (rundt 0,2 mNm).
    Fjern påstandene om en firedel av tapet og 30 % lengre distanse, legg serien
    fra 10. november inn i lagerfiguren og oppgi innkjøringen som medårsak til
    økningen mellom kjøretestene.
    Claude-Session: https://claude.ai/code/session_01MwiS8HQCRRgdeMNk5U6XMa
2026-11-10 Oppdater R1, fjern tomme vedleggsdeler og utvid KI-erklæringen
    Lengden er målt til under 140 mm på bilen, så R1 står som oppfylt.
    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
